Mo-Barakat/Master-Thesis/Figures/Mechanical Assembly/body_printing.jpg

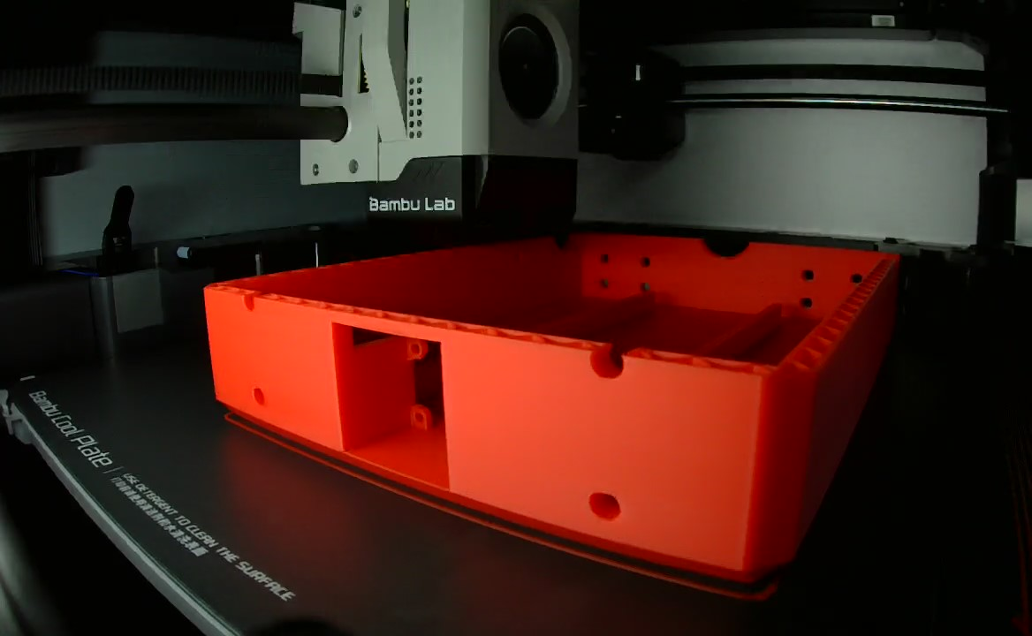
Figures/Mechanical Assembly/body_printing.jpg
