Mo-Barakat/Master-Thesis/Figures/Mechanical Assembly/chassis_assembled.jpg

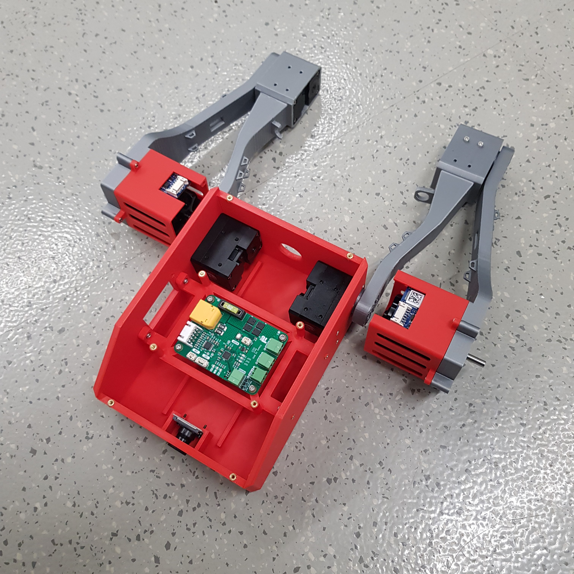
Figures/Mechanical Assembly/chassis_assembled.jpg
