Mo-Barakat/Master-Thesis/Content/Design.tex

\chapter{Random(Erase)}

\graphicspath{{./Figures/Design}}

\begin{itemize}
	\item hardware.
	\begin{itemize}
		\item motors
			\begin{itemize}
				\item Hip motor is enclosed in the body.
				\item the knee motors are enclosed in cover.
				\item the wheels motors have a
			\end{itemize}
		\item wiring
		\begin{itemize}
			\item where the wires are neatly fastened in a predetermined route so that it wouldn't be caught in the robot movement which would cause damage to the robot and also to protect them from damage.
			\item the correct type were used to avoid overheating upon the draw of current from the divers.
			\item Rs-485 connection between motors where used to avoid additional cables.
		\end{itemize}

		\item proximity sensor
		\begin{itemize}
			\item  placed in the front and back side of the robot would help to detect crashing in trivial positions such as running into a wall and that could be easily prevented by proximity sensor monitoring the distance between the robot the and the obsticals in it direction.
		\end{itemize}

		\item body safety additional parts in case of impact to protect the internal components.
	\end{itemize}
	\item software.

\end{itemize}

Questions to answer in each section

\begin{enumerate}
	\item what is going to be in here?
	\item how long or how elaborate?
	\item what is the purpose (the take home message)?
\end{enumerate}

Table of content Draft
\begin{enumerate}
	\item Introduction
	\begin{enumerate}
		\item Background and Motivation
		\begin{enumerate}
			\item Discuss the evolution and significance of robotics in various industries.
			\item Emphasize the need for advancements in robotic stability and mobility.
		\end{enumerate}

		\item Problem Statement
		\begin{enumerate}
			\item Define the specific challenges in designing a legged self-balancing robot.
		\end{enumerate}
		\item Objectives(Outline the primary goals of the thesis)
	\end{enumerate}
	\item Literature Review
	\begin{enumerate}
		\item Overview of Robotics
		\item Previous Work in Self-Balancing Robots
		\item Control Strategies
		\begin{enumerate}
			\item what is going to be in here? a comparison of the control strategies used.
			\item how long or how elaborate? not too detailed but with more explanation of the control theory used in the project
			\item what is the purpose (the take home message)? pros and cons of the different and why would we prefer one of them over the other depending on the applications
		\end{enumerate}
	\end{enumerate}
	\item Design and Development of the Robot
	\begin{enumerate}
		\item Mechanical Design
		\begin{enumerate}
			\item Initial calculations
			\begin{enumerate}
				\item what is going to be in here? -> torque initial calculations
				\item how long or how elaborate? -> two or three scenarios
				\item what is the purpose (the take home message)? for choosing the correct motors
			\end{enumerate}
			\item design
			\begin{enumerate}
				\item what is going to be in here?-> CAD design and the explanations of the challenges
				\item how long or how elaborate? detailed explanations of the reason behind the design decision
				\item what is the purpose (the take home message)? assembling the robot with fitting parts to match the new model requirements
			\end{enumerate}
			\item Modeling
			\begin{enumerate}
				\item what is going to be in here?-> the figures for the new model and the new COG and MOI calculations and the equations of motion.
				\item how long or how elaborate? 4 to 5 pages explaining the equations in details
				\item what is the purpose (the take home message)? showing the calculations for the new model and it would influence the equations of motion.
			\end{enumerate}
		\end{enumerate}
		\item Electrical Design
		\begin{enumerate}
			\item what is going to be in here? Component diagram showing the choice of all the components and there intended use and why we chose each of these components
			\item how long or how elaborate? detailed explanation of the  requirement boards for operating the robot, the choice of components based calculations for the motors.
			\item what is the purpose (the take home message)? show how the Electrical design is configured in the optimal way to operate the robot
		\end{enumerate}
		\item Software and Control
		\begin{enumerate}
			\item Control Algorithm
			\begin{enumerate}
				\item what is going to be in here?->flowchart of the Control Algorithm
				\item how long or how elaborate?-> detailed explanation of the used control theory
				\item what is the purpose (the take home message)? -> how the control is implemented
			\end{enumerate}
			\item Firmware
		\end{enumerate}
		\item Safety
		\begin{enumerate}
			\item what is going to be in here? different design changes for safety measures(motors covers, wire routing, body bumper, distance sensor , algorithm safety, electrical safety )
			\item how long or how elaborate? 1 or two pages max that include the
			\item what is the purpose (the take home message)? the safety measures taken to minimize crashes, failure
		\end{enumerate}
	\end{enumerate}
	\item Experimental Setup and Methodology
	\begin{enumerate}
		\item Simulation Environment
		\item Physical Prototype Testing
		\item Data Collection and Analysis
	\end{enumerate}
	\item Results and Discussion
	\begin{enumerate}
		\item Simulation Results
		\item Real-world Performance
		\item Comparison and Analysis
	\end{enumerate}
	\item Conclusion and Future Work
	\begin{enumerate}
		\item Summary of Findings
		\item Contributions
		\item Recommendations for Future Research
	\end{enumerate}
\end{enumerate}

\begin{todobox}
	content..
\end{todobox}
\begin{itemize}
	\item The Robot new design.
	\item The added degrees of freedom.
	\item Different motions that can be performed.
	\item Discussing each component of the robot and things taken into account while designing it.
	\begin{itemize}
		\item Body
		\begin{itemize}
		\item overall design inspiration
		\item For the body: the consideration for including all the necessary components in a compact form is to optimize the use of space and at the same time distribute the weight equally.
		\item The body includes the hip motors, the battery, camera, sensor, a rack that includes the motors drivers board, the micro-controller board attached to the Raspberry Pi.
		\item fastening features that were specifically designed in order to easily mount the battery, organize the cable between the boards and the rest of the robot parts.
		\item Features for modular design and easy printing.
		\end{itemize}
			\item Thigh
		\begin{itemize}
			\item curvature of that joint to give room for the motors 
			\item cable management 
			\item motor cover to insure its fixation. 
		\end{itemize}
			\item Calf
		\begin{itemize}
			\item curvature of that joint and the thigh joint combined make enough room for the wheel motor so the it have clearance from the body. 
			\item cable management 
			\item motor mount and additional frame.
		\end{itemize}
	\end{itemize}
\end{itemize}

\begin{itemize}
	\item electronic components 
	\begin{itemize}
		\item Motors taking into count the needed torque and speed
		\item comparison between the BLDC and Geared Robotic 
		\item RS-485 communications protocol compared to others 
		\begin{itemize}
			\item for the knee and hip motors high torque and low speed is needed.(calculations the show the weights and the needed torques)
			\item for the wheel motors high speed and low torque is needed. 
		\end{itemize}
		\item Boards 
		\begin{itemize}
			\item STM high performance h7 constum board connected with rasberrypi 
			\item driver board that provide the power for 6 motors. 
		\end{itemize}
		\item modules 
		\begin{itemize}
			\item camera module.
			\item distance sensor.
		\end{itemize}
	\end{itemize}
\end{itemize}

\begin{itemize}
	\item hardware.
	\begin{itemize}
		\item motors
			\begin{itemize}
				\item Hip motor is enclosed in the body.
				\item the knee motors are enclosed in cover.
				\item the wheels motors have a
			\end{itemize}
		\item wiring
		\begin{itemize}
			\item where the wires are neatly fastened in a predetermined route so that it wouldn't be caught in the robot movement which would cause damage to the robot and also to protect them from damage.
			\item the correct type were used to avoid overheating upon the draw of current from the divers.
			\item Rs-485 connection between motors where used to avoid additional cables.
		\end{itemize}

		\item proximity sensor
		\begin{itemize}
			\item  placed in the front and back side of the robot would help to detect crashing in trivial positions such as running into a wall and that could be easily prevented by proximity sensor monitoring the distance between the robot the and the obsticals in it direction.
		\end{itemize}

		\item body safety additional parts in case of impact to protect the internal components.
	\end{itemize}
	\item software.

\end{itemize}

Questions to answer in each section

\begin{enumerate}
	\item what is going to be in here?
	\item how long or how elaborate?
	\item what is the purpose (the take home message)?
\end{enumerate}

Table of content Draft
\begin{enumerate}
	\item Introduction
	\begin{enumerate}
		\item Background and Motivation
		\begin{enumerate}
			\item Discuss the evolution and significance of robotics in various industries.
			\item Emphasize the need for advancements in robotic stability and mobility.
		\end{enumerate}

		\item Problem Statement
		\begin{enumerate}
			\item Define the specific challenges in designing a legged self-balancing robot.
		\end{enumerate}
		\item Objectives(Outline the primary goals of the thesis)
	\end{enumerate}
	\item Literature Review
	\begin{enumerate}
		\item Overview of Robotics
		\item Previous Work in Self-Balancing Robots
		\item Control Strategies
		\begin{enumerate}
			\item what is going to be in here? a comparison of the control strategies used.
			\item how long or how elaborate? not too detailed but with more explanation of the control theory used in the project
			\item what is the purpose (the take home message)? pros and cons of the different and why would we prefer one of them over the other depending on the applications
		\end{enumerate}
	\end{enumerate}
	\item Design and Development of the Robot
	\begin{enumerate}
		\item Mechanical Design
		\begin{enumerate}
			\item Initial calculations
			\begin{enumerate}
				\item what is going to be in here? -> torque initial calculations
				\item how long or how elaborate? -> two or three scenarios
				\item what is the purpose (the take home message)? for choosing the correct motors
			\end{enumerate}
			\item design
			\begin{enumerate}
				\item what is going to be in here?-> CAD design and the explanations of the challenges
				\item how long or how elaborate? detailed explanations of the reason behind the design decision
				\item what is the purpose (the take home message)? assembling the robot with fitting parts to match the new model requirements
			\end{enumerate}
			\item Modeling
			\begin{enumerate}
				\item what is going to be in here?-> the figures for the new model and the new COG and MOI calculations and the equations of motion.
				\item how long or how elaborate? 4 to 5 pages explaining the equations in details
				\item what is the purpose (the take home message)? showing the calculations for the new model and it would influence the equations of motion.
			\end{enumerate}
		\end{enumerate}
		\item Electrical Design
		\begin{enumerate}
			\item what is going to be in here? Component diagram showing the choice of all the components and there intended use and why we chose each of these components
			\item how long or how elaborate? detailed explanation of the  requirement boards for operating the robot, the choice of components based calculations for the motors.
			\item what is the purpose (the take home message)? show how the Electrical design is configured in the optimal way to operate the robot
		\end{enumerate}
		\item Software and Control
		\begin{enumerate}
			\item Control Algorithm
			\begin{enumerate}
				\item what is going to be in here?->flowchart of the Control Algorithm
				\item how long or how elaborate?-> detailed explanation of the used control theory
				\item what is the purpose (the take home message)? -> how the control is implemented
			\end{enumerate}
			\item Firmware
		\end{enumerate}
		\item Safety
		\begin{enumerate}
			\item what is going to be in here? different design changes for safety measures(motors covers, wire routing, body bumper, distance sensor , algorithm safety, electrical safety )
			\item how long or how elaborate? 1 or two pages max that include the
			\item what is the purpose (the take home message)? the safety measures taken to minimize crashes, failure
		\end{enumerate}
	\end{enumerate}
	\item Experimental Setup and Methodology
	\begin{enumerate}
		\item Simulation Environment
		\item Physical Prototype Testing
		\item Data Collection and Analysis
	\end{enumerate}
	\item Results and Discussion
	\begin{enumerate}
		\item Simulation Results
		\item Real-world Performance
		\item Comparison and Analysis
	\end{enumerate}
	\item Conclusion and Future Work
	\begin{enumerate}
		\item Summary of Findings
		\item Contributions
		\item Recommendations for Future Research
	\end{enumerate}
\end{enumerate}

\begin{todobox}
	content..
\end{todobox}
