Mo-Barakat/Master-Thesis/Settings/Projekteinstellungen.tex

% Front matter
\newcommand*{\Titel}{Design and Control of a Multi-Joint Two-Wheeled Inverted Pendulum Robot for Agile Motion Learning}
\newcommand*{\Untertitel}{Exploiting Similarity for Data-Driven Input Trajectory Transfer}
% Header title
\newcommand*{\HeaderTitel}{Design and Control of a Multi-Joint Two-Wheeled Inverted Pendulum Robot}

% Main author
%\newcommand*{\Autor}{Philipp Drebinger}
\newcommand*{\AutorMatrikelNr}{10044038}

\newcommand{\Autor}%                % Author's name
{Mohamed Barakat}
\newcommand{\Matrikelnummer}%       % Matriculation number
{10044038}
\newcommand{\Datum}%                % Submission date
{15. January 2024}

\newcommand{\TitelDerArbeit}%       % Title of the work
{Design and Control of a Multi-Joint Two-Wheeled Inverted Pendulum Robot for Agile Motion Learning}

\newcommand{\Kennnummer}%           % Here enter the identifier number of the work. You will receive this shortly before submission from your supervisor
%{M-MM/JJJJ-XXXXX}
{M-01/2024-1234}
%{M-Month/Year-Number}

\newcommand{\ArtDerArbeit}%         % Type of work. Please enter whether Master's thesis, Bachelor's thesis, or study thesis
{Master's thesis} 
%{Bachelor's thesis}
%{Study thesis}

\newcommand{\Erstpruefer}%          % Enter the name of the first examiner here
{Prof. Dr.-Ing. Thomas Seel}
\newcommand{\Zweitpruefer}%         % Enter the name of the second examiner here
{Prof. Dr.-Ing. J\"org Wallaschek}
\newcommand{\Betreuer}%             % Enter the name of the research assistant supervisor here
{Dustin Lehmann}

% Manually set date with location
%\newcommand*{\Datum}{Berlin, the 16th of March 2023}

% University, faculty, institute, and department
\newcommand*{\Uni}{Technische Universit\"at Berlin}
\newcommand*{\Fakultaet}{Fakult\"at IV}
\newcommand*{\Institut}{Institut f\"ur Energie- und  Automatisierungstechnik}
\newcommand*{\Fachgebiet}{Control Systems Group}

% Professor and supervisor
\newcommand*{\Professor}{Prof. Dr.-Ing. J\"org Raisch}
\newcommand*{\ProfessorII}{Prof. Dr.-Ing. Clemens G\"uhmann}
\newcommand*{\BetreuerA}{M.Sc. Dustin Marlon Lehmann}
\newcommand*{\BetreuerB}{}

% Additional authors
\newcommand*{\AutorB}{}
\newcommand*{\AutorBMatrikelNr}{}
\newcommand*{\AutorC}{}
\newcommand*{\AutorCMatrikelNr}{}
\newcommand*{\AutorD}{}
\newcommand*{\AutorDMatrikelNr}{}
\newcommand*{\AutorE}{}
\newcommand*{\AutorEMatrikelNr}{}

% Group indication or just "submitted by:"
\newcommand*{\Gruppe}{by}

% Setting the print version: print or PDF view only
\def\typeDrucken{1}  % For printing (do not change)
\def\typePDFonly{2}  % For PDF-only use (do not change)
% Set the appropriate switch here! =\typeDrucken or =\typePDFonly
\let\pdftype=\typeDrucken

% Definition of whether to set single or double-sided
\def\typeOnepage{1}  % For single-sided setting
\def\typeTwopage{2}  % For double-sided setting
% Set the appropriate switch here! =\typeOnepage or =\typeTwopage
\let\pagetype=\typeOnepage

% Binding correction at the inner margin
\newlength{\bindCorrection}                % Declaration, do not change
\setlength{\bindCorrection}{0cm}           % Assignment, can be changed

% PDF output version via Minor number => 1.x
\pdfminorversion=5

% CUSTOM
% Colorful: 1, Plain: 2
\def\colorfulLayout{1}
