Mo-Barakat/Master-Thesis/Content/BodyMatter.tex

% Page numbers of the content in Arabic numerals
\pagenumbering{arabic}

% Content

% Inserting the files, e.g.:
%\include{Content/Introduction}
%\include{Content/Chapter1}
%\include{Content/Conclusion}

% Then insert chapters in the files.
% % % % % % % % % % % % % % % % % % % % % % % % % % % % % % % % % % % % % % % % % % % % % % %
\input{Content/Introduction}
\input{Content/Literature Review}
\input{Content/Mechanical Design}
\input{Content/Electronic Design}
\input{Content/Modelling and Simulation}
\input{Content/Mechanical Assembly}
\input{Content/Firmware and Testing}
\input{Content/Conclusion and Future work}
%\input{Content/Safety}
%\input{Content/Design}
% % % % % % % % % % % % % % % % % % % % % % % % % % % % % % % % % % % % % % % % % % % % % % %

% Conclude Body Matter
\clearpage
