Mo-Barakat/Master-Thesis/FrontBackMatter/BackMatter.tex

% Roman numerals for Back Matter - continue page numbering from Front Matter
\pagenumbering{Roman}
\addtocounter{RomanNumbers}{1}
\setcounter{page}{\value{RomanNumbers}}

% If desired, uncomment the index
\printindex

% If desired, uncomment the bibliography
\bibliography{Bibliographie/Bibliographie}

% Conclude Back Matter
\clearpage
