Mo-Barakat/Master-Thesis/FrontBackMatter/Erklaerung.tex

\chapter*{Eigenst\"andigkeitserkl\"arung}
\label{cha:Ehrenwort}
\thispagestyle{empty}
Hiermit erkl\"are ich, dass ich die vorliegende Arbeit selbstst\"andig und eigenh\"andig sowie ohne
unerlaubte fremde Hilfe und ausschlie\ss lich unter Verwendung der aufgef\"uhrten Quellen und
Hilfsmittel angefertigt habe.

\vspace{3cm}

\begin{tabular}{lp{4em}l}
 \hspace{4cm}   && \hspace{4cm} \\ \cline{1-1} \cline{3-3} \rule{0pt}{3.5ex} 
 Ort, Datum     && \Autor
\end{tabular}
