Mo-Barakat/Master-Thesis/Glossary/Abkuerzungen.tex

% Beispiel für eine Abkürzung: 
% \newacronym{led}{LED}{light-emitting diode}

\newacronym[longplural={lower-triangular Toeplitz matrices}]{lttm}{LTTM}{lower-triangular Toeplitz matrix}

\newacronym{lti}{LTI}{linear time-invariant}

\newacronym{lqr}{LQR}{linear-quadratic regulator}

\newacronym{siso}{SISO}{single-input single-output}

\newacronym{ipc}{IPC}{inverted pendulum on a cart}

\newacronym{twipr}{TWIPR}{two-wheeled inverted pendulum robot}

\newacronym{ilc}{ILC}{iterative learning control}

\newacronym{pca}{PCA}{principle component analysis}

\newacronym{svd}{SVD}{singular value decomposition}

\newacronym{nrmse}{NRMSE}{normalized root-mean-square error}

\newacronym{nrms}{NRMS}{normalized root-mean-square}

\newacronym{rmse}{RMSE}{root-mean-square error}

\newacronym{rms}{RMS}{root-mean-square}

\newacronym{mas}{MAS}{multi-agent system}

\newacronym{prbs}{PRBS}{pseudorandom binary sequence}

\newacronym{bibo}{BIBO}{bounded-input bounded-output}

\newacronym{gp}{GP}{Gaussian Process}

\newacronym{rc}{RC}{remote control}

%\newacronym{todo}{\textbf{ToDo \hfill}}{To-Do List}%just to keep track of todo boxes
