Mo-Barakat/Master-Thesis/out/Master_Thesis.pdf

# Institut für Mechatronische Systeme

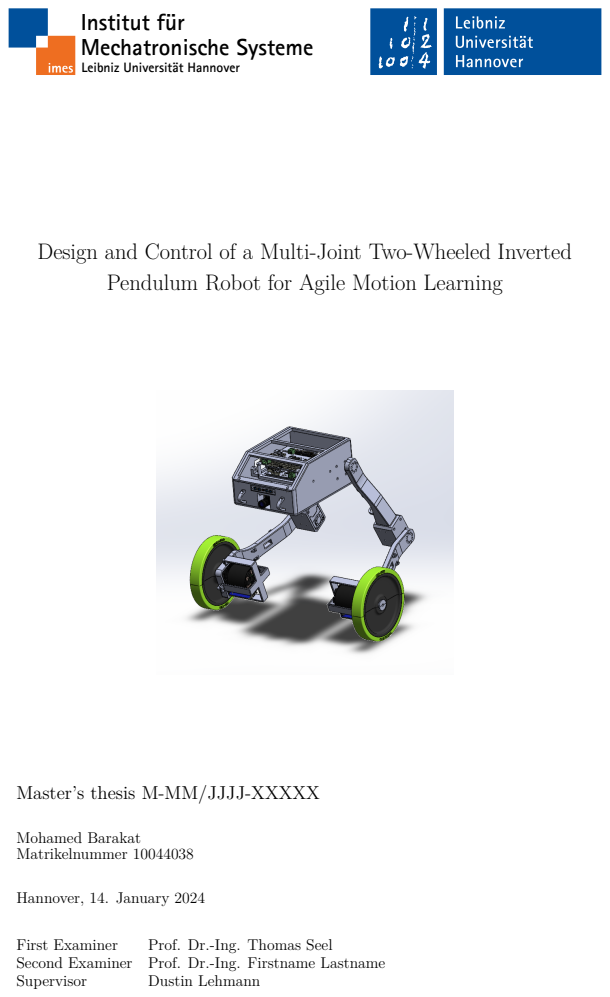
[picture p3: page 1]
Mohamed Barakat Matrikelnummer 10044038; Hannover, 14. January 2024; First Examiner; Prof. Dr.-Ing. Thomas Seel; Supervisor; Dustin Lehmann

Leibniz Universität Hannover

Design and Control of a Multi-Joint Two-Wheeled Inverted

Pendulum Robot for Agile Motion Learning

Master’s thesis M-MM/JJJJ-XXXXX

Second Examiner Prof. Dr.-Ing. Firstname Lastname

# Institut für Mechatronische Systeme

## Leibniz Universität Hannover

# Declaration of Authorship

## M-MM/JJJJ-XXXXX

Name: | Mohamed Barakat
Registration no.: | 10044038
Thesis title: | Design and Control of a Multi-Joint Two-Wheeled Inverted Pendulum
| Robot for Agile Motion Learning
Type of thesis: | Master’s thesis
Study program: | Mechanical Engineering
Submission date: | 14. January 2024
First examiner : | Prof. Dr.-Ing. Thomas Seel
Second examiner: | Prof. Dr.-Ing. Firstname Lastname
Supervisor: | Dustin Lehmann

I, Mohamed Barakat, hereby affirm that the Master’s thesis entitled Design and Control of a Multi-Joint Two-Wheeled Inverted Pendulum Robot for Agile Motion Learning was written independently, that no references and aids other than those indicated were used, that all passages of the thesis which were taken over literally or analogously from other sources are marked as such and that the thesis has not yet been presented to any examination board in the same or similar form.

I hereby agree to the transmission of my work also to external services for plagiarism checking by plagiarism software.

Hannover, 14. January 2024

(Mohamed Barakat)

# Eigenständigkeitserklärung

Hiermit erkläre ich, dass ich die vorliegende Arbeit selbstständig und eigenhändig sowie ohne unerlaubte fremde Hilfe und ausschließlich unter Verwendung der aufgeführten Quellen und Hilfsmittel angefertigt habe.

Ort, Datum | Mohamed Barakat

Abstract

This thesis addresses the challenge of input trajectory transfer in heterogeneous multi-agent systems, where each agent has distinct system dynamics.
The concept of transfer learning has been applied to MAS to accelerate the learning process of a target agent by leveraging previously learned trajectories from a different source agent. However, directly transferring input trajectories between agents with dissimilar dynamics can lead to unwanted behaviour. This can be overcome by applying a mapping that transforms the input trajectory of the source system into an appropriate input trajectory for a target system so that their outputs match. Obtaining such an input transfer map from simple experiments is difficult, so previous research often focuses on output transfer, adaptive control or strong similarity assumptions. Those approaches either require extensive model knowledge or have limited usability.

This thesis provides a comprehensive understanding of trajectory transfer, distinguishing the input and output transfer cases and highlighting their similarities. Those insights are then used to propose a simple, data-driven method to estimate a dynamic input transfer map for SISO systems that addresses the aforementioned problem. Structural similarity in the systems is leveraged to simplify the estimation process further. The transfer map is estimated as a lifted system matrix and a transfer function. The performance of the estimated dynamic input transfer map is compared to a static map using a simple gain and to the direct transfer of the input trajectories.

It is shown that input and output transfer are equivalent under certain conditions. An input transfer map based on this assumption was able to significantly reduce the differences between a source and a target system in three simulated scenarios. This even includes scenarios where the systems have nonlinear, non-minimum phase dynamics.
Compared to a static map, the performance of a dynamic input transfer is superior, especially in cases where the estimated transfer map is applied to input trajectories which are not part of the training data. Furthermore, the dynamic input transfer map can have a model order lower than the theoretically expected order of the transfer system, given that the source and target systems are related. Therefore, the expected order only provides an upper limit for the order of an estimated transfer map, and not a recommended choice.
Nonetheless, this thesis alone does not fully explore the potential and limitations of the proposed method. Future research is necessary to address these topics further.

Keywords— input transfer, trajectory transfer, transfer learning, multi-agent systems

Design and Control of a Multi-Joint Two-Wheeled Inverted Pendulum Robot | VI

# Contents

List of Figures | VIII
List of Tables | IX
1 Introduction | 1
2 Literature Review | 3
3 Mechanical Design | 4
4 Electronic Design | 6
5 Modelling and Simulation | 7
6 Mechanical Assembly | 13

Contents

Design and Control of a Multi-Joint Two-Wheeled Inverted Pendulum Robot | VII
7 Firmware and Testing | 14
8 Safety | 16
9 Random(Erase) | 19
Bibliography | X

Contents

Design and Control of a Multi-Joint Two-Wheeled Inverted Pendulum Robot | VIII

# List of Figures

5.1 Mechanical model with the local coordinate system | | 9
5.2 Moment of inertia Schematic representation | | 10
9.1 Moment of inertia Schematic representation | | 19
9.2 Moment of inertia Schematic representation | | 21

List of Figures

Design and Control of a Multi-Joint Two-Wheeled Inverted Pendulum Robot | IX

# List of Tables

5.1 Parameters of the mechanical system | 12

List of Tables

Design and Control of a Multi-Joint Two-Wheeled Inverted Pendulum Robot | 1

# 1 Introduction

## 1.1 Motivation

This section should explore the underlying reasons for undertaking the research. It might include the importance of the topic, the gap in current knowledge, and the potential applications of the research findings.

Robotics has always been a cutting-edge field that combines sophisticated engineering, artificial intelligence, and a comprehension of human-environment interactions. This study is motivated by multiple important elements, all of which highlight the importance and relevance of the research.

Advancements in Robotic Technologies: Robotics has grown at an exponential rate over the past few decades, resulting in improved capabilities and more applications. Previously limited to industrial settings, robots are now being deployed in increasingly dynamic and unpredictable circumstances. The development of robotic systems that are more flexible, nimble, and intelligent is required due to this evolution. Our research is to create a sophisticated multi-legged robotic system that can perform intricate movements and interact with its surroundings.

Filling Knowledge Gaps: Even with significant advancements, there are still many unanswered questions about robotic control and locomotion, particularly in systems that replicate biological structures and processes. Complex dynamic tasks that living beings handle with ease are sometimes difficult for traditional robotic systems to accomplish. This research aims to close these gaps by concentrating on a multi-legged robot that finds inspiration in the natural environment. This will provide insights into more realistic and effective movement tactics.

Potential for Broad Impact: The applications of such advanced robotic systems are vast and varied, ranging from search and rescue operations in hazardous environments to assistive technology in healthcare. By pushing the boundaries of what is currently possible in robotic design and control, this research has the potential to make significant contributions to fields where human intervention is limited, dangerous, or impractical.

Interdisciplinary Collaboration and Innovation: This project is inherently interdisciplinary, integrating concepts from mechanical engineering, computer science, control theory, and even biology. Such cross-disciplinary collaboration is crucial for driving innovation, as it allows for the exchange of ideas and methods from diverse fields. This approach is expected to yield novel solutions and advancements that could extend well beyond the scope of this project.

In summary, the motivation for this project lies in its potential to advance the field of robotics, fill existing knowledge gaps, have a broad societal impact, and foster interdisciplinary collaboration. By developing a multi-legged robotic system with enhanced movement capabilities and control strategies, this research endeavors to set new standards in robotic design and functionality.

Chapter 1. Introduction

Design and Control of a Multi-Joint Two-Wheeled Inverted Pendulum Robot | 2

## 1.2 Explanation of the Goals and Requirements

Here, you should clearly outline the objectives and aims of the research. This might include specific technical goals, hypotheses to be tested, or particular research questions to be addressed. Also, detail any specific requirements necessary for the research, such as technological needs, data requirements, or theoretical frameworks.

Chapter 1. Introduction – Explanation of the Goals and Requirements

Design and Control of a Multi-Joint Two-Wheeled Inverted Pendulum Robot | 3

# 2 Literature Review

## 2.1 Overview of Two-Wheeled Inverted Pendulum Robots

## 2.2 Prior Works and Advances in Multi-Legged Robotic Systems

This section should provide a comprehensive review of existing literature relevant to your research topic. It should cover key theories, models, experiments, and findings in the field, particularly focusing on works that directly relate to your research question or hypothesis. This review not only shows your understanding of the field but also how your work fits into and contributes to the existing body of knowledge.

## 2.3 State-of-the-Art in Robotic Control Systems

Chapter 2. Literature Review

Design and Control of a Multi-Joint Two-Wheeled Inverted Pendulum Robot | 4

# 3 Mechanical Design

Modeling In this chapter, the details of the mechanical design is presented. where it goes from the initial conceptual design to the final design showing in the process the design decision-making for each critical point.This chapter emphasis the detailed description of the precise placement and alignment of different components such as the motors, wheels, battery, boards, and others to maintain the seamless integration of all the components into the robot body.
The mechanical design serves as an important pillar to define the new physical form, size, and shape of the TWIPR. Depending on how these criteria are defined, the robot would interact with the environment. taking into account that the design directly influences the center of gravity which is crucial to consider in our robot due to the inverted pendulum nature to be able to balance and maintain the upright position. In addition to the impact that the design has on the maneuverability of the robot and how it would respond to the control signals to be able to execute a task.

Chapter 3. Mechanical Design

Design and Control of a Multi-Joint Two-Wheeled Inverted Pendulum Robot | 5

## 3.1 Design Objectives and Requirements

The main objective is to come up with a new design for a multiple joints Robot to perform complex dynamic movements. this robot would be based on the Two wheeled inverted pendulum robot. The new design would add more degrees of freedom to enable the more complex movements.This enhances the robot capabilities where it can execute more diverse scenarios. Initially the main requirement was to add more two degrees of freedom where originally it used to have one degree of freedom in the wheels.The new design has three degrees of freedom one in the wheels, one as a knee joint and one as a hip joint. The current design has two identical legs.

## 3.2 Conceptual Design

As for the initial design concepts the body was that main point of focus as shown in the figure.Three initial designs where considered mainly for the body. Symmetrical horizontal body, leaning forwardsbody, and symetrical vertical body. For the three designs two independant legs where considered. two designs where considered for the legs the normal joint leg and the complient leg

## 3.3 Detailed Design Development

- Elaborate on the development of the detailed mechanical design.
- Discuss material selection and the rationale behind these choices.
- Include detailed CAD drawings and design schematics.

## 3.4 Design for Manufacturability and Assembly

- Discuss how the design facilitates manufacturing and assembly..
- Explain any design choices made to simplify these processes of manufacturing and assembly.

## 3.5 Prototyping and Iterative Design

- Discuss the process of prototyping.
- Explain how feedback from prototyping phases was incorporated into design revisions.

Chapter 3. Mechanical Design – Design Objectives and Requirements

Design and Control of a Multi-Joint Two-Wheeled Inverted Pendulum Robot | 6

# 4 Electronic Design

- Overview of the chapter’s focus.
- Emphasize the importance of electronic design in the context of the overall project.

## 4.1 Design Objectives and Constraints

- Clearly define the objectives and goals for the electronic design
- Discuss any constraints such as power requirements, size limitations.

## 4.2 Component Selection

- Detail the selection process for key electronic components like microcontrollers, sensors, actuators, power supplies, etc.
- Rationale behind the choice of each component, focusing on specifications and performance requirements.

## 4.3 Circuit Design

- Provide comprehensive information about the circuit design, including schematic diagrams.
- Explain the functionality and interaction of different circuit components.
- Discuss the design considerations for signal integrity, power distribution, and noise reduction.

## 4.4 PCB (Printed Circuit Board) Design

- Describe the layout and design of any custom PCBs used in the project.
- Include information about PCB fabrication and assembly processes.

## 4.5 Power Management

- Discuss how power is managed and distributed within the system.
- Include details on battery management, voltage regulation, and power efficiency considerations.

Chapter 4. Electronic Design

Design and Control of a Multi-Joint Two-Wheeled Inverted Pendulum Robot | 7

# 5 Modelling and Simulation

In this pivotal chapter, we meticulously derive the center of gravity and the moment of inertia for the two-wheeled self-balancing robot. These parameters are the linchpins of our dynamic analysis, serving as the critical variables within the equations of motion that govern the robot’s behavior. By calculating these values with precision, we can substitute them into our dynamic equations, thereby tailoring the model to reflect the true dynamics of the robot. This process not only enhances the accuracy of our simulations but also ensures that the control strategies developed are based on a robust and representative model of the robot’s physical capabilities. The careful derivation of these parameters is a testament to the thoroughness of our approach, ensuring that the resulting model is both reliable and predictive of the robot’s real-world performance.

Chapter 5. Modelling and Simulation

Design and Control of a Multi-Joint Two-Wheeled Inverted Pendulum Robot | 8

## 5.1 Mathematical Modelling

- TWIPR Model: Explanation of the Two-Wheeled Inverted Pendulum Robot (TWIPR) model.

The two wheeled Inverted Pendulum robot model is as shown in the figure where it consist of two legs that include a hip and knee joints as well as wheels at the end of each leg. the robot needs to constantly adjust it posture to be able to maintain the balance, just like how the humanbeing balance when standing on the feet.

- Focus on 2D Dynamics: Discussion on the scope limited to 2D dynamics and plans for future expansion to 3D dynamics and controller synthesis.
- Assumptions and Parameters: Detailing assumptions such as considering motor angles as parameters.
- Model Derivation for l_cg and I_y: Derivation of the models for center of gravity length (l_cg) and inertia around the y-axis (I_y).
- Integration into TWIPR Model: Integration of derived models into a new TWIPR framework.
- Linear Model Derivation: Derivation of the linear model from the integrated TWIPR model.
- Modeling allows for predictive analysis and understanding of the robot’s behavior.

In order to predict the behavior of the robot under different settings, the modeling procedure entails constructing mathematical representations of the robot’s dynamics and control systems.

Center of Gravity calculations

### 5.1.1 Center of Gravity

- in that section the calculations of the overall center of gravity
- Significance in Dynamics:The stability of an object is directly impacted by the COG position, which also affects how it reacts to forces and moments from the outside world.
- maintain equilibrium,
- accurately determining the COG is crucial for predicting and controlling dynamic behavior

in the above figure in order to simplify the deriviation of the center of

xCG =

mL1 · 0 + mK · 0 + mL2 · LC2 · sin(φ2) + mB · (L2 · sin(φ2) + LC3 · sin(φ2 + φ3)) mL1 + mL2 + mK + mB

(5.1)

yCG =

mL1 · LC1 + mK · L1 + mL2 · (L1 + LC2 · cos(φ2)) + mB · (L1 + L2 · cos(φ2) + LC3 · cos(φ2 + φ3)) mL1 + mL2 + mK + mB
(5.2)

LG =

√︁
x

2
CG + y

2
CG | (5.3)

θ = arctan (︂
xCG

yCG )︂
(5.4)

Chapter 5. Modelling and Simulation – Mathematical Modelling

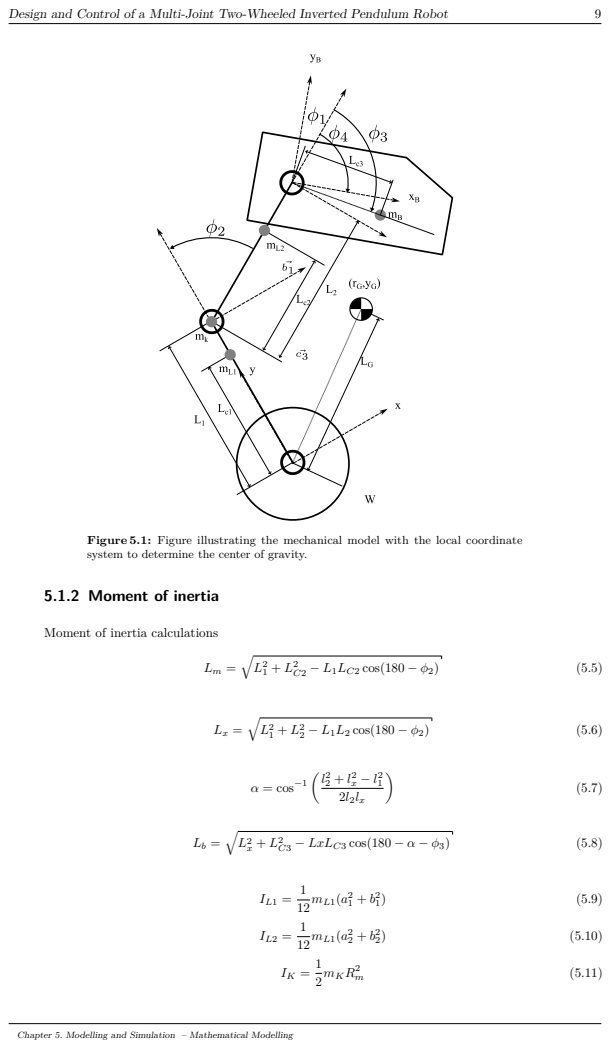
[picture p4: page 18]
Design and Control of a Multi-Joint Two-Wheeled Inverted Pendulum Robot; C2 − L1LC2 cos(180 − φ2); 2 − L1L2 cos(180 − φ2); α = cos⁻¹; C3 − LxLC3 cos(180 − α − φ3); mKR

Figure 5.1: Figure illustrating the mechanical model with the local coordinate
system to determine the center of gravity.

5.1.2 Moment of inertia

Moment of inertia calculations

Chapter 5. Modelling and Simulation – Mathematical Modelling

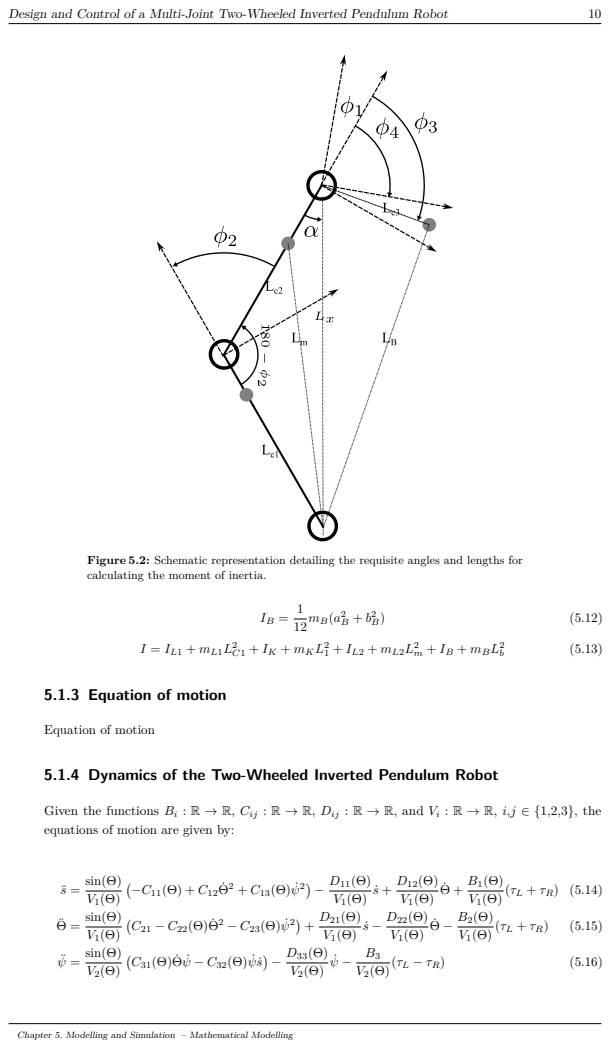
[picture p5: page 19]
Design and Control of a Multi-Joint Two-Wheeled Inverted Pendulum Robot; 2 C1 + IK + mKL; 2 m + IB + mBL; : R → R, i,j ∈ {1,2,3}, the; sin(Θ)

Figure 5.2: Schematic representation detailing the requisite angles and lengths for
calculating the moment of inertia.

5.1.3 Equation of motion

Equation of motion

5.1.4 Dynamics of the Two-Wheeled Inverted Pendulum Robot

Given the functions Bi
equations of motion are given by:

: R → R, Cij : R → R, Dij : R → R, and Vi

Chapter 5. Modelling and Simulation – Mathematical Modelling

Design and Control of a Multi-Joint Two-Wheeled Inverted Pendulum Robot | 11

The equations of motion are derived in [44]. The functions Bi

: R → R, Cij : R → R, Dij : R → R, and Vi

: R → R, i,j ∈ {1,2,3}, are given by:

C11(Θ) = m²
Bl

2
cos(Θ), | (5.17)

C12 = (I2 + mBl

2
)mBl, | (5.18)

C13(Θ) = (I2 + mBl

2
)mBl + mBl(I3 − I1 − mBl

2

) cos²
(Θ), | (5.19)

C21 = (mB + 2mW +

2J
r

2

)mBl, | (5.20)

C22(Θ) = m²
Bl

2
cos(Θ), | (5.21)

C23(Θ) = m²
Bl

2 + (mB + 2mW +

2J
r

2

)(I3 − I1 − mBl

2
) cos(Θ). | (5.22)

C31(Θ) = 2(I3 − I1 − m²
B) cos(Θ), | (5.23)
C31 = mBl, | (5.24)

D11(Θ) = (I2 + m²
B)2cα
r

2

−

mB cos(Θ)2cα
r
, | (5.25)

D12(Θ) = (I2 + m²
B)2cα
r
− 2mB cos(Θ)cα, | (5.26)

D21(Θ) = (mB + 2mW +

2J
r

2 )2cα
r

+

mB cos(Θ)2cα
r

2

, | (5.27)

D22(Θ) = (mB + 2mW +

2J
r

)2cα + mB cos(Θ)2cα
r
, | (5.28)
D33(Θ) = | d

2
2r

2cα

, | (5.29)

B1 =

(I2 + m²
B)

1
r + mB cos(Θ)
r
, | (5.30)

B2 =

mBl
r

− cos(Θ) + mB + 2mW +

2J
r

2

, | (5.31)

B3 =

d
2r
, | (5.32)

V1 = (mB + 2mW +

2J
r

2

)(I2 + m²

B) − m²

B cos²
(Θ), | (5.33)

V2 = I3 + 2K + (mW +

J
r

2

)

d

2
2

− (I3 − I1 − m²

B) sin²
(Θ). | (5.34)

## 5.2 Numerical Simulation

- Discrete Numerical Simulation: Elaboration on the process of discrete numerical simulation, including the discrete double integration method to arrive at the state vector.

## 5.3 Simulation Environment

- Overview of the Simulation Environment: A brief overview of the simulation environment, referencing David’s Bachelor Thesis for details.

Chapter 5. Modelling and Simulation – Numerical Simulation

Design and Control of a Multi-Joint Two-Wheeled Inverted Pendulum Robot | 12

Table 5.1: Parameters of the mechanical system

Parameter | Value | Description
mB | 2.5 kg | mass of the pendulum body
mW | 0.636 kg | mass of a wheel
l | 0.026 m | distance between the wheel axis and the pendulum’s center of gravity
d | - | distance between the two wheels
J | 5.175e
| −4 kgm² | moment of inertia of a wheel w.r.t. reference frame {C} in direction of c2
K | - | moment of inertia of a wheel w.r.t. reference frame {C} in direction of c3
I1 | - | moment of inertia of pendulum’s body w.r.t. reference frame {B} in direction of b1
I2 | 0.0165 kgm² | moment of inertia of pendulum’s body w.r.t. reference frame {B} in direction of b2
I3 | - | moment of inertia of pendulum’s body w.r.t. reference frame {B} in direction of b3
cα | 4.630e
| −4 Nms | viscous friction coefficient
- Integration of the Model: Description of integrating the new TWIPR model into the simulation environment and a summary of the individual components of the model.

## 5.4 Controller Synthesis

- State-Space Controllers: Introduction to two state-space controllers: Linear Quadratic Regulator (LQR) and Pole-Placement.
- Configuration Specificity: Explanation of how these controllers are specific to one configuration (knee angle and hip angle) of the robot.
- Controller Retuning Algorithm: Presentation of an algorithm for retuning the controllers as the configuration changes.

## 5.5 Simulation Analysis

- Controller Responses: Analysis of step response and responses to other inputs using one of the controllers in different configurations.
- Impact of Non-Retuning: Discussion on the effects of not retuning the controllers.
- Influence of Leg Configuration: Analysis of how leg configuration influences the robot’s behavior.
- Controller Setting Comparisons: Comparative study of different controller settings and a comparison between LQR and Pole-Placement controllers.
- Optimal Controller Configuration: Conclusion on which controller configuration might be best suited for such a robot.

Chapter 5. Modelling and Simulation – Controller Synthesis

Design and Control of a Multi-Joint Two-Wheeled Inverted Pendulum Robot | 13

# 6 Mechanical Assembly

- Intro Overview of the chapter.
- Importance of mechanical assembly in the overall project.

## 6.1 Components Overview

- Detailed description of all mechanical components used in the robot.
- Source or method of fabrication for each component (e.g., machined parts, 3D printed elements).

## 6.2 Assembly Process

- Step-by-step explanation of the assembly process.
- Tools and techniques used in the assembly.
- Assembly sequence and rationale behind it.

## 6.3 Integration of Mechanical and Electronic Systems

- Discussion on how mechanical components interface with electronic systems.
- Challenges faced in integration and strategies employed to overcome them.

## 6.4 Troubleshooting and Problem Solving

- Discussion of any unexpected challenges or issues faced during assembly.
- How these issues were diagnosed and resolved.

## 6.5 Safety Considerations

- Safety measures taken during the assembly process.
- Design considerations for ensuring the operational safety of the robot.
- Discrete Numerical Simulation: Elaboration on the process of discrete numerical simulation, including the discrete double integration method to arrive at the state vector.

Note 6.1
the bolts used the problem to shorten them so that it wouldn’t touch the motor

Chapter 6. Mechanical Assembly

Design and Control of a Multi-Joint Two-Wheeled Inverted Pendulum Robot | 14

# 7 Firmware and Testing

- Overview of the chapter’s content and its significance in the context of the overall project.
- Briefly state the objectives of firmware development and testing procedures.

## 7.1 Firmware Development

- Discuss the development environment and tools used for firmware programming.
- Detail the architecture and design of the firmware, including flowcharts or state diagrams if applicable.
- Explain the implementation of key functionalities such as control algorithms, sensor integration, and actuator management.

## 7.2 Programming Languages and Tools

- List and describe the programming languages used for firmware development.
- Mention any specific software tools, libraries, or frameworks employed.

## 7.3 Integration with Hardware

- Discuss how the firmware interacts with and controls the hardware components.
- Explain any challenges encountered in integration and how they were resolved.

## 7.4 Testing Framework and Methodology

- Outline the testing framework used to validate the firmware.
- Describe the methodology for functional testing, including unit tests, integration tests, and system-level tests.

## 7.5 Test Cases and Scenarios

- Present the results of the testing procedures.
- Analyze these results, highlighting successful areas and identifying any issues or bugs discovered.

Chapter 7. Firmware and Testing

Design and Control of a Multi-Joint Two-Wheeled Inverted Pendulum Robot | 15

## 7.6 Debugging and Troubleshooting

- Discuss the process of debugging and troubleshooting encountered problems.
- Explain how issues were diagnosed and resolved.

Note 7.1
the bolts used the problem to shorten them so that it wouldn’t touch the motor

Chapter 7. Firmware and Testing – Debugging and Troubleshooting

Design and Control of a Multi-Joint Two-Wheeled Inverted Pendulum Robot | 16

# 8 Safety

- hardware.

– motors

∗ Hip motor is enclosed in the body.

∗ the knee motors are enclosed in cover.

∗ the wheels motors have a

– wiring

∗ where the wires are neatly fastened in a predetermined route so that it wouldn’t be caught in the robot movement which would cause damage to the robot and also to protect them from damage.

∗ the correct type were used to avoid overheating upon the draw of current from the divers.

∗ Rs-485 connection between motors where used to avoid additional cables.

– proximity sensor

∗ placed in the front and back side of the robot would help to detect crashing in trivial positions such as running into a wall and that could be easily prevented by proximity sensor monitoring the distance between the robot the and the obsticals in it direction.

– body safety additional parts in case of impact to protect the internal components.

- software.

Questions to answer in each section

1. what is going to be in here?
2. how long or how elaborate?
3. what is the purpose (the take home message)?

Table of content Draft

1. Introduction
a) Background and Motivation
i. Discuss the evolution and significance of robotics in various industries.

ii. Emphasize the need for advancements in robotic stability and mobility.

b) Problem Statement
i. Define the specific challenges in designing a legged self-balancing robot.
c) Objectives(Outline the primary goals of the thesis)

Chapter 8. Safety

Design and Control of a Multi-Joint Two-Wheeled Inverted Pendulum Robot | 17
2. Literature Review
a) Overview of Robotics
b) Previous Work in Self-Balancing Robots
c) Control Strategies
i. what is going to be in here? a comparison of the control strategies used.

ii. how long or how elaborate? not too detailed but with more explanation of the control theory used in the project

iii. what is the purpose (the take home message)? pros and cons of the different and why would we prefer one of them over the other depending on the applications

3. Design and Development of the Robot
a) Mechanical Design
i. Initial calculations
A. what is going to be in here? -> torque initial calculations
B. how long or how elaborate? -> two or three scenarios
C. what is the purpose (the take home message)? for choosing the correct motors

ii. design

A. what is going to be in here?-> CAD design and the explanations of the challenges
B. how long or how elaborate? detailed explanations of the reason behind the design decision
C. what is the purpose (the take home message)? assembling the robot with fitting parts to match the new model requirements

iii. Modeling

A. what is going to be in here?-> the figures for the new model and the new COG and MOI calculations and the equations of motion.
B. how long or how elaborate? 4 to 5 pages explaining the equations in details
C. what is the purpose (the take home message)? showing the calculations for the new model and it would influence the equations of motion.
b) Electrical Design
i. what is going to be in here? Component diagram showing the choice of all the components and there intended use and why we chose each of these components

ii. how long or how elaborate? detailed explanation of the requirement boards for operating the robot, the choice of components based calculations for the motors.

iii. what is the purpose (the take home message)? show how the Electrical design is configured in the optimal way to operate the robot

c) Software and Control
i. Control Algorithm

Chapter 8. Safety –

Design and Control of a Multi-Joint Two-Wheeled Inverted Pendulum Robot | 18
A. what is going to be in here?->flowchart of the Control Algorithm
B. how long or how elaborate?-> detailed explanation of the used control theory
C. what is the purpose (the take home message)? -> how the control is implemented

ii. Firmware

d) Safety
i. what is going to be in here? different design changes for safety measures(motors covers, wire routing, body bumper, distance sensor , algorithm safety, electrical safety )

ii. how long or how elaborate? 1 or two pages max that include the

iii. what is the purpose (the take home message)? the safety measures taken to minimize crashes, failure

4. Experimental Setup and Methodology
a) Simulation Environment
b) Physical Prototype Testing
c) Data Collection and Analysis
5. Results and Discussion
a) Simulation Results
b) Real-world Performance
c) Comparison and Analysis
6. Conclusion and Future Work
a) Summary of Findings
b) Contributions
c) Recommendations for Future Research

content..

Chapter 8. Safety –

Design and Control of a Multi-Joint Two-Wheeled Inverted Pendulum Robot | 19

# 9 Random(Erase)

This comprehensive chapter unfolds the intricate details of the new design of our two-wheeled self-balancing robot, an advanced piece of engineering that incorporates additional degrees of freedom to enhance its movement capabilities. Through an exploration of the various motions the robot can perform, we delve into the intricate design considerations of each component, ensuring that they align with the overall functional and aesthetic vision.

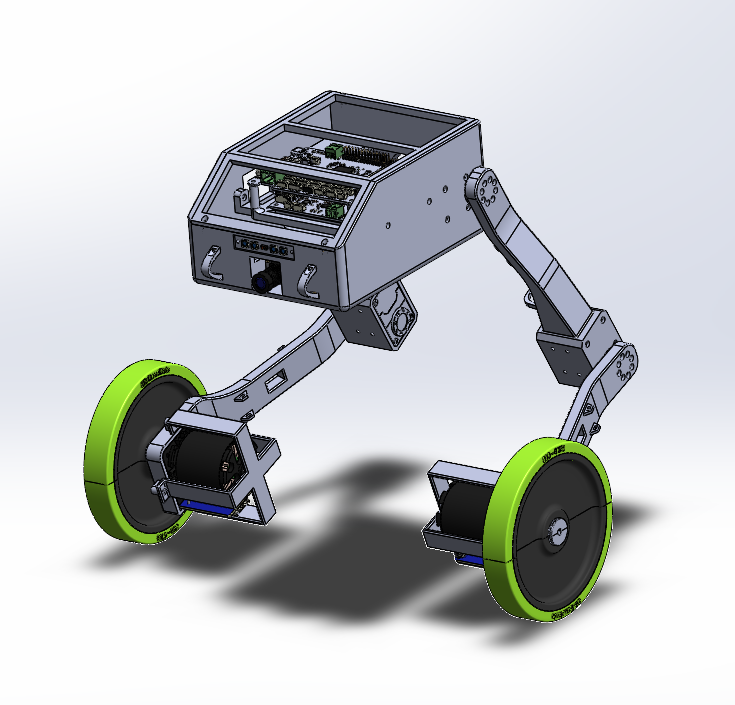
[picture p6: figure]

Figure 9.1: Schematic representation detailing the requisite angles and lengths for calculating the moment of inertia.

Chapter 9. Random(Erase)

Design and Control of a Multi-Joint Two-Wheeled Inverted Pendulum Robot | 20
- The Robot new design.
- The added degrees of freedom.
- Different motions that can be performed.
- Discussing each component of the robot and things taken into account while designing it.

– Body

∗ overall design inspiration

∗ For the body: the consideration for including all the necessary components in a compact form is to optimize the use of space and at the same time distribute the weight equally.

∗ The body includes the hip motors, the battery, camera, sensor, a rack that includes the motors drivers board, the micro-controller board attached to the Raspberry Pi.

∗ fastening features that were specifically designed in order to easily mount the battery, organize the cable between the boards and the rest of the robot parts.

∗ Features for modular design and easy printing.

– Thigh

∗ curvature of that joint to give room for the motors

∗ cable management

∗ motor cover to insure its fixation.

– Calf

∗ curvature of that joint and the thigh joint combined make enough room for the wheel motor so the it have clearance from the body.

∗ cable management

∗ motor mount and additional frame.

Chapter 9. Random(Erase) –

Design and Control of a Multi-Joint Two-Wheeled Inverted Pendulum Robot | 21

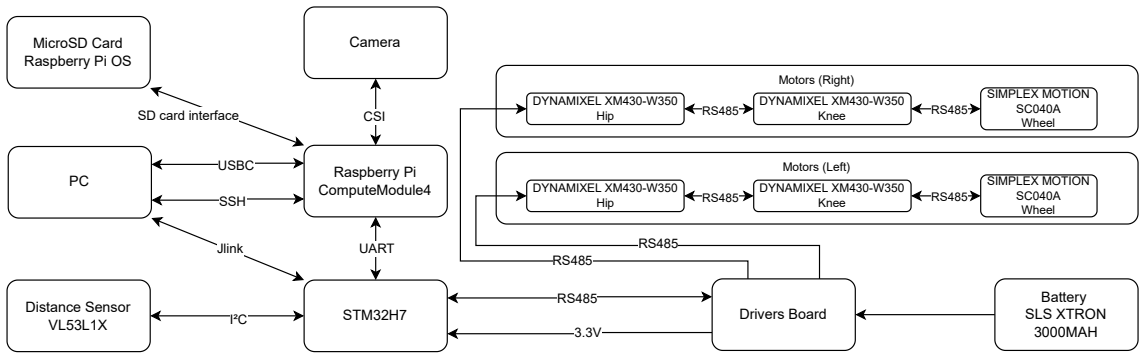
[picture p7: figure]
I²C; STM32H7; SSH; SD card interface; UART; Raspberry Pi ComputeModule4; CSI; Camera; Drivers Board; Battery SLS XTRON 3000MAH; USBC; Jlink; Distance Sensor VL53L1X; MicroSD Card Raspberry Pi OS; Motors (Right); DYNAMIXEL XM430-W350; Knee; SIMPLEX MOTION SC040A Wheel; Hip; Motors (Left)

Figure 9.2: Schematic representation detailing the requisite angles and lengths for calculating the moment of inertia.

- electronic components

– Motors taking into count the needed torque and speed

– comparison between the BLDC and Geared Robotic

– RS-485 communications protocol compared to others

∗ for the knee and hip motors high torque and low speed is needed.(calculations the show the weights and the needed torques)

∗ for the wheel motors high speed and low torque is needed.

– Boards

∗ STM high performance h7 constum board connected with rasberrypi

∗ driver board that provide the power for 6 motors.

– modules

∗ camera module.

∗ distance sensor.

Chapter 9. Random(Erase) –

Design and Control of a Multi-Joint Two-Wheeled Inverted Pendulum Robot | X

# Bibliography

Bibliography
