Mo-Barakat/Master-Thesis/Settings/Bibliographie.tex

%% Wissenschaftliches Zitieren
%\usepackage{natbib}
%
%% Anpassen des Zitierstils
%\bibpunct{[}{]}{;}{a}{}{,~}
%% Eckige Klammern verwenden, mehrere Quellenangbaben durch Simikolon trennen, Autor-Jahr-Zitierweise verwenden (a), Zwischen Autor und Jahr kein Zeichen einfügen sowie bei Unterdrückung der mitarbeitenden Autoren ein Komma verwenden
%
%% Naturwissenschftlicher der DIN angelehnter Zitierstil
%\bibliographystyle{natdin}	

% For egnlish citations with numbers
\usepackage[numbers, square, sort, compress]{natbib}
\bibliographystyle{unsrtnat}
%\usepackage{bibgerm}
%\usepackage{cite} % for multiple references in one bracket
