Mo-Barakat/Master-Thesis/Figures/Mechanical Design/Leg Design.pdf

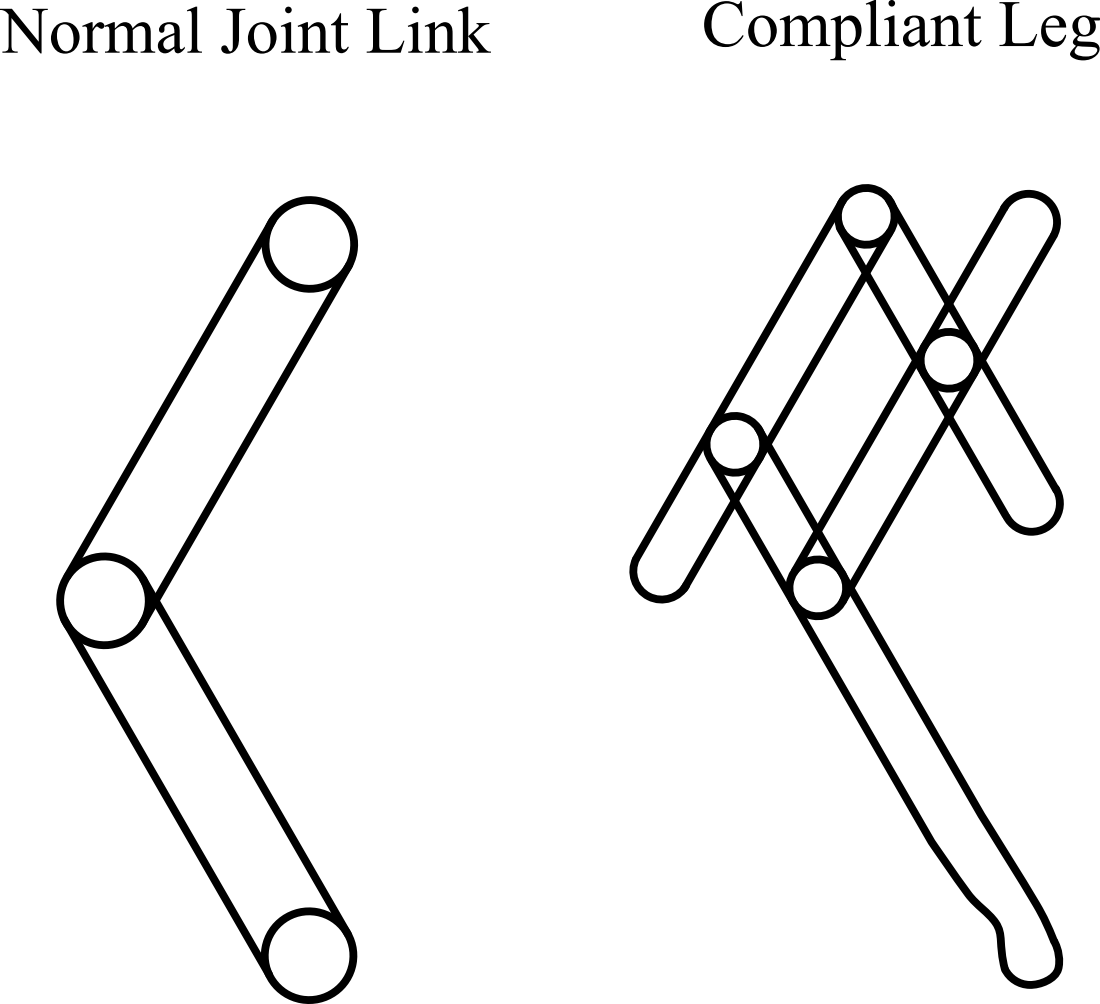
[picture p8: page 1]
