Mo-Barakat/Master-Thesis/Figures/Modelling and Simulation/S.pdf

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

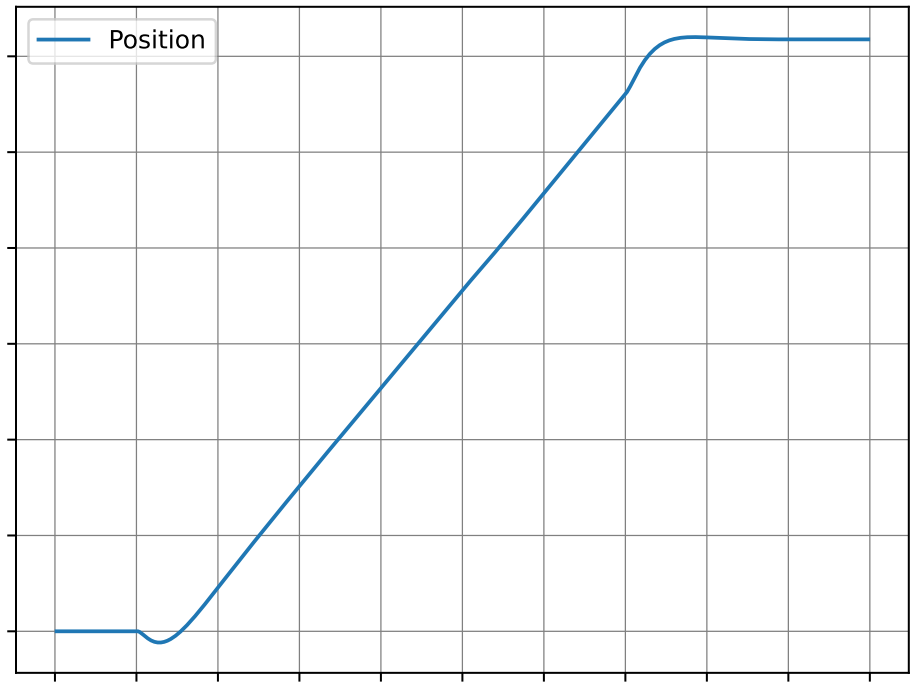
[picture p9: figure]
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
