Mo-Barakat/Master-Thesis/Figures/Modelling and Simulation/Psi.pdf

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

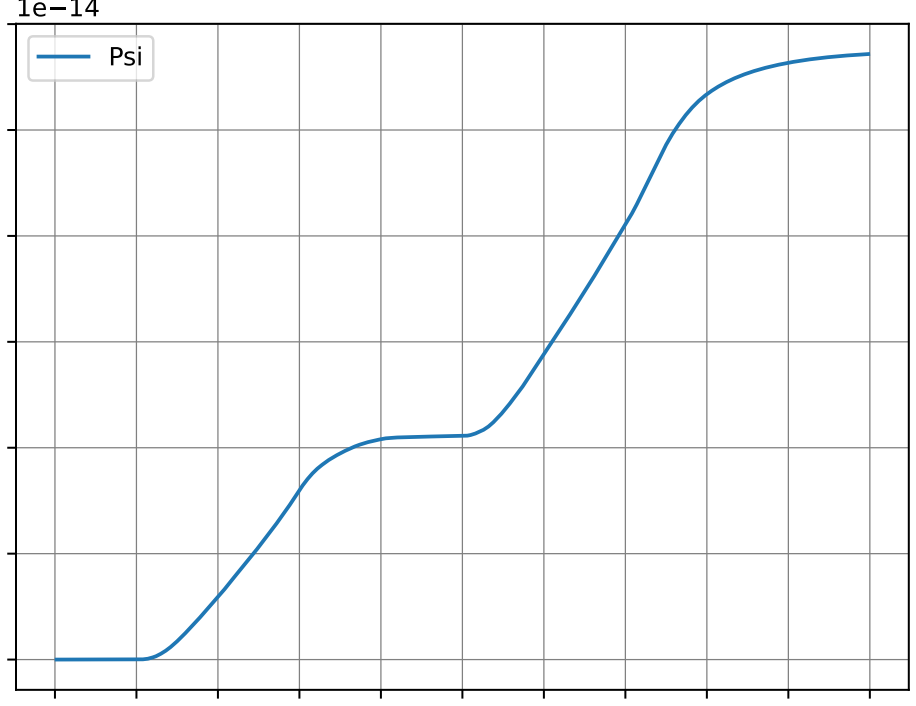
[picture p11: figure]
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
