Mo-Barakat/Master-Thesis/Figures/Modelling and Simulation/Retuned VS not retuned angels effect.pdf

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

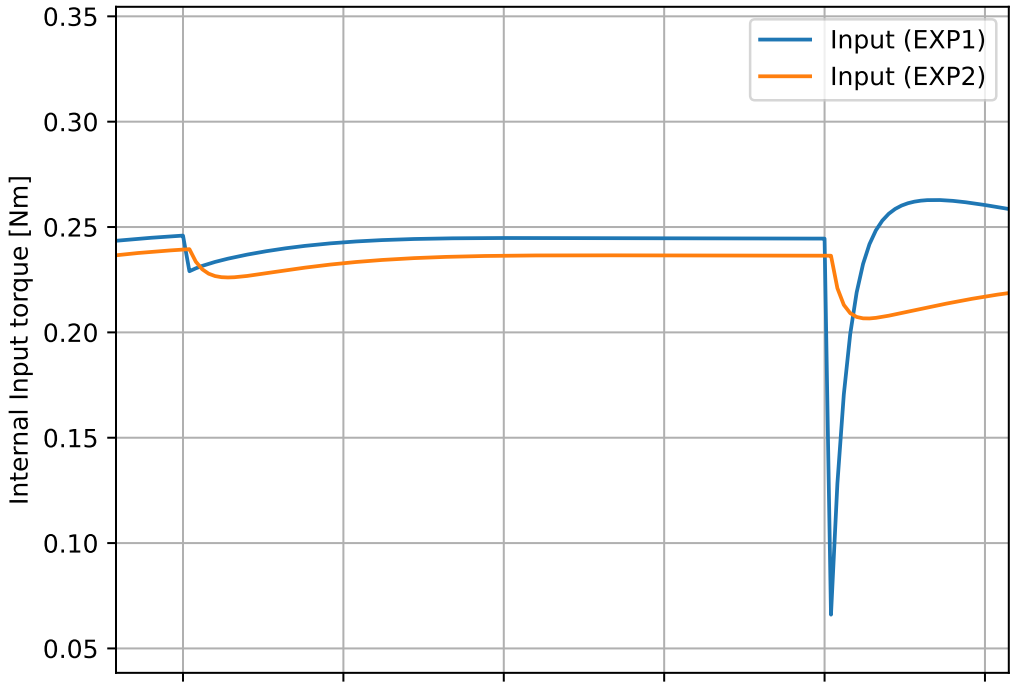
[picture p12: figure]
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
