Mo-Barakat/Master-Thesis/Figures/Modelling and Simulation/Theta_dot.pdf

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

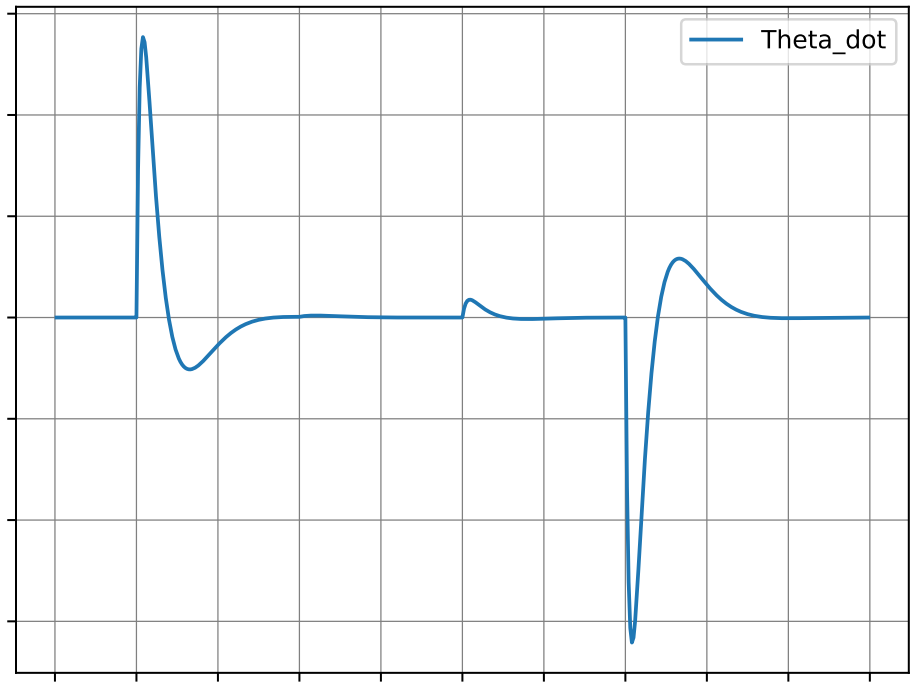
[picture p14: figure]
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
