Mo-Barakat/Master-Thesis/Figures/Modelling and Simulation/New model.pdf

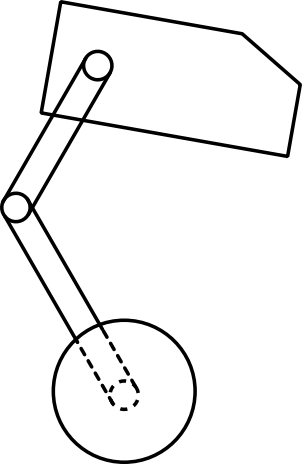
[picture p16: figure]
