Mo-Barakat/Master-Thesis/Figures/Modelling and Simulation/Old model.pdf

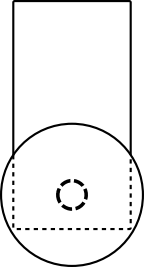
[picture p17: figure]
