Mo-Barakat/Master-Thesis/Figures/Electronic Design/Power_Management_Board.jpg

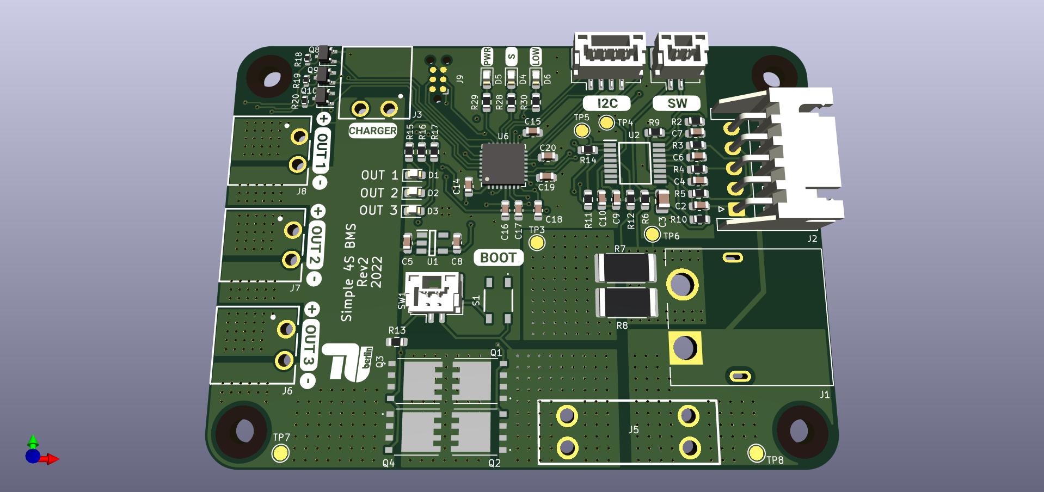
Figures/Electronic Design/Power_Management_Board.jpg
