Mo-Barakat/Master-Thesis/Figures/Electronic Design/Raspberry_Pi_4_compute_module.jpg

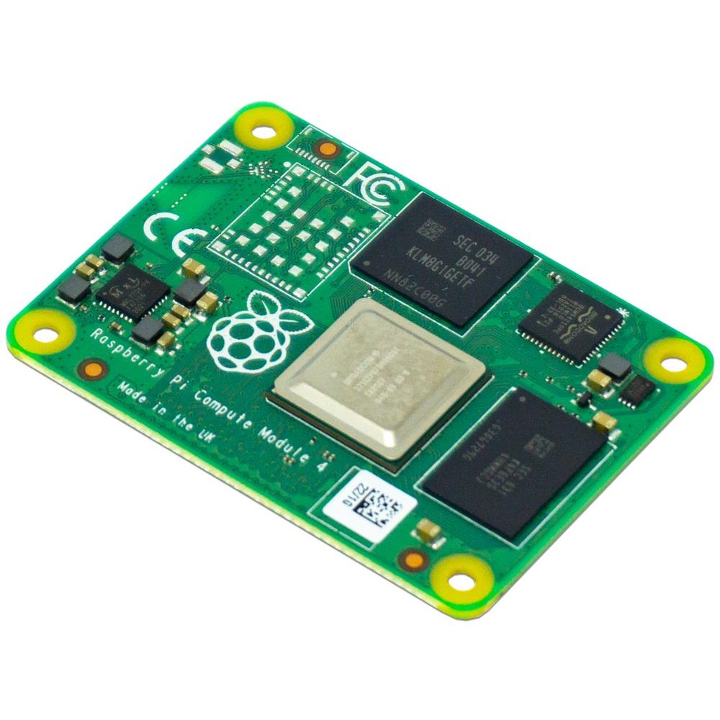
Figures/Electronic Design/Raspberry_Pi_4_compute_module.jpg
