Mo-Barakat/Master-Thesis/Figures/Electronic Design/Raspberry_Pi_Camera_Module_V2.jpg

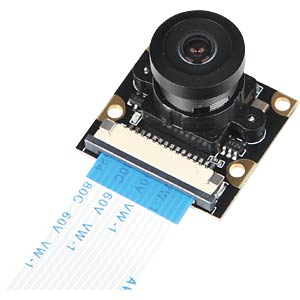
Figures/Electronic Design/Raspberry_Pi_Camera_Module_V2.jpg
