Mo-Barakat/Master-Thesis/Figures/Electronic Design/Robot_Hub_Board.jpg

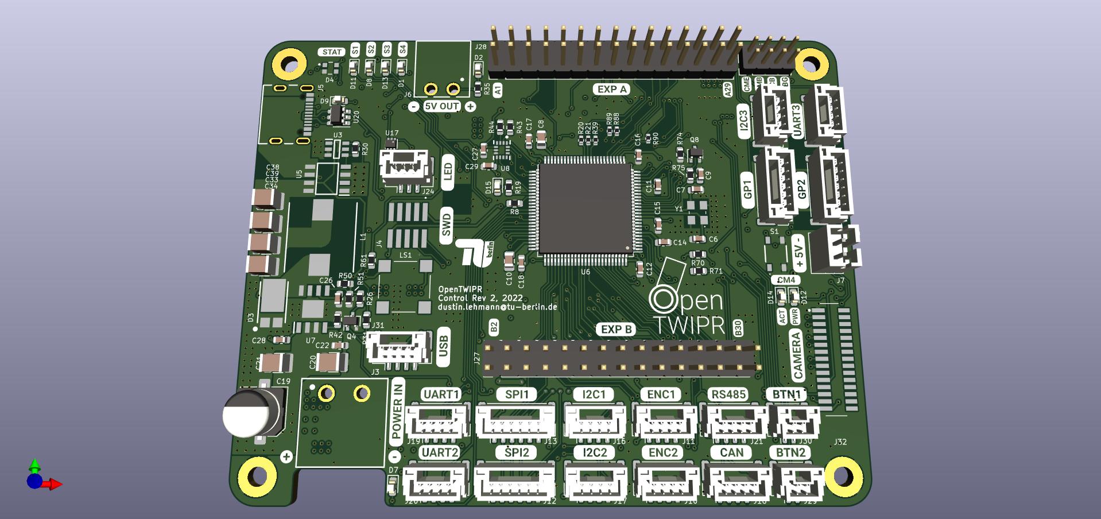
Figures/Electronic Design/Robot_Hub_Board.jpg
