Mo-Barakat/Master-Thesis/Figures/Electronic Design/SIMPLEX_MOTION_SC040A.png

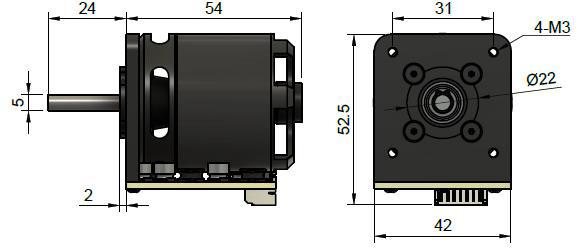
Figures/Electronic Design/SIMPLEX_MOTION_SC040A.png
