Mo-Barakat/Master-Thesis/Figures/Electronic Design/SLS_XTRON_3000MAH_4S1P.jpg

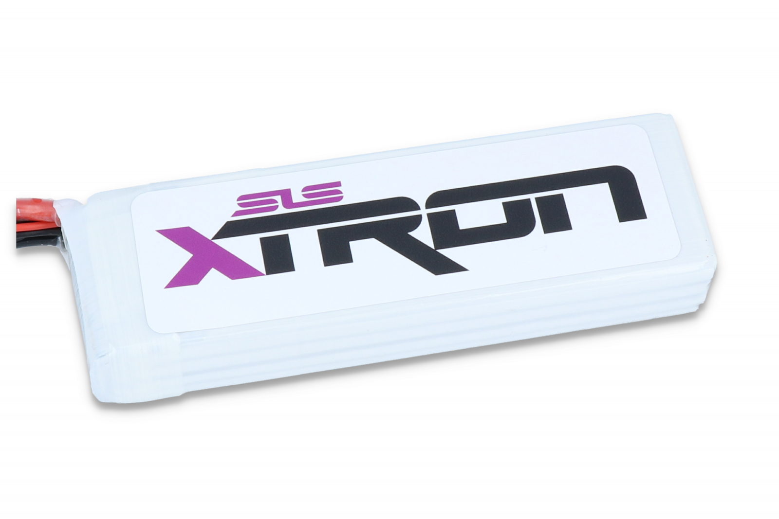
Figures/Electronic Design/SLS_XTRON_3000MAH_4S1P.jpg
