Mo-Barakat/Master-Thesis/Figures/Electronic Design/VL53L1X.PNG

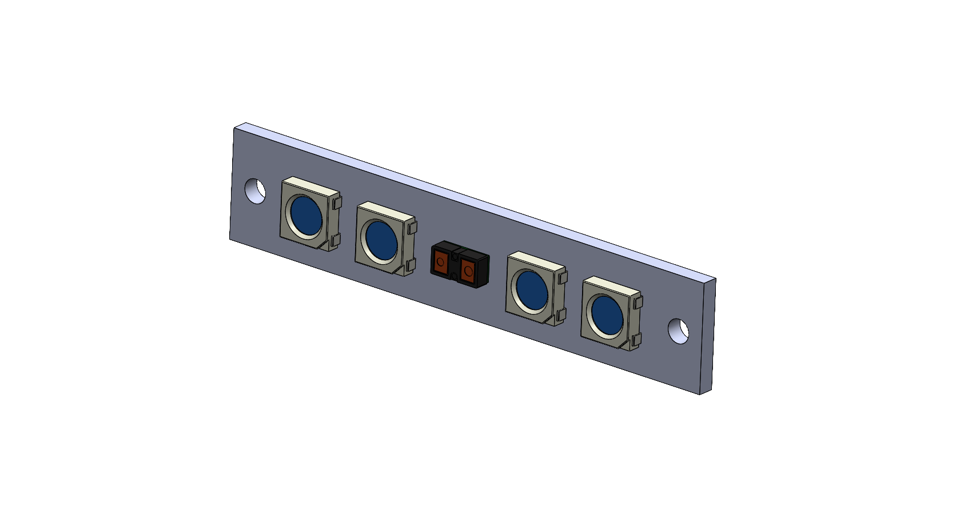
Figures/Electronic Design/VL53L1X.PNG
