Mo-Barakat/Master-Thesis/Figures/Firmware and Testing/Pinout & Configuration.PNG

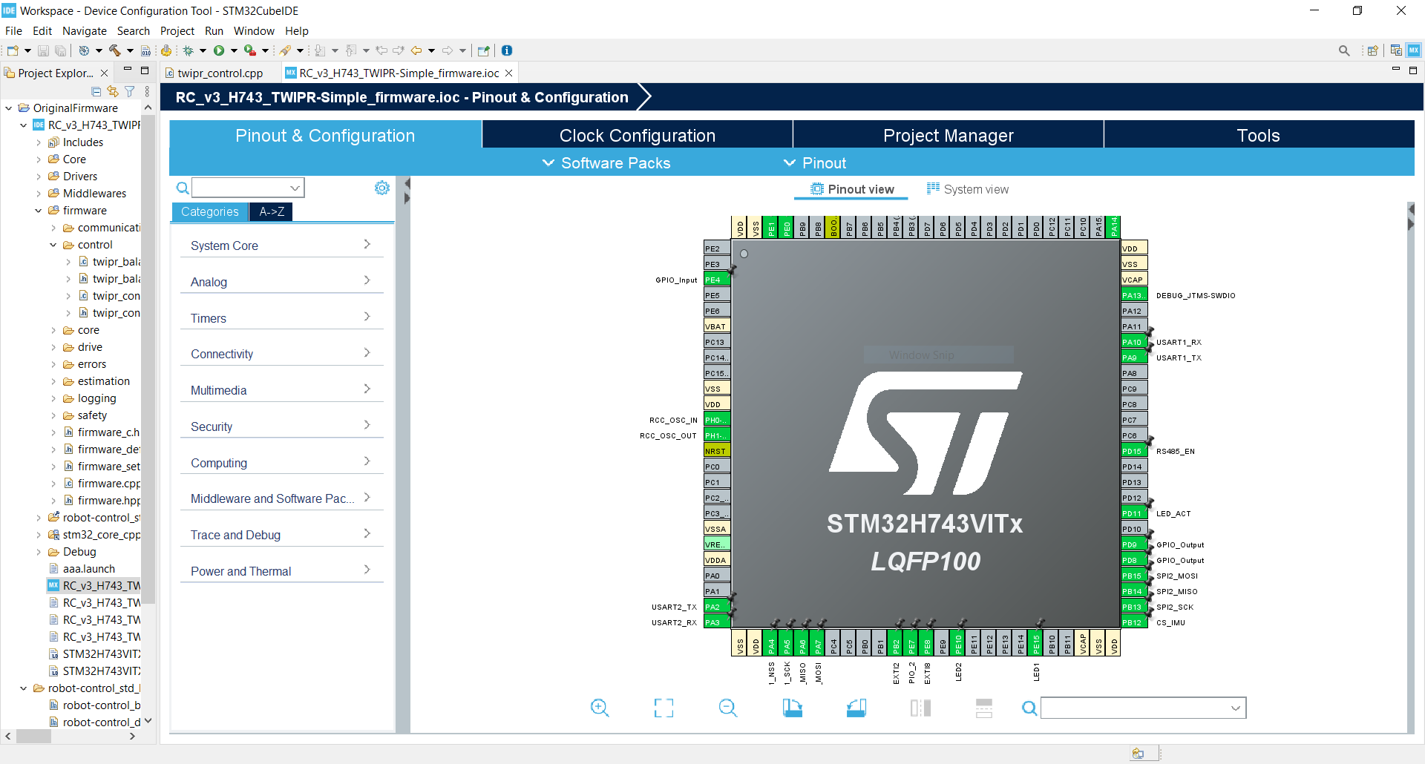
Figures/Firmware and Testing/Pinout & Configuration.PNG
