Mo-Barakat/Master-Thesis/Figures/Introduction/handle-3-1.jpg

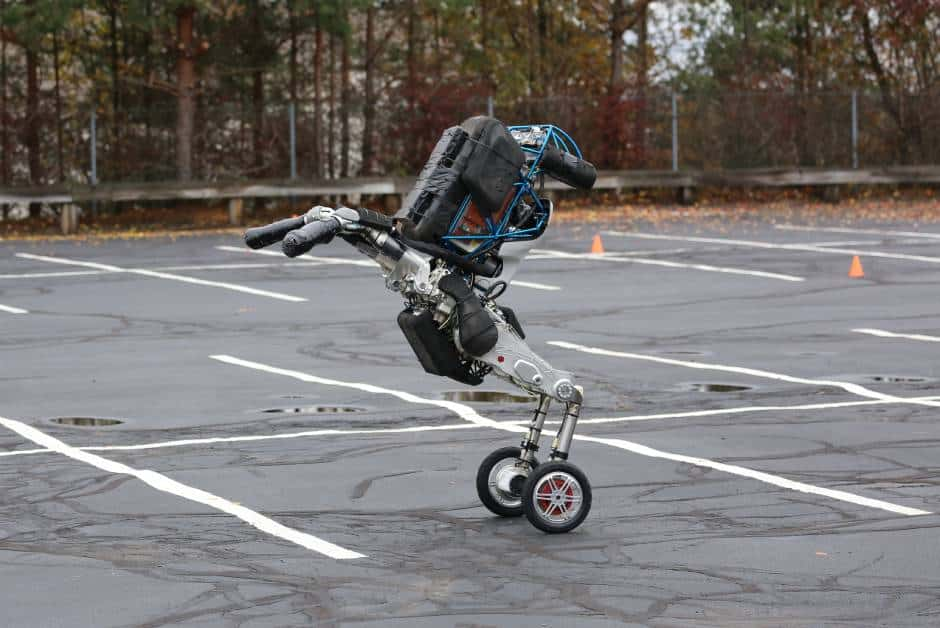
Figures/Introduction/handle-3-1.jpg
