Mo-Barakat/Master-Thesis/Figures/Literature Review/Ascento robot.jpg

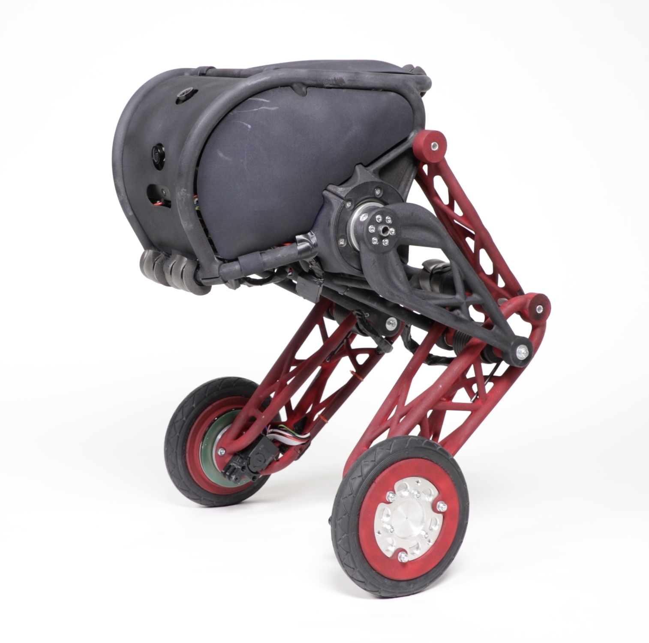
Figures/Literature Review/Ascento robot.jpg
