Mo-Barakat/Master-Thesis/Figures/Literature Review/Boston Dynamics' Atlas.jpg

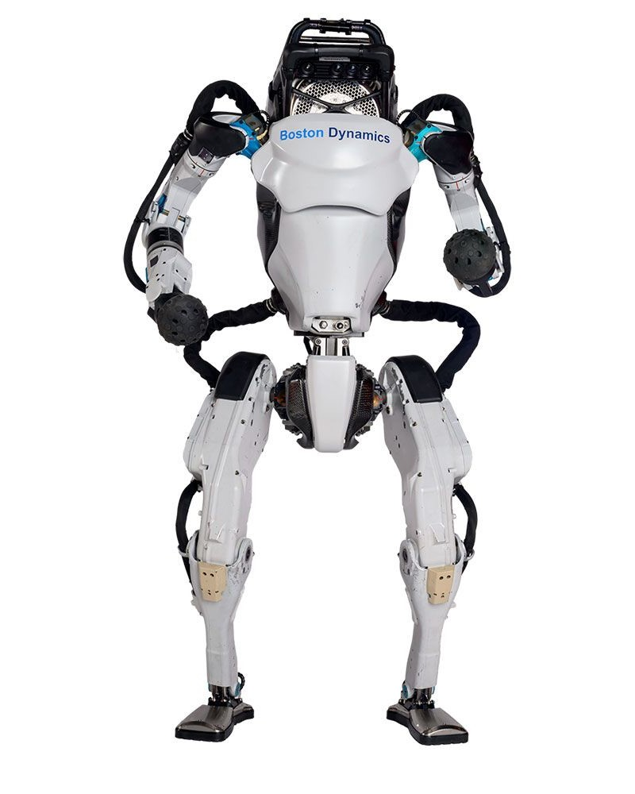
Figures/Literature Review/Boston Dynamics' Atlas.jpg
