Mo-Barakat/Master-Thesis/Figures/Literature Review/Honda's Asimo.jpg

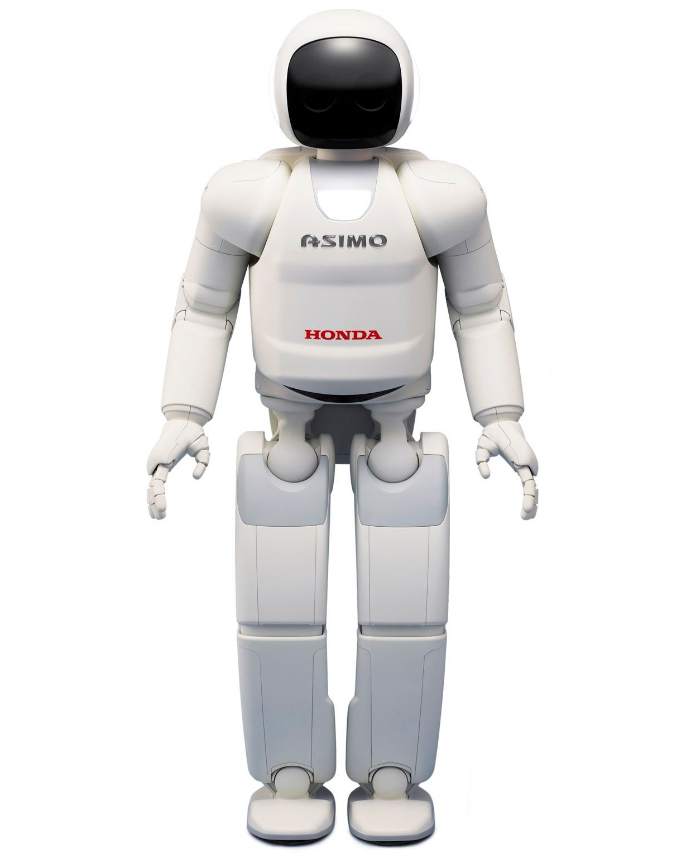
Figures/Literature Review/Honda's Asimo.jpg
