Mo-Barakat/Master-Thesis/Figures/Literature Review/sony QRIO.jpg

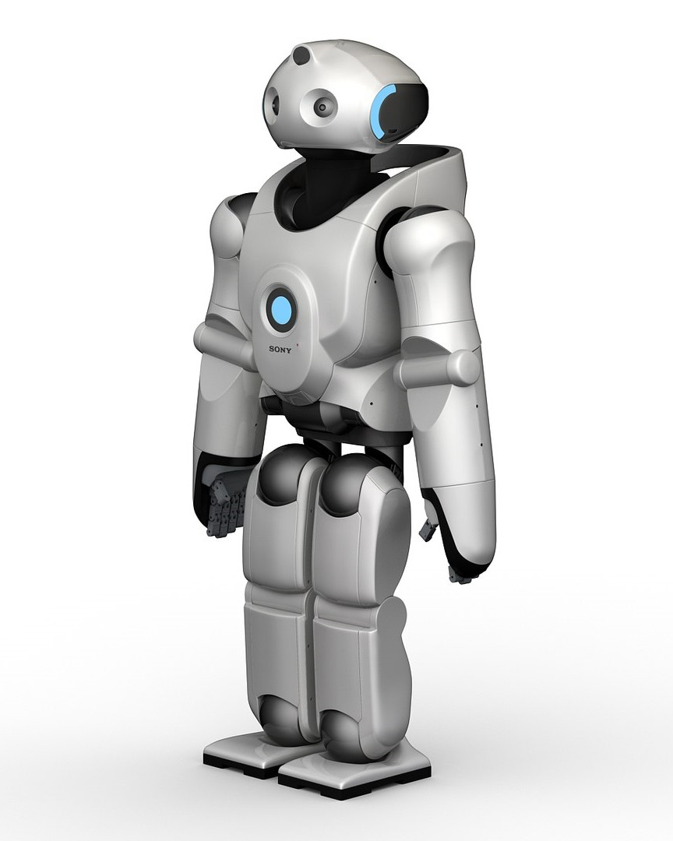
Figures/Literature Review/sony QRIO.jpg
