Mo-Barakat/Master-Thesis/Figures/Mechanical Assembly/electronics_mounted_on_board_mounting_rack.jpg

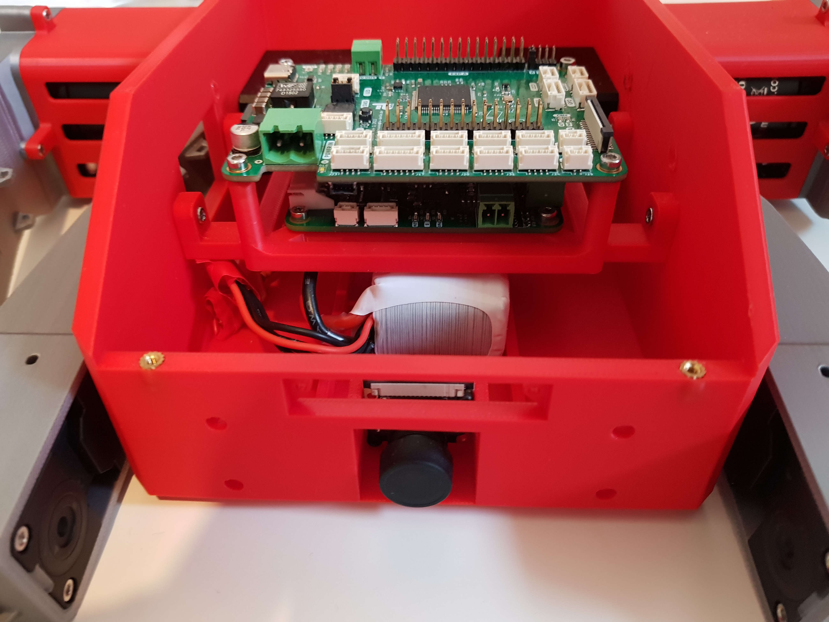
Figures/Mechanical Assembly/electronics_mounted_on_board_mounting_rack.jpg
