Mo-Barakat/Master-Thesis/Figures/Mechanical Design/Body_Design_1.PNG

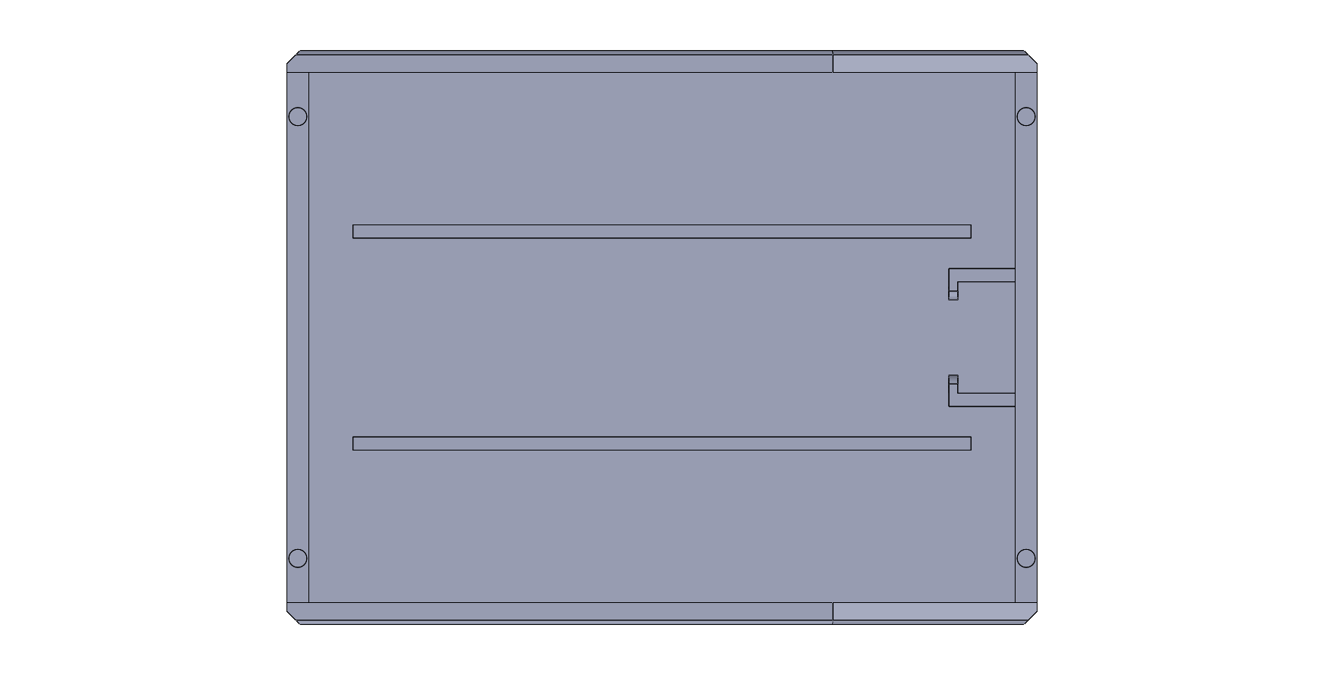
Figures/Mechanical Design/Body_Design_1.PNG
