Mo-Barakat/Master-Thesis/Figures/Mechanical Design/Body_Design_2.PNG

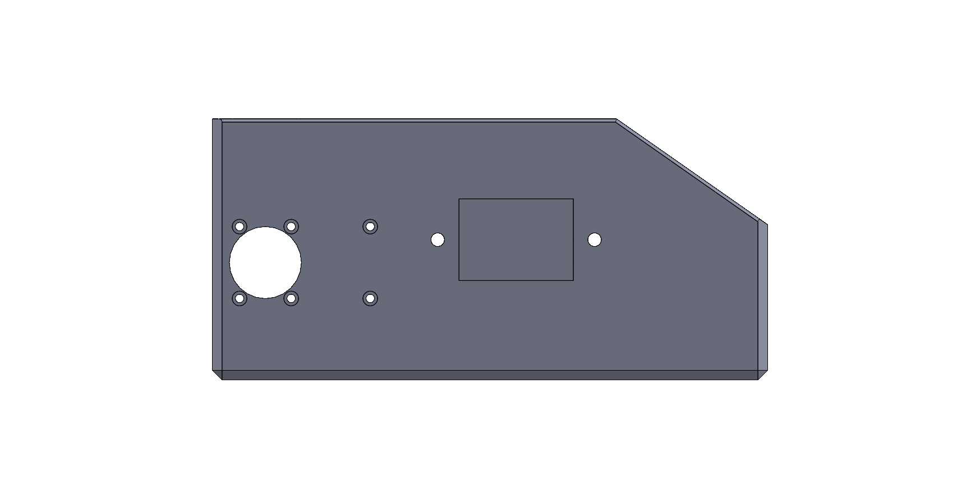
Figures/Mechanical Design/Body_Design_2.PNG
