Mo-Barakat/Master-Thesis/Figures/Mechanical Design/Body_Design_3.PNG

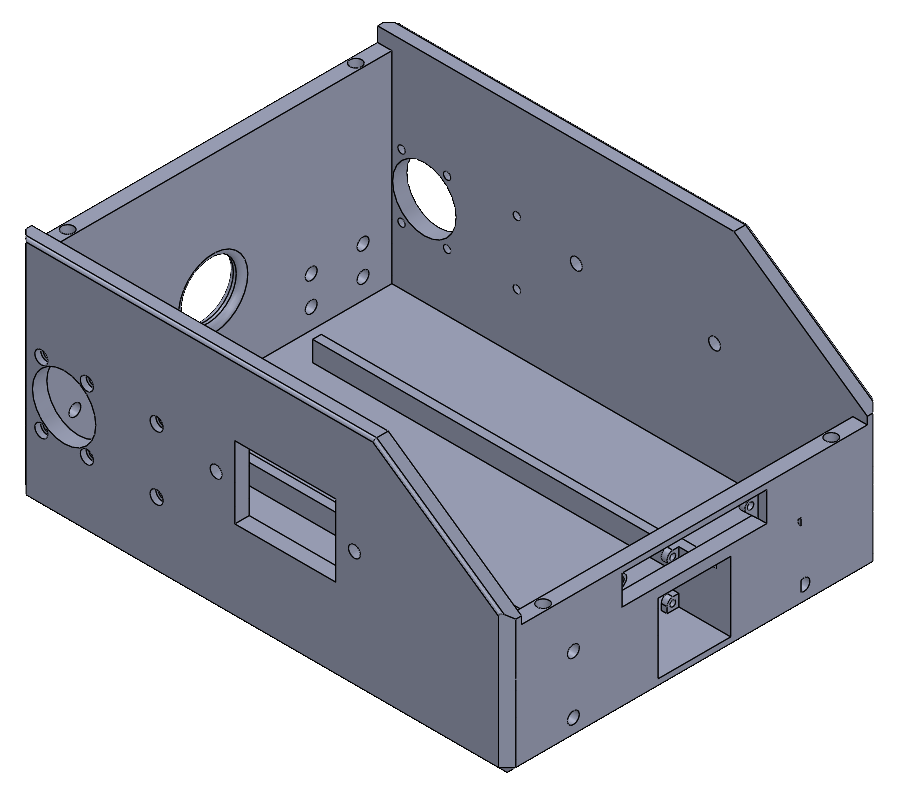
Figures/Mechanical Design/Body_Design_3.PNG
