Mo-Barakat/Master-Thesis/Figures/Mechanical Design/Body_Knee_Link_2.PNG

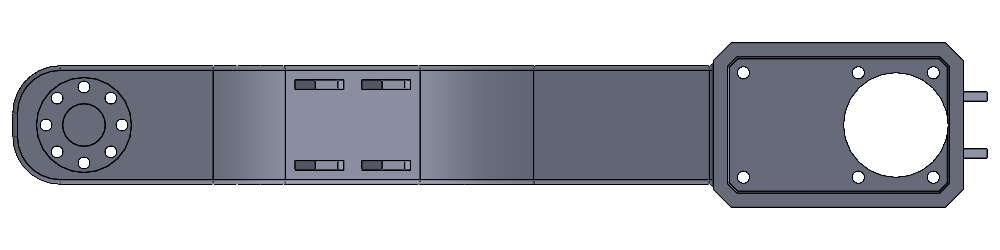
Figures/Mechanical Design/Body_Knee_Link_2.PNG
