Mo-Barakat/Master-Thesis/Figures/Mechanical Design/Body_Knee_Link_3.PNG

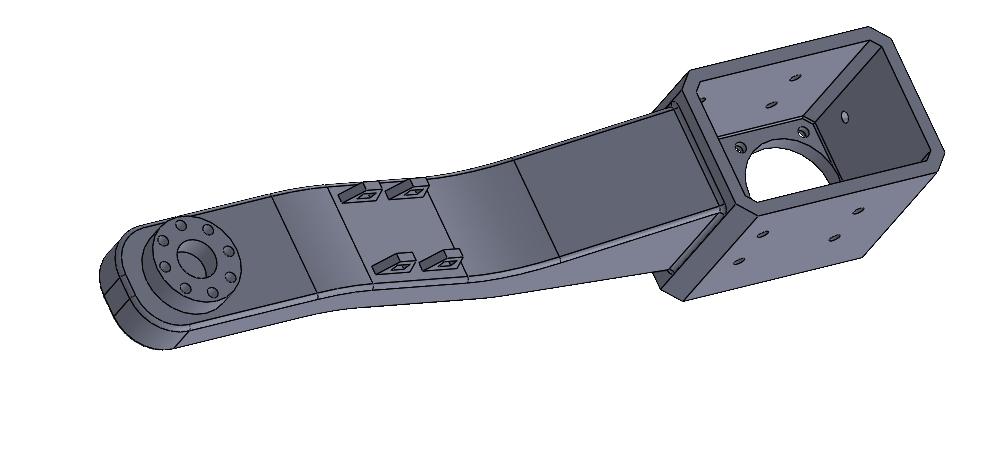
Figures/Mechanical Design/Body_Knee_Link_3.PNG
