Mo-Barakat/Master-Thesis/Figures/Mechanical Design/motor_cover_1.PNG

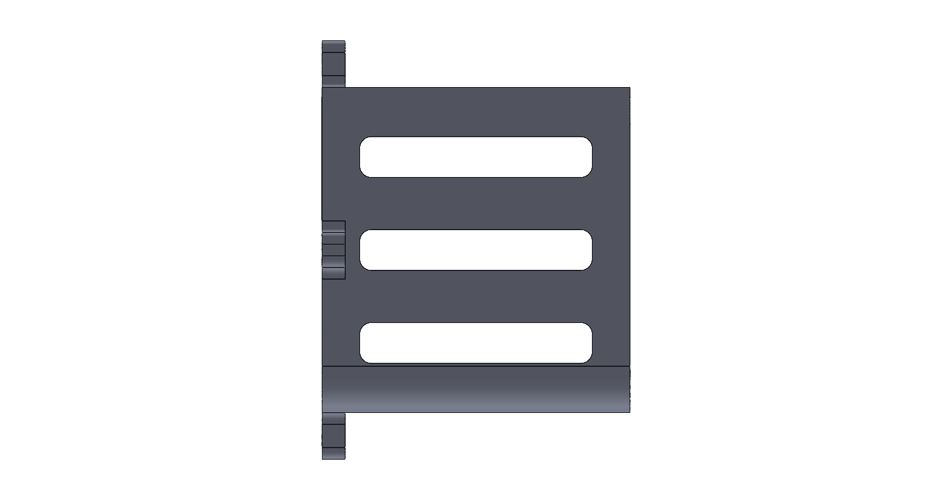
Figures/Mechanical Design/motor_cover_1.PNG
