Mo-Barakat/Master-Thesis/Figures/Mechanical Design/motor_cover_2.PNG

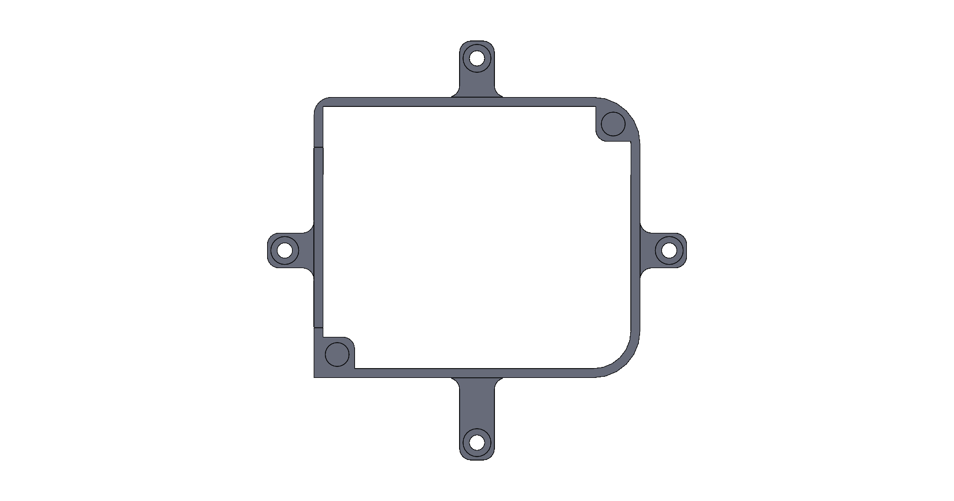
Figures/Mechanical Design/motor_cover_2.PNG
