Mo-Barakat/Master-Thesis/Figures/Mechanical Design/motor_cover_3.PNG

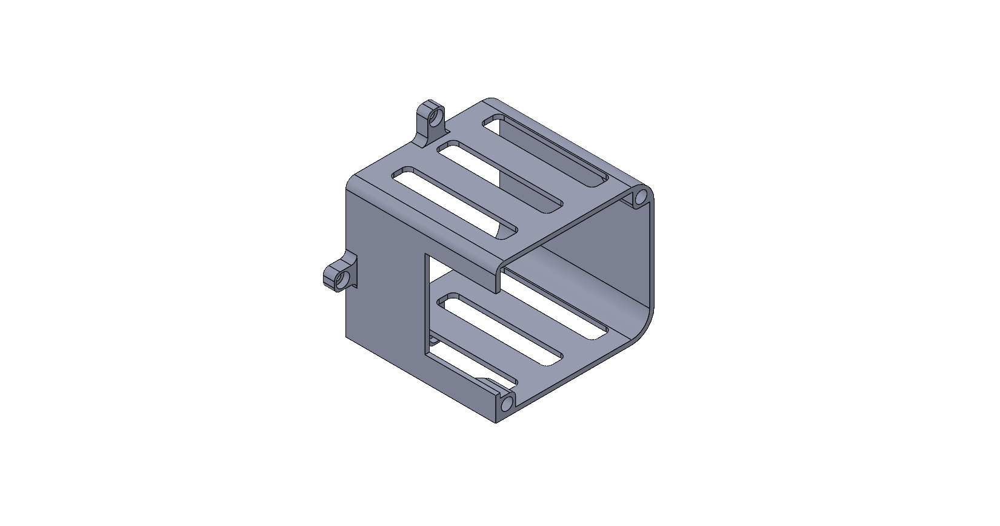
Figures/Mechanical Design/motor_cover_3.PNG
