Mo-Barakat/Master-Thesis/Figures/Mechanical Design/PCB_Rack_1.PNG

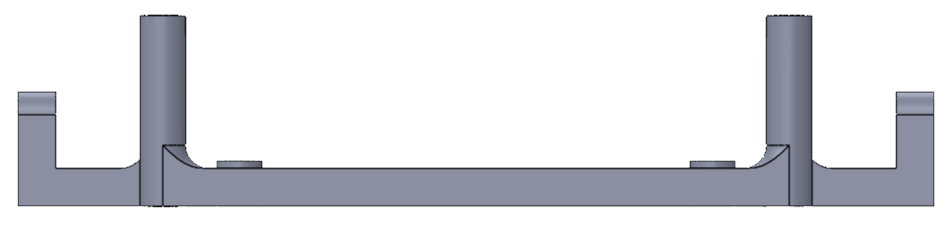
Figures/Mechanical Design/PCB_Rack_1.PNG
