Mo-Barakat/Master-Thesis/Figures/Mechanical Design/PCB_Rack_2.PNG

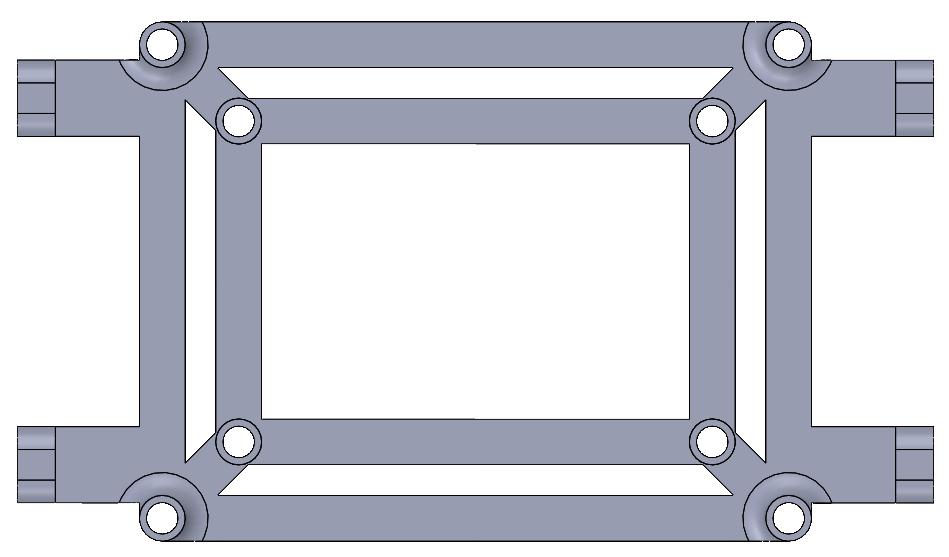
Figures/Mechanical Design/PCB_Rack_2.PNG
