Mo-Barakat/Master-Thesis/Figures/Mechanical Design/PCB_Rack_3.PNG

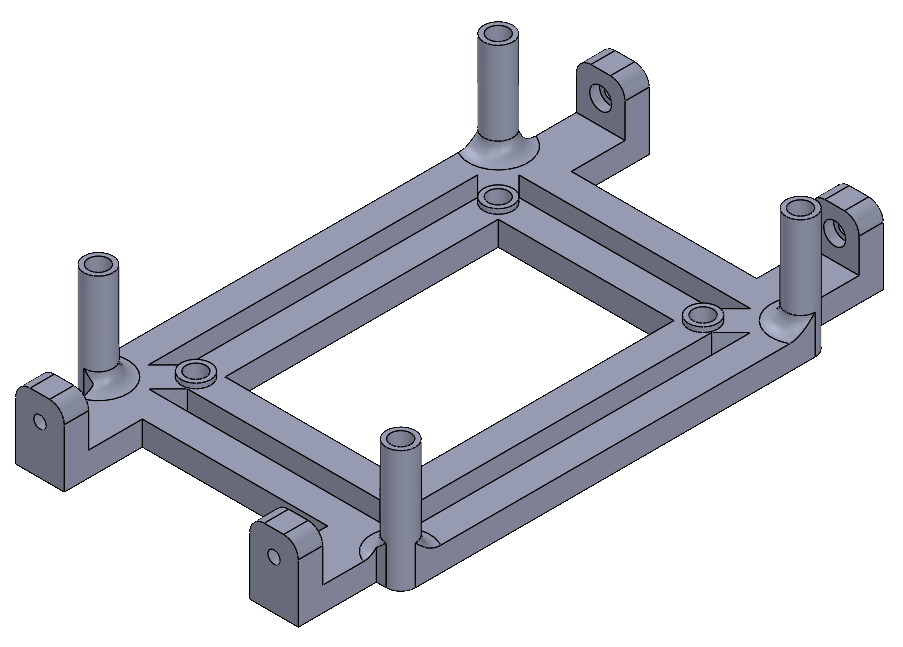
Figures/Mechanical Design/PCB_Rack_3.PNG
