Mo-Barakat/Master-Thesis/Figures/Mechanical Design/Support_flexible_1.PNG

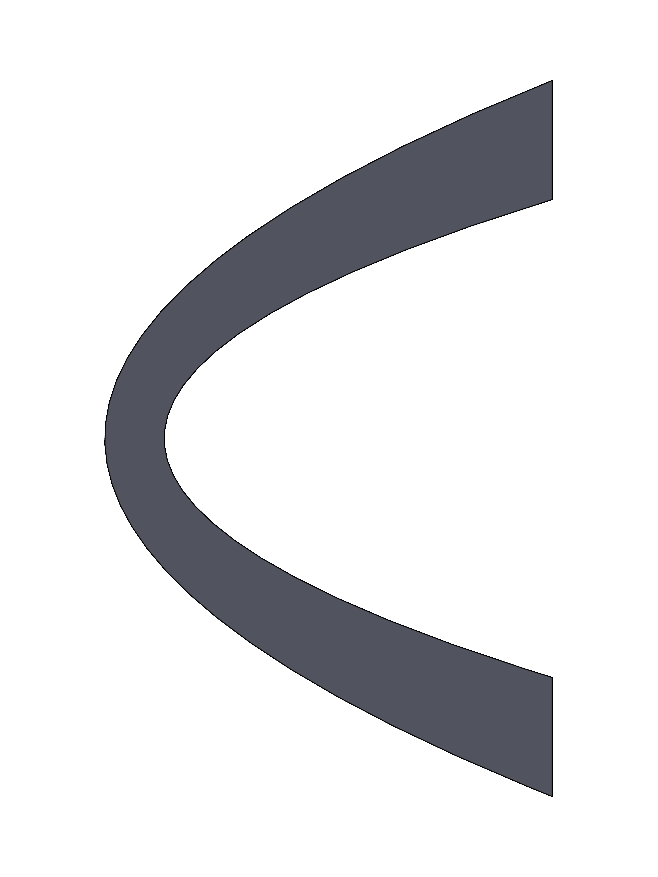
Figures/Mechanical Design/Support_flexible_1.PNG
