Mo-Barakat/Master-Thesis/Figures/Mechanical Design/Support_flexible_2.PNG

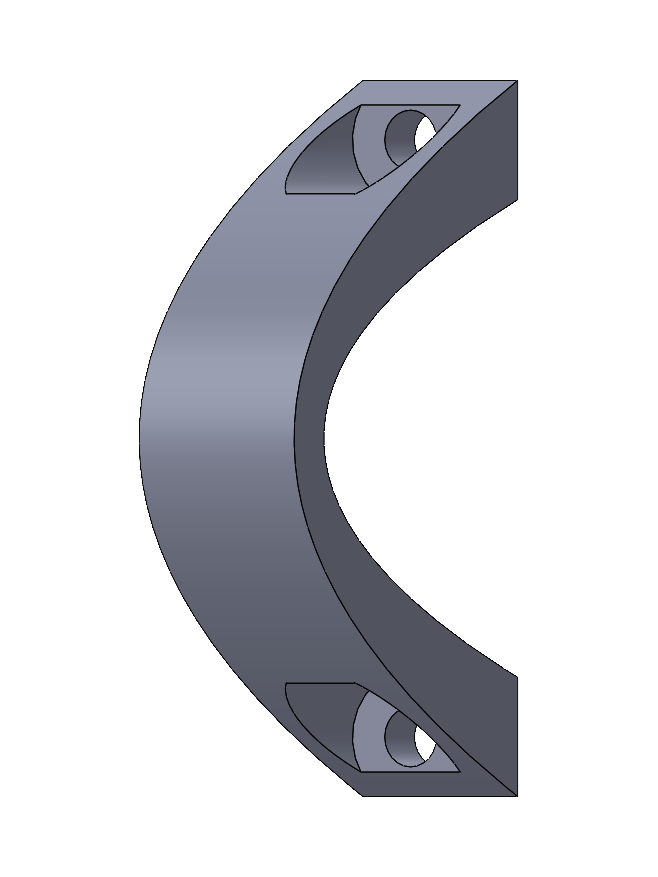
Figures/Mechanical Design/Support_flexible_2.PNG
