Mo-Barakat/Master-Thesis/Figures/Mechanical Design/Wheel_Knee_Link_1.PNG

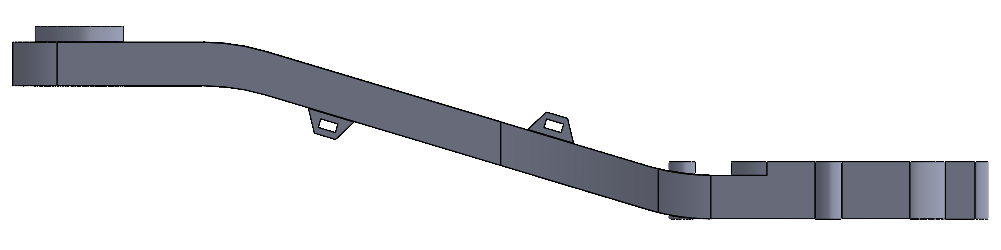
Figures/Mechanical Design/Wheel_Knee_Link_1.PNG
