Mo-Barakat/Master-Thesis/Figures/Mechanical Design/Wheel_Knee_Link_2.PNG

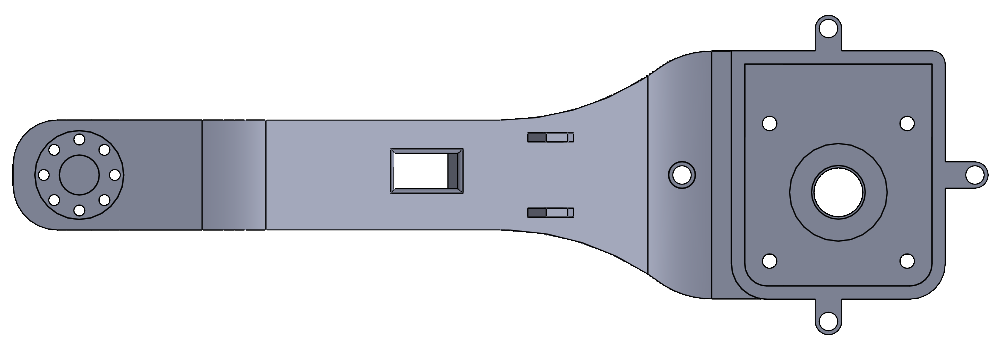
Figures/Mechanical Design/Wheel_Knee_Link_2.PNG
