Mo-Barakat/Master-Thesis/Figures/Mechanical Design/Wheel_Knee_Link_3.PNG

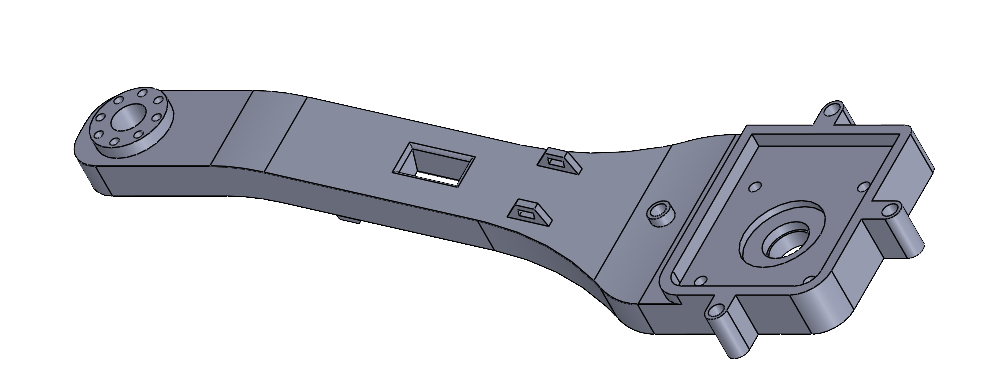
Figures/Mechanical Design/Wheel_Knee_Link_3.PNG
