Mo-Barakat/Master-Thesis/Figures/Modelling and Simulation/Block Diagram of Simulation Environment.PNG

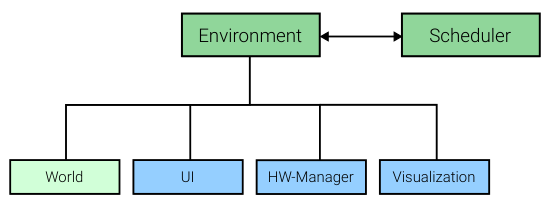
Figures/Modelling and Simulation/Block Diagram of Simulation Environment.PNG
