Mo-Barakat/Master-Thesis/Figures/Modelling and Simulation/Simulation Environment.PNG

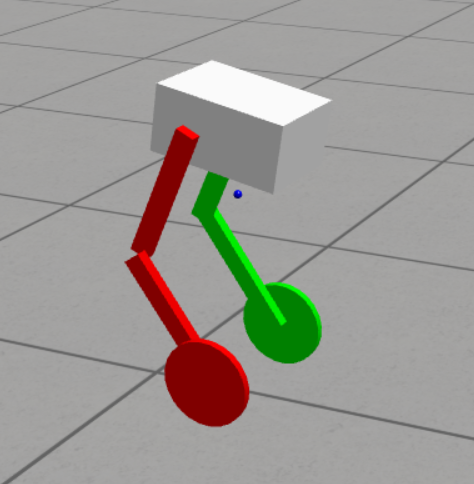
Figures/Modelling and Simulation/Simulation Environment.PNG
