Mo-Barakat/Master-Thesis/Figures/Modelling and Simulation/Simulation Environment_1.PNG

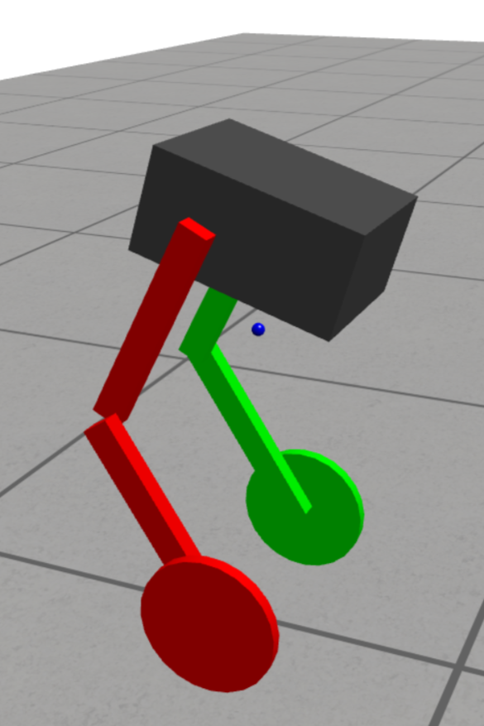
Figures/Modelling and Simulation/Simulation Environment_1.PNG
