Mo-Barakat/Master-Thesis/Figures/Modelling and Simulation/Simulation Environment_2.PNG

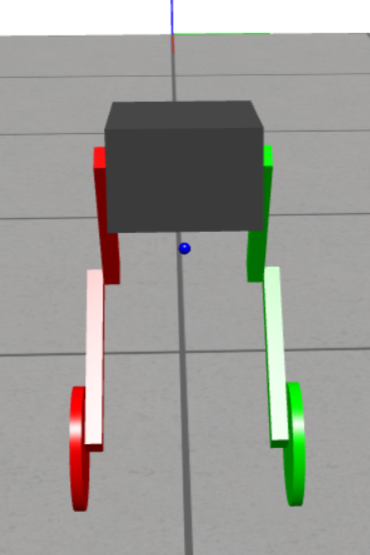
Figures/Modelling and Simulation/Simulation Environment_2.PNG
