Mo-Barakat/Master-Thesis/Figures/Modelling and Simulation/Simulation Environment_3.PNG

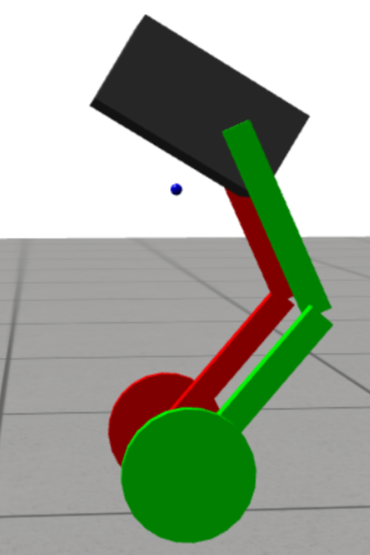
Figures/Modelling and Simulation/Simulation Environment_3.PNG
