Mo-Barakat/Master-Thesis/Figures/Mechanical Design/Body_Design_1.SLDPRT

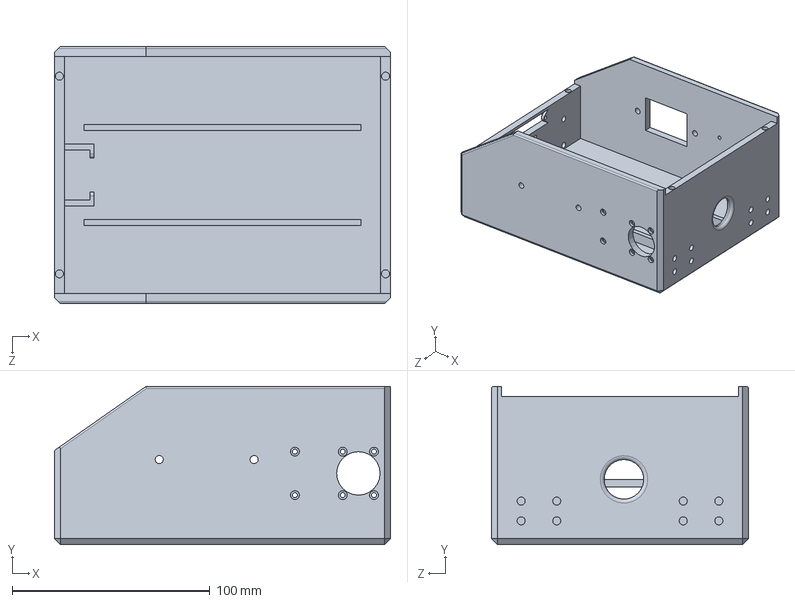
[picture p54: CAD file, 2023-12-16, last stored version]
Figures/Mechanical Design/Body_Design_1.SLDPRT
170.0 x 80.0 x 130.0 mm
