Mo-Barakat/Master-Thesis/Figures/Modelling and Simulation/Step Response of the Internal Input hip angle.pdf

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

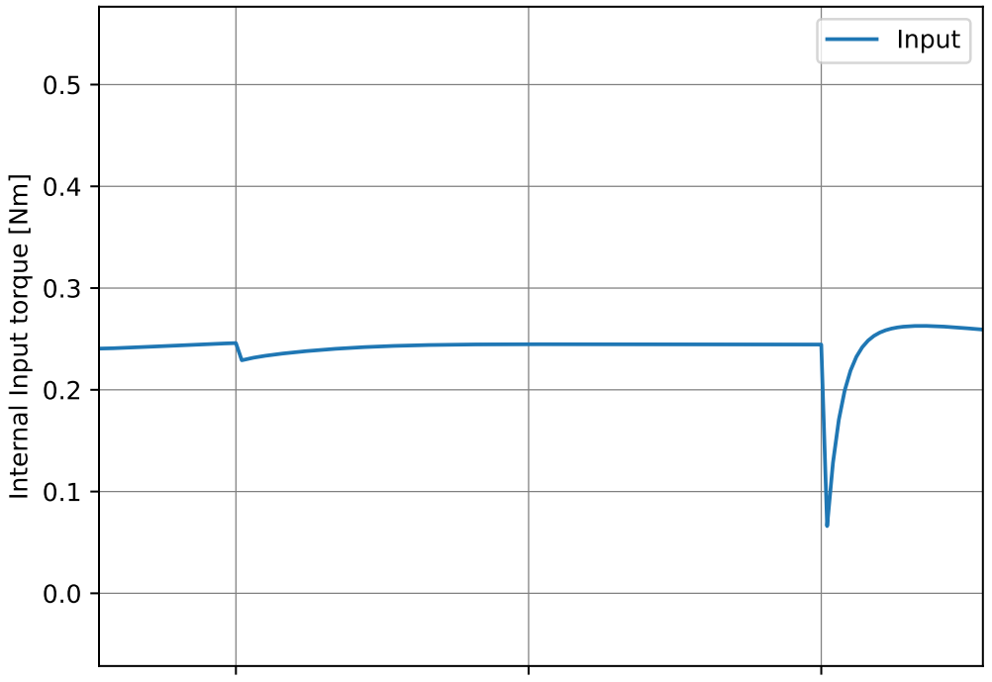
[picture p55: figure]
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
