Mo-Barakat/Master-Thesis/Figures/Modelling and Simulation/Step Response of the Internal Input.pdf

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

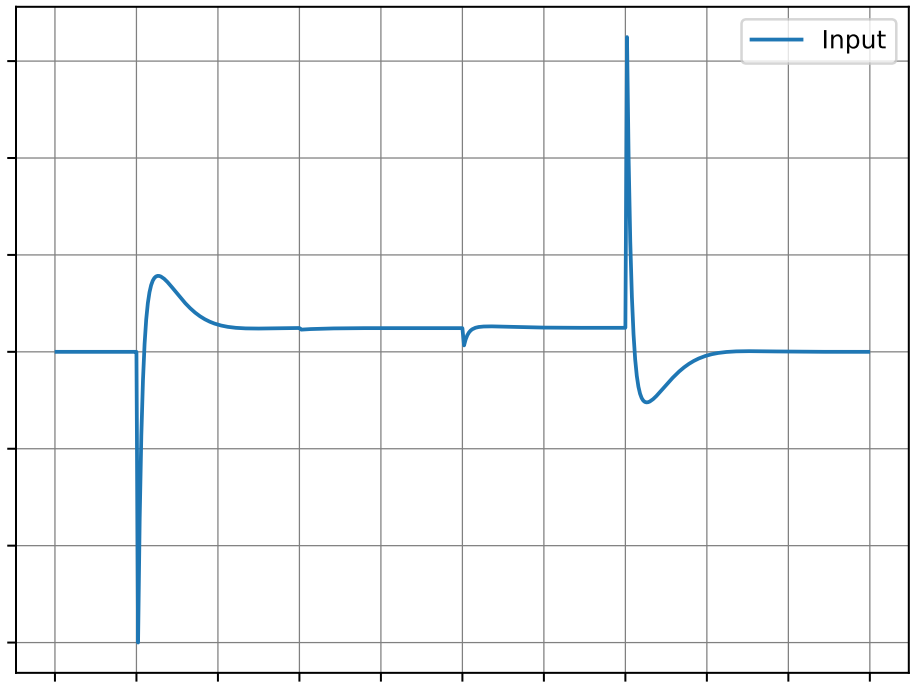
[picture p56: figure]
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
