Mo-Barakat/Master-Thesis/Figures/Mechanical Assembly/20231226_111330.jpg

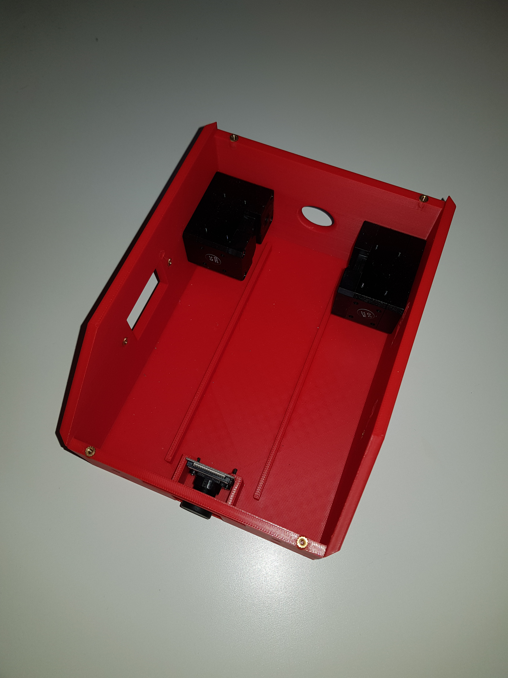
Figures/Mechanical Assembly/20231226_111330.jpg
