Mo-Barakat/Master-Thesis/Figures/Mechanical Assembly/20231226_111558.jpg

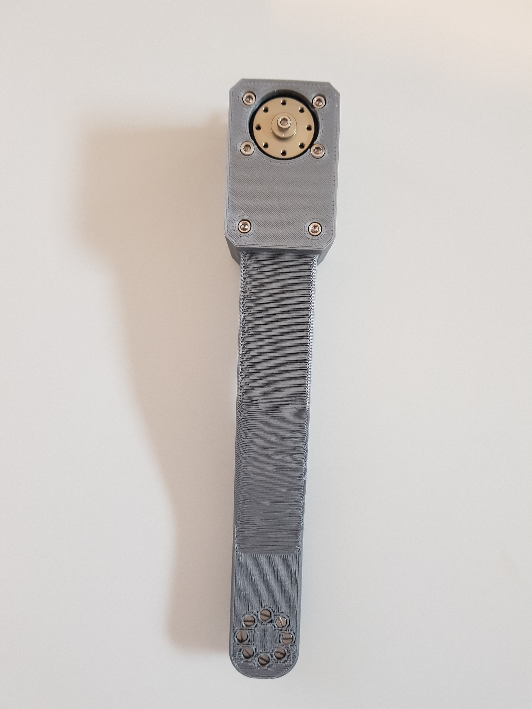
Figures/Mechanical Assembly/20231226_111558.jpg
