Mo-Barakat/Master-Thesis/Figures/Mechanical Assembly/20231226_111929.jpg

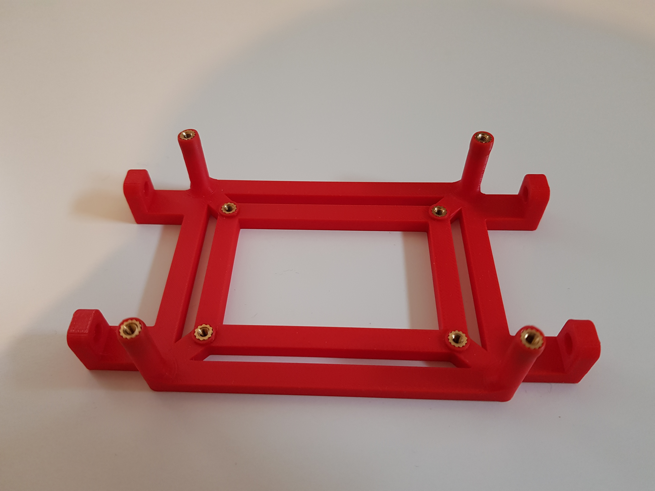
Figures/Mechanical Assembly/20231226_111929.jpg
