Mo-Barakat/Master-Thesis/Figures/Mechanical Assembly/20231226_112115.jpg

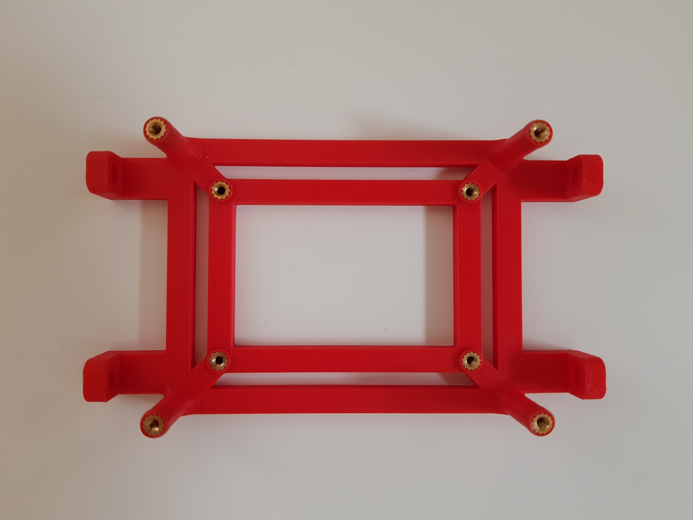
Figures/Mechanical Assembly/20231226_112115.jpg
