Mo-Barakat/Master-Thesis/Figures/Mechanical Assembly/20231226_112407.jpg

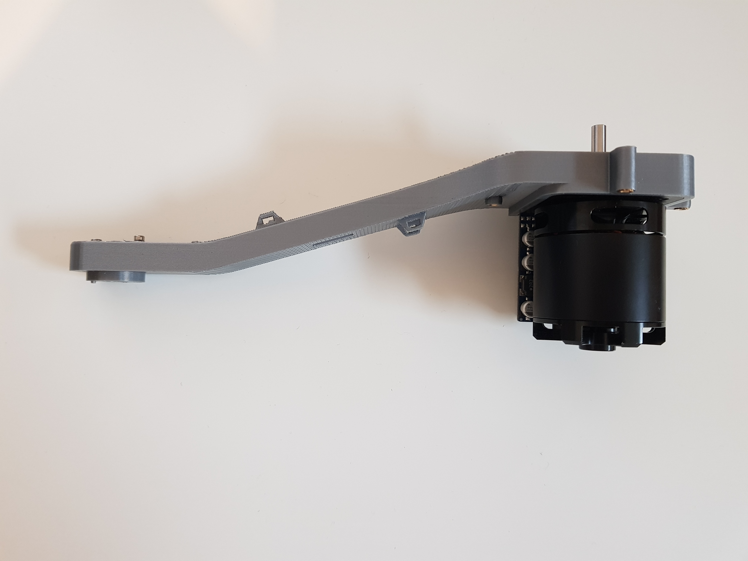
Figures/Mechanical Assembly/20231226_112407.jpg
