Mo-Barakat/Master-Thesis/Figures/Mechanical Assembly/20231226_112947.jpg

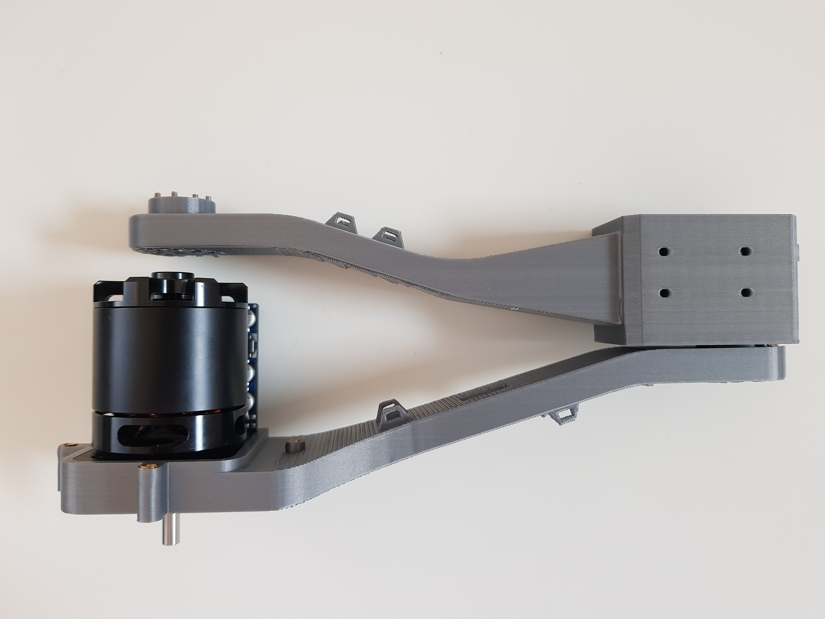
Figures/Mechanical Assembly/20231226_112947.jpg
