Mo-Barakat/Master-Thesis/Figures/Mechanical Assembly/20231226_112959.jpg

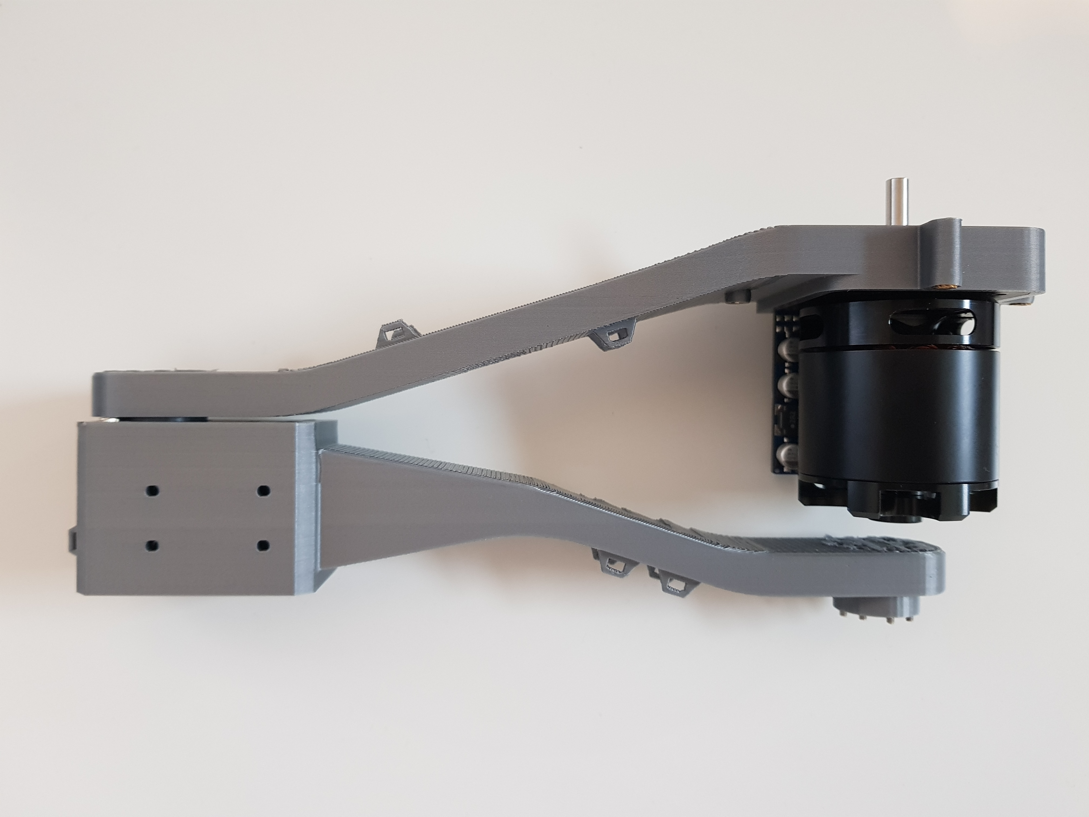
Figures/Mechanical Assembly/20231226_112959.jpg
