Mo-Barakat/Master-Thesis/Figures/Mechanical Assembly/20231226_115543.jpg

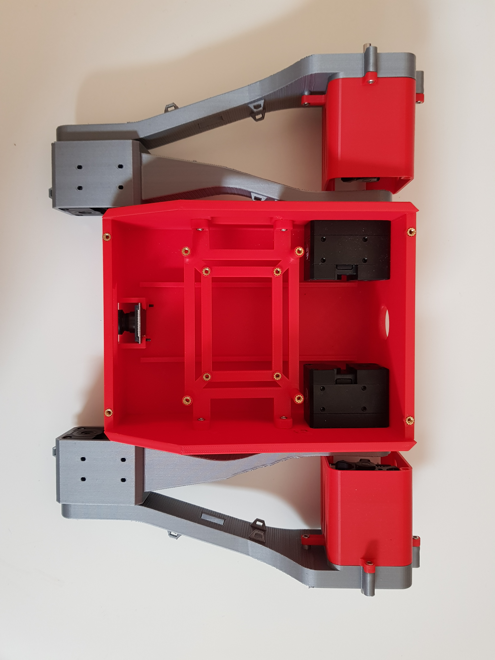
Figures/Mechanical Assembly/20231226_115543.jpg
