Mo-Barakat/Master-Thesis/Figures/Mechanical Assembly/20231226_115600.jpg

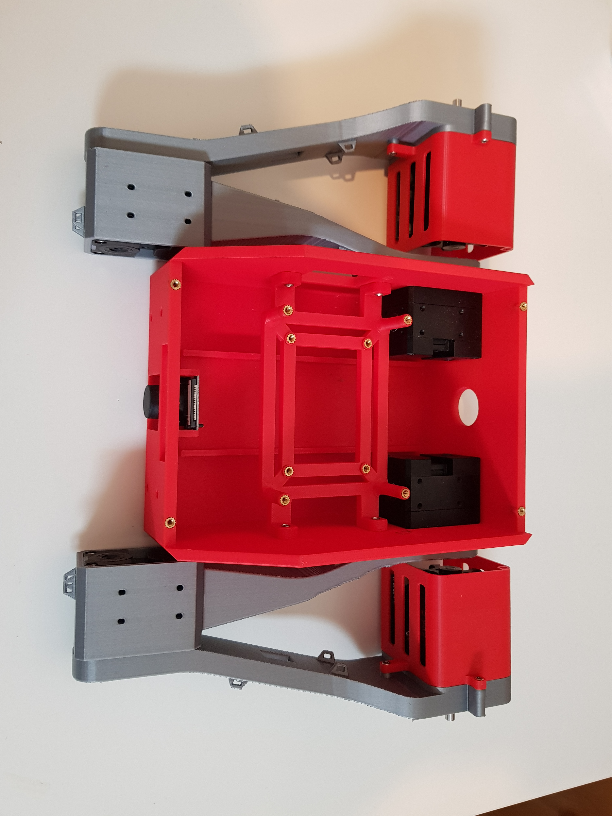
Figures/Mechanical Assembly/20231226_115600.jpg
