Mo-Barakat/Master-Thesis/Figures/Mechanical Assembly/20231226_120723.jpg

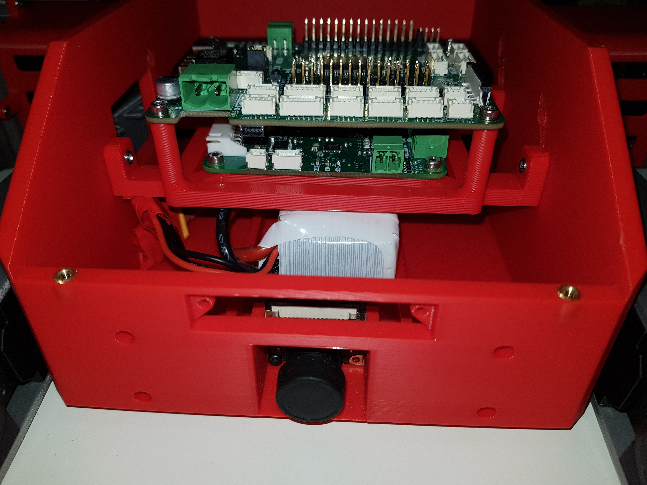
Figures/Mechanical Assembly/20231226_120723.jpg
