Mo-Barakat/Master-Thesis/Figures/Mechanical Assembly/20231226_120747.jpg

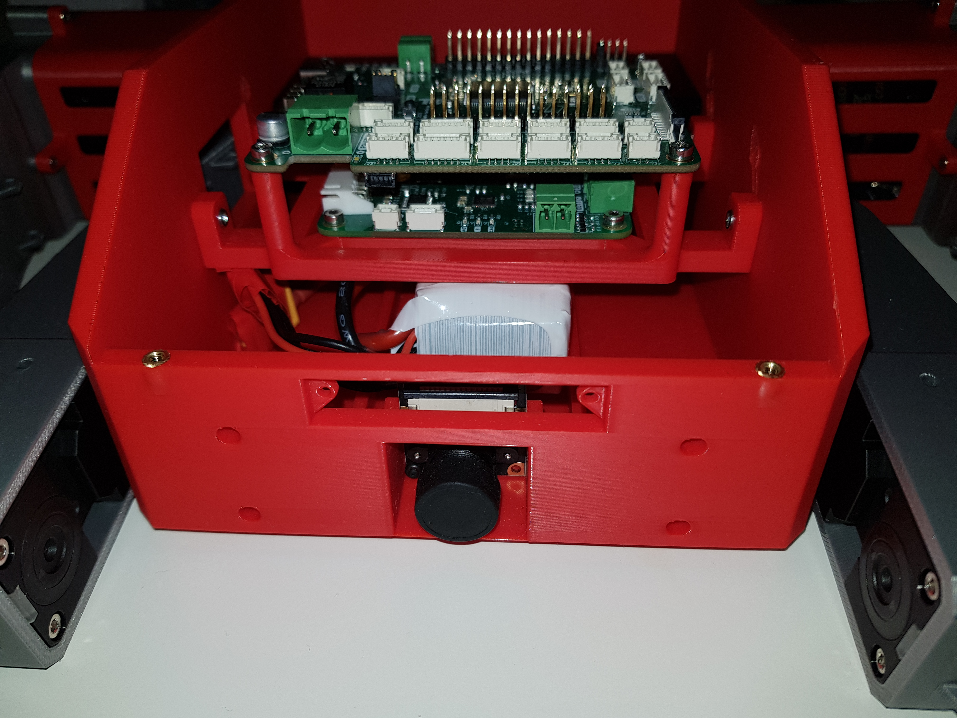
Figures/Mechanical Assembly/20231226_120747.jpg
