Mo-Barakat/Master-Thesis/Figures/Mechanical Assembly/20231226_120835.jpg

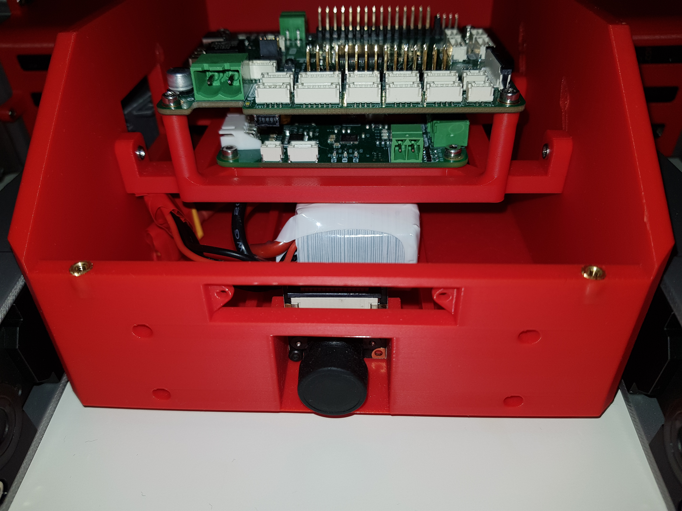
Figures/Mechanical Assembly/20231226_120835.jpg
