Mo-Barakat/Master-Thesis/Figures/Mechanical Assembly/20231226_121318.jpg

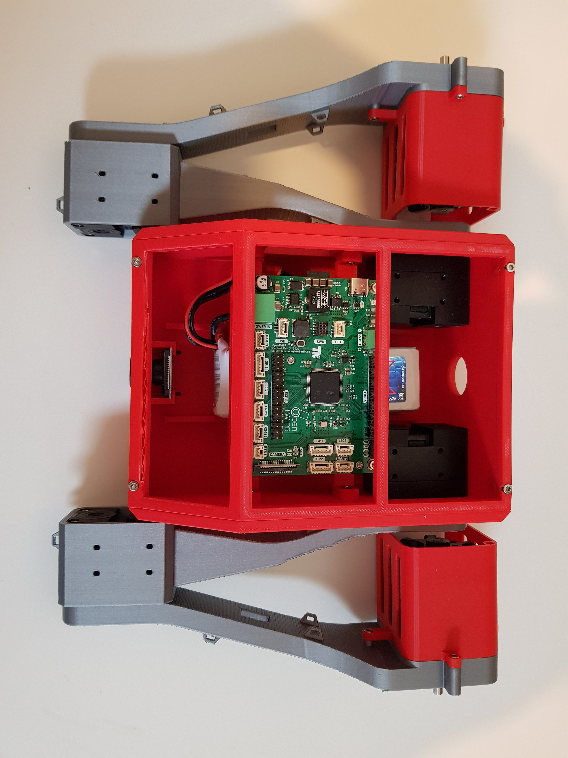
Figures/Mechanical Assembly/20231226_121318.jpg
