Mo-Barakat/Master-Thesis/Figures/Mechanical Assembly/assembling_body_hip_knee_links.jpg

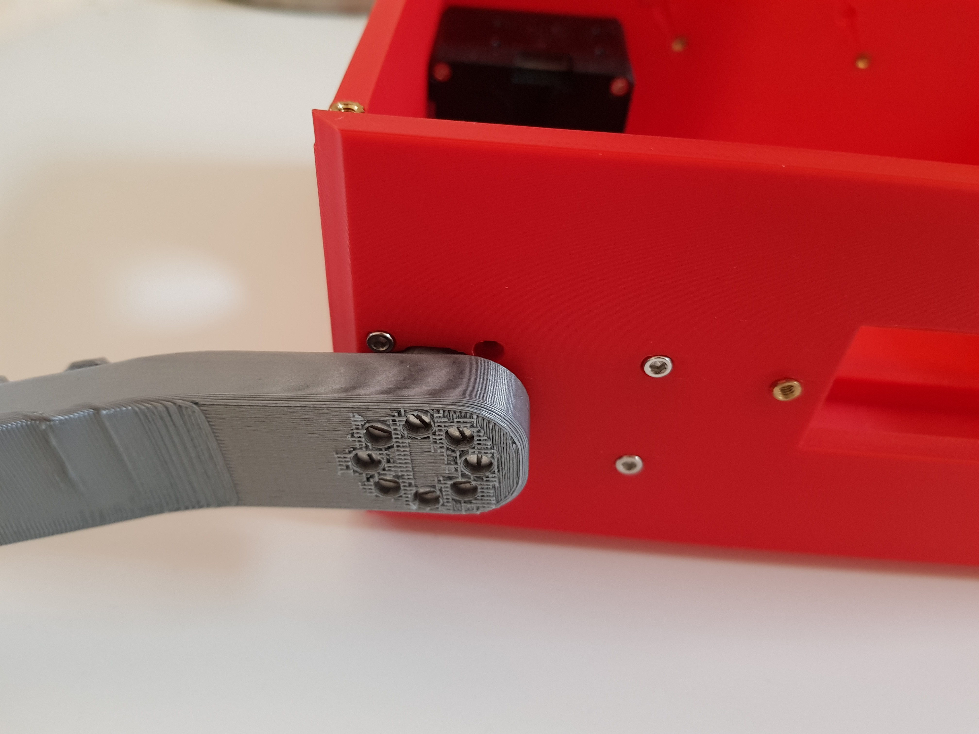
Figures/Mechanical Assembly/assembling_body_hip_knee_links.jpg
