Mo-Barakat/Master-Thesis/Figures/Mechanical Assembly/assembling_knee_wheel_links_and_hip_knee_links_1.jpg

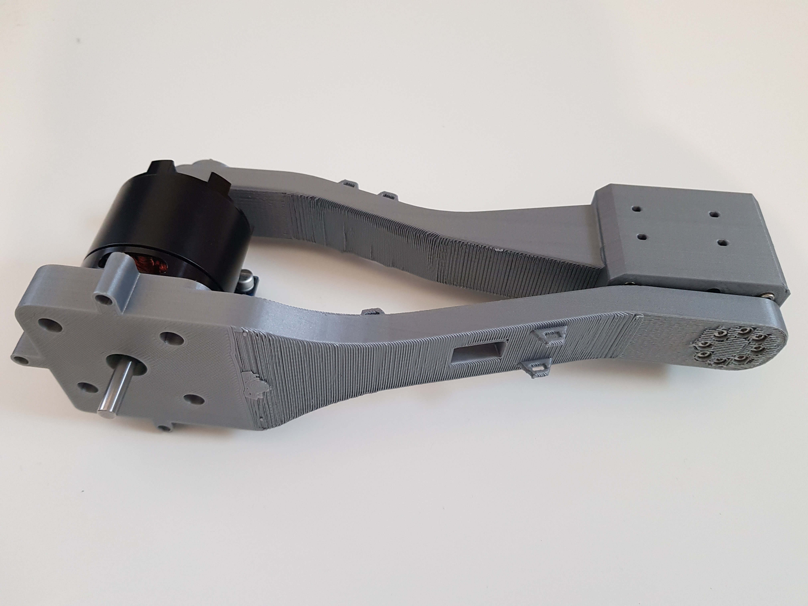
Figures/Mechanical Assembly/assembling_knee_wheel_links_and_hip_knee_links_1.jpg
