Mo-Barakat/Master-Thesis/Figures/Mechanical Assembly/board_mounting_rack_thread_inserts.jpg

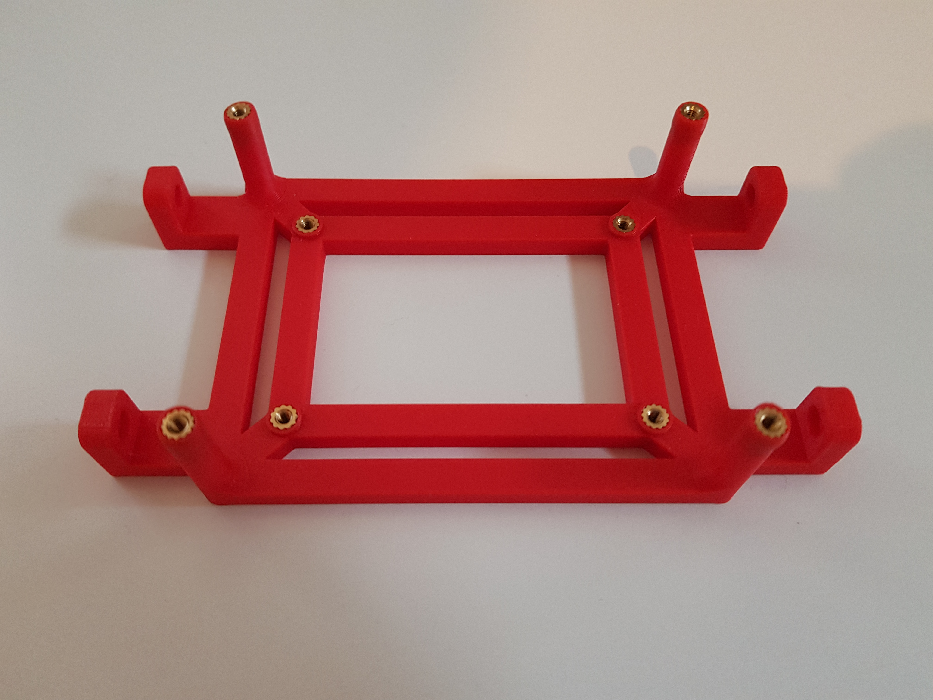
Figures/Mechanical Assembly/board_mounting_rack_thread_inserts.jpg
