Mo-Barakat/Master-Thesis/Figures/Mechanical Assembly/body_thread_inserts.jpg

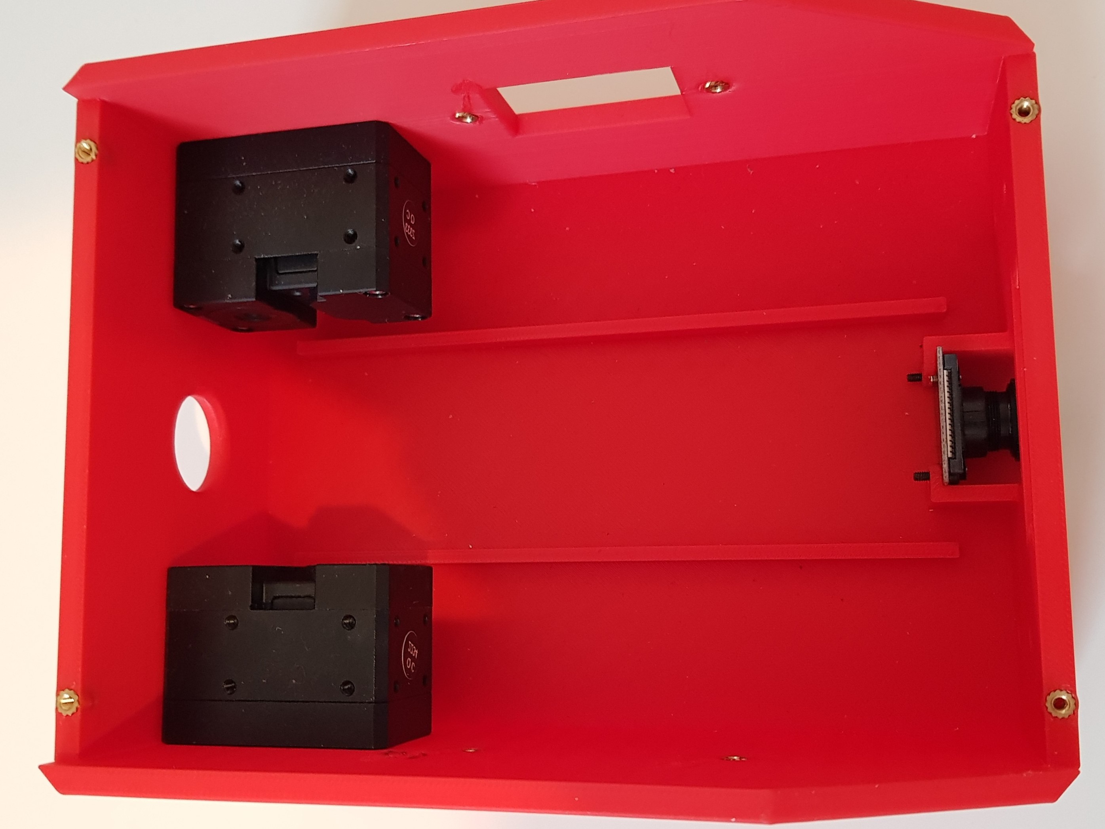
Figures/Mechanical Assembly/body_thread_inserts.jpg
