Mo-Barakat/Master-Thesis/Figures/Mechanical Assembly/fully_assembled_chassis.jpg

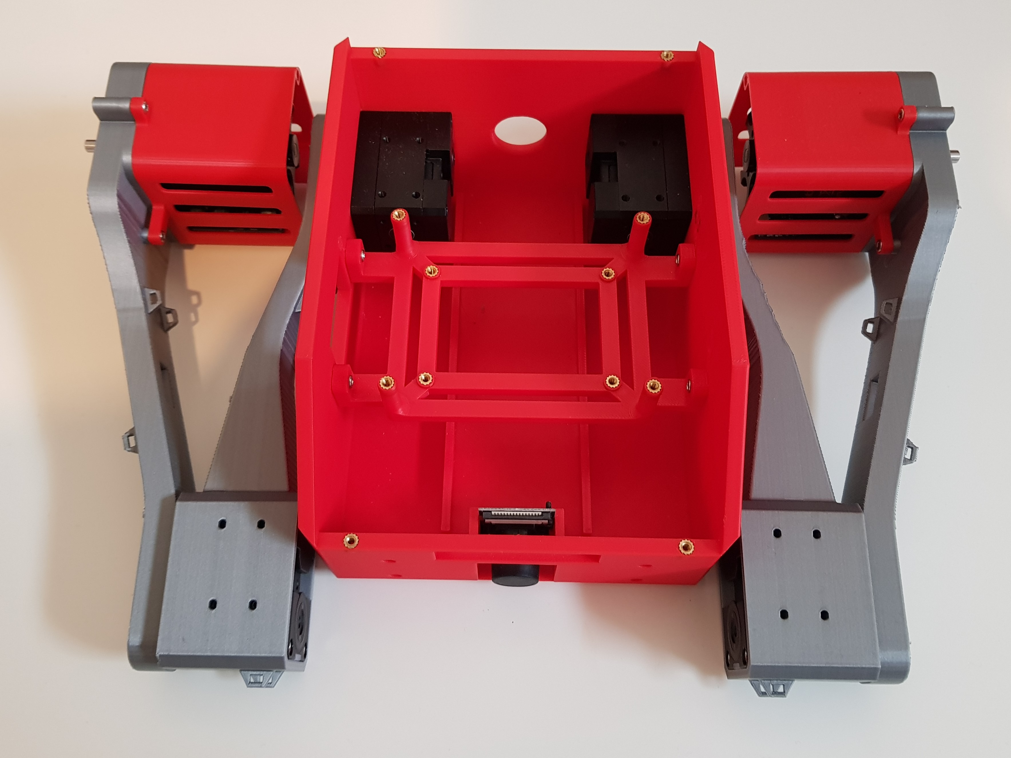
Figures/Mechanical Assembly/fully_assembled_chassis.jpg
