Mo-Barakat/Master-Thesis/Figures/Mechanical Assembly/knee_wheel_link_thread_inserts.jpg

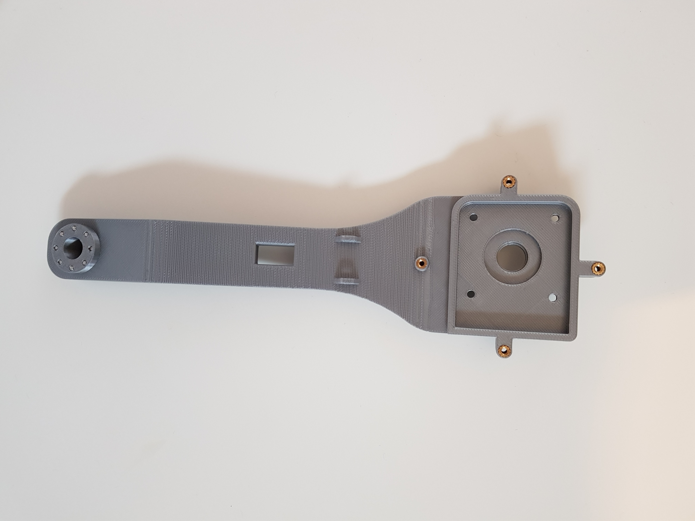
Figures/Mechanical Assembly/knee_wheel_link_thread_inserts.jpg
