Mo-Barakat/Master-Thesis/Figures/Mechanical Assembly/mounting_motors_on_hip_knee_links_2.jpg

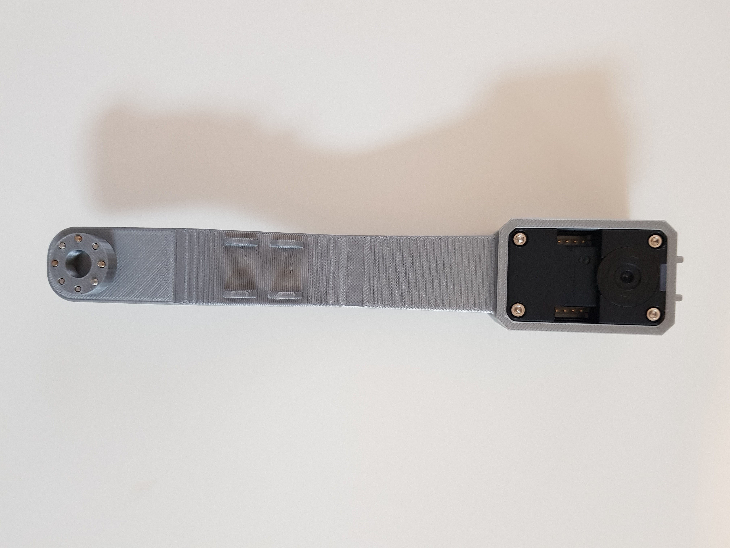
Figures/Mechanical Assembly/mounting_motors_on_hip_knee_links_2.jpg
