Mo-Barakat/Master-Thesis/Figures/Mechanical Assembly/mounting_motors_on_knee_wheel_links_1.jpg

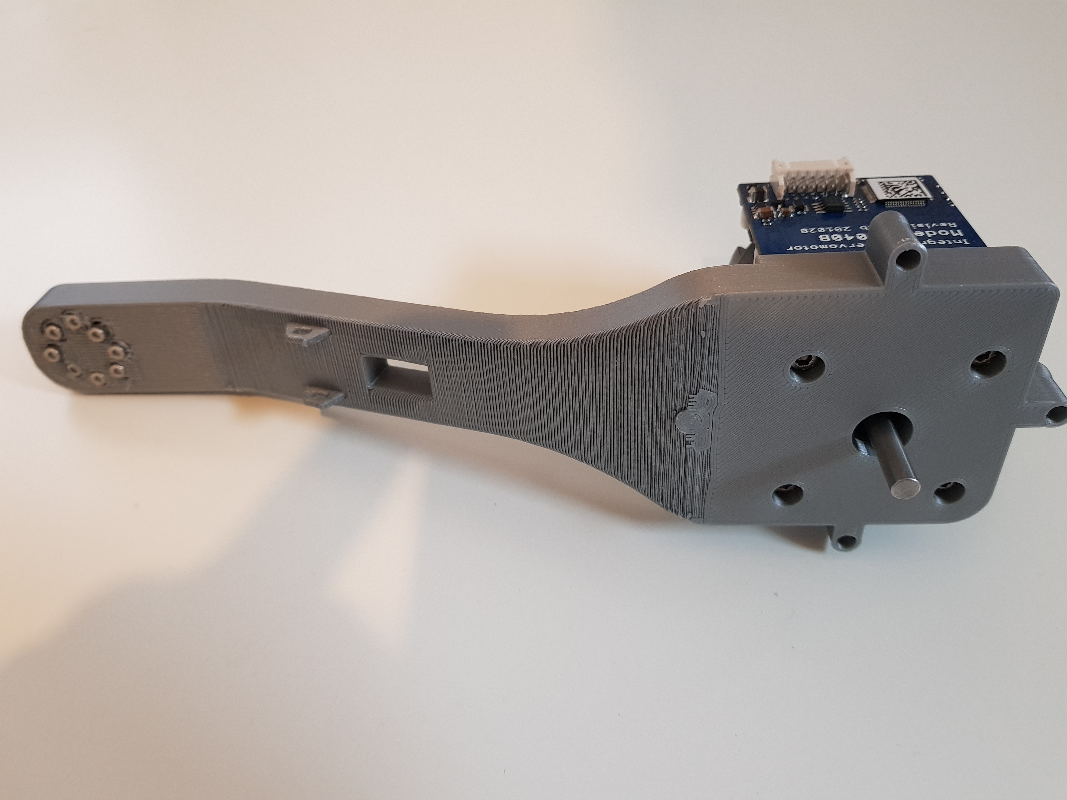
Figures/Mechanical Assembly/mounting_motors_on_knee_wheel_links_1.jpg
