Mo-Barakat/Master-Thesis/Figures/Mechanical Assembly/screw_head_fitting.PNG

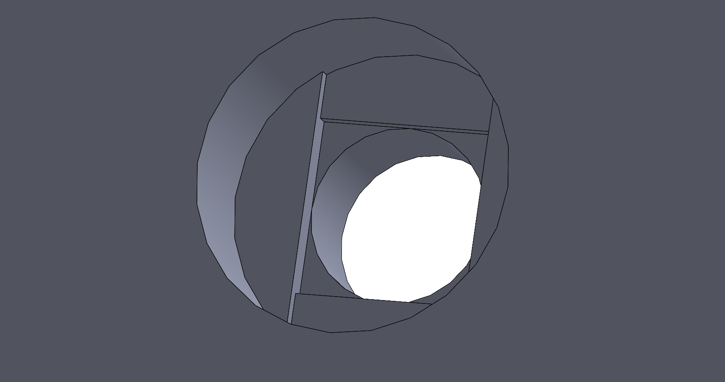
Figures/Mechanical Assembly/screw_head_fitting.PNG
