Mo-Barakat/Master-Thesis/Figures/Mechanical Design/Robot_Assembly_1.PNG

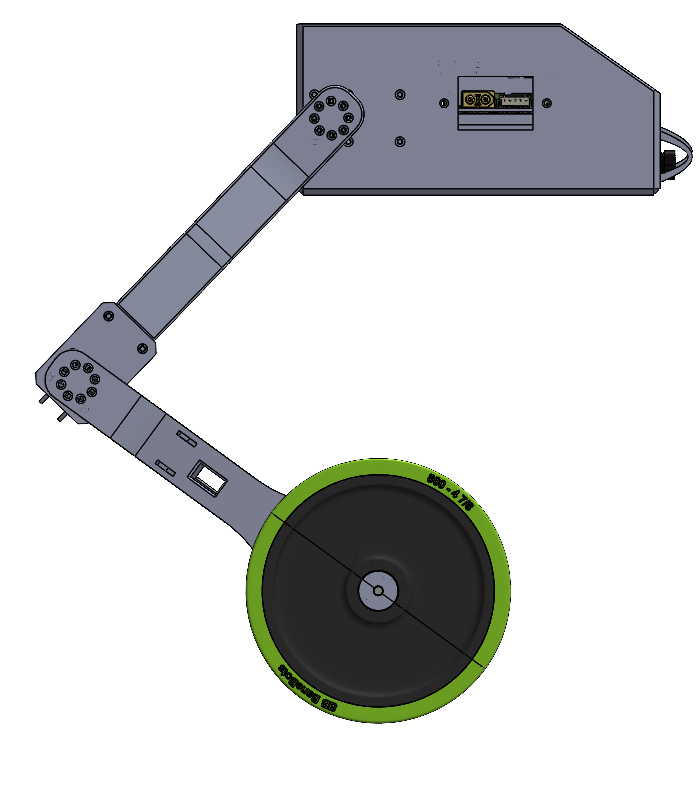
Figures/Mechanical Design/Robot_Assembly_1.PNG
