Mo-Barakat/Master-Thesis/Figures/Mechanical Design/Robot_Assembly_2.PNG

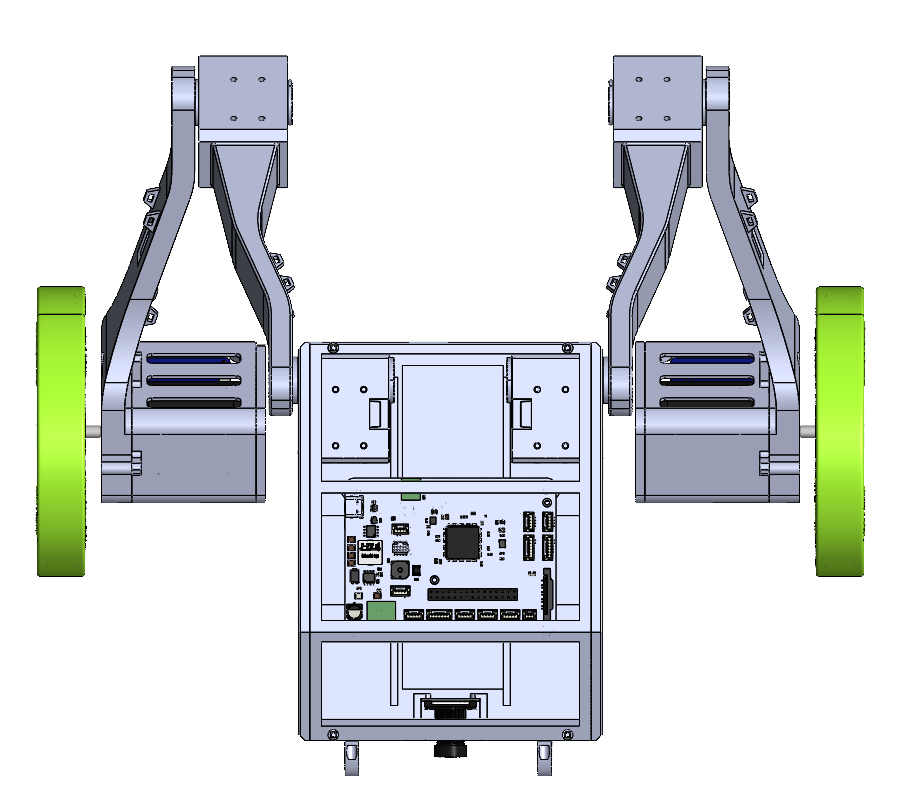
Figures/Mechanical Design/Robot_Assembly_2.PNG
