Mo-Barakat/Master-Thesis/Figures/title/Robot_Assembly_3.PNG

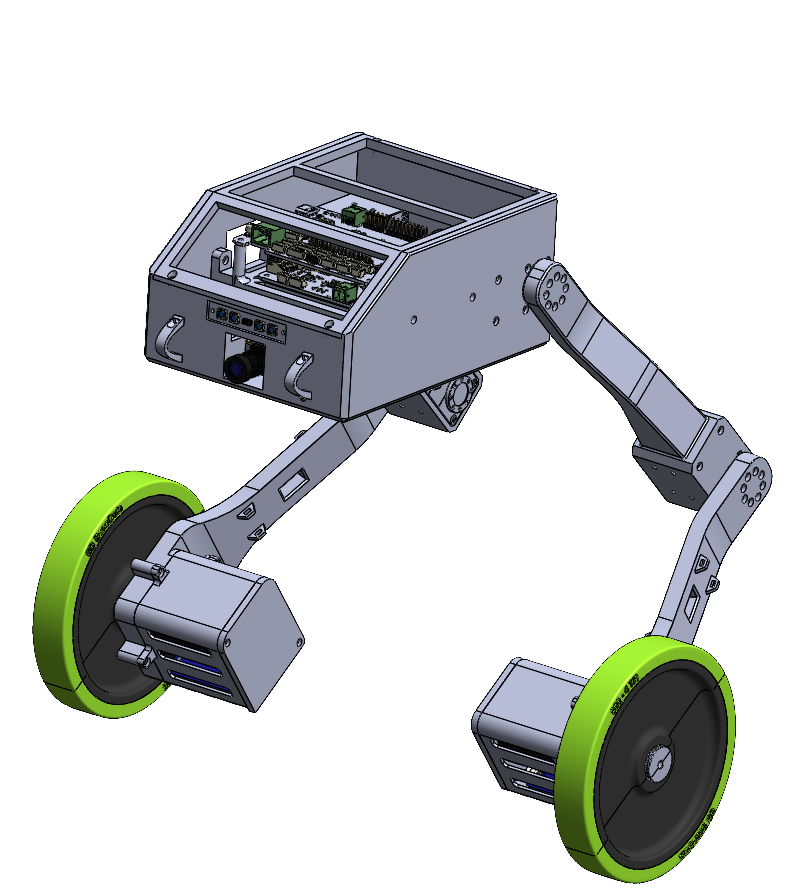
Figures/title/Robot_Assembly_3.PNG
