Mo-Barakat/Master-Thesis/Figures/Firmware and Testing/Clock Configuration.PNG

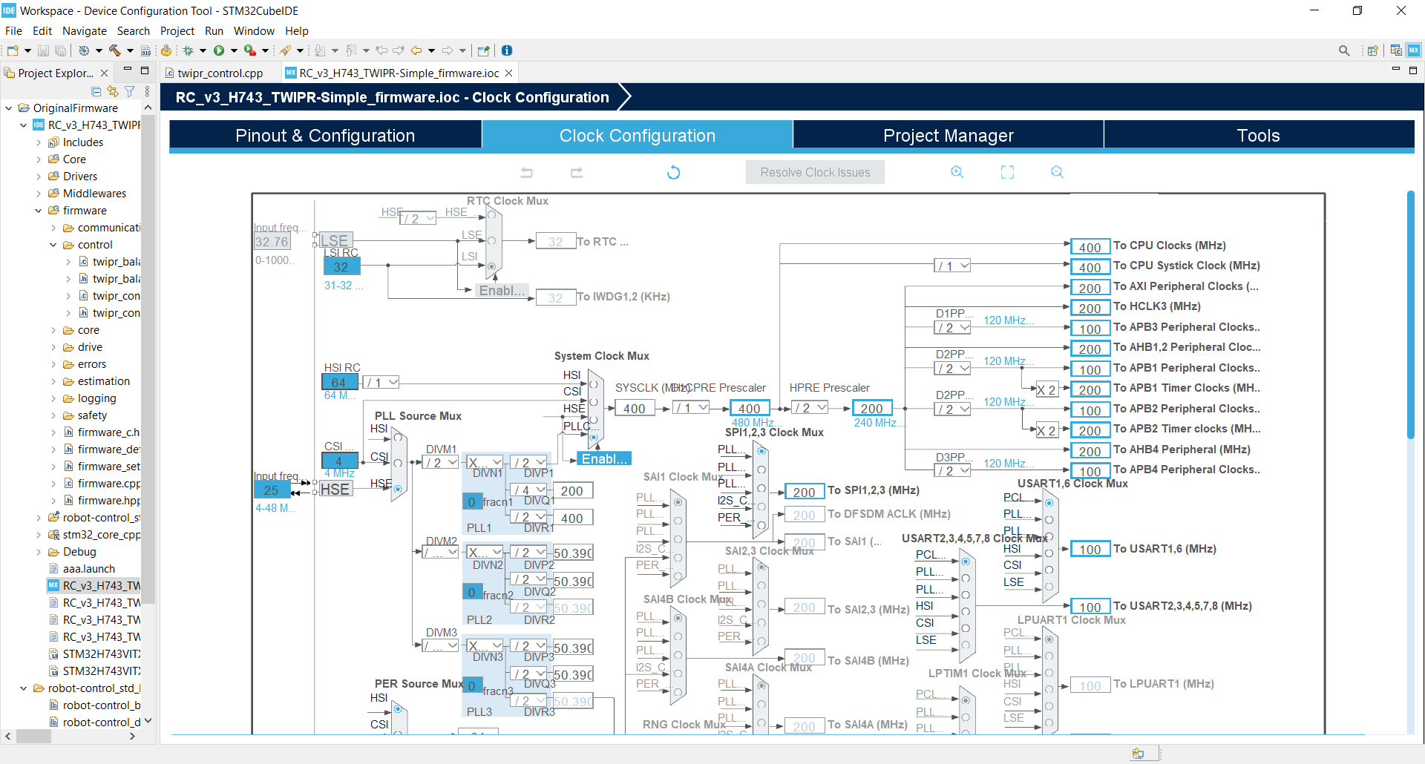
Figures/Firmware and Testing/Clock Configuration.PNG
