Mo-Barakat/Master-Thesis/Figures/Firmware and Testing/jlink.png

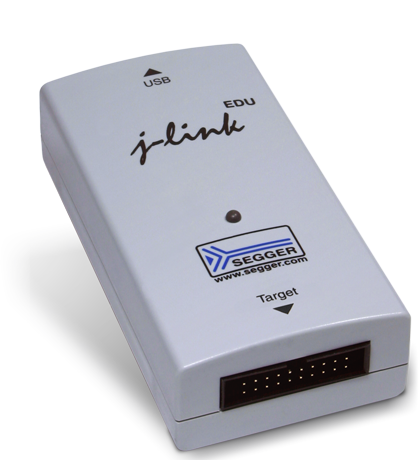
Figures/Firmware and Testing/jlink.png
