Mo-Barakat/Master-Thesis/Figures/Modelling and Simulation/Block Diagram of State Feedback Controller.pdf

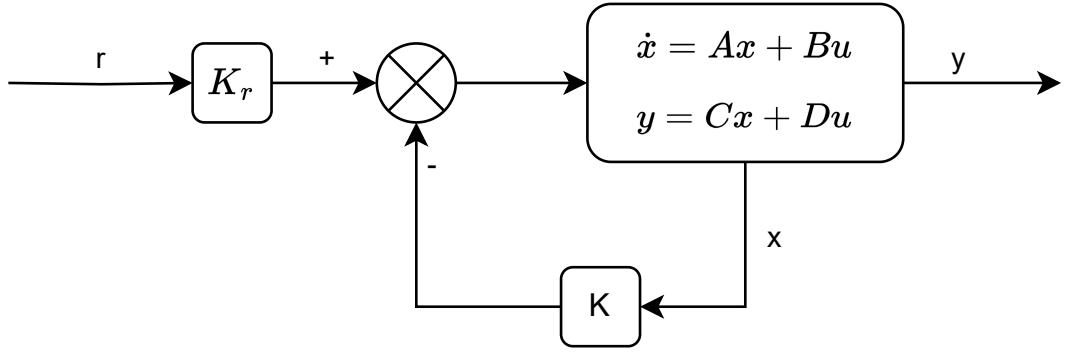
[picture p117: page 1]
