Mo-Barakat/Master-Thesis/Figures/Modelling and Simulation/Angles.pdf

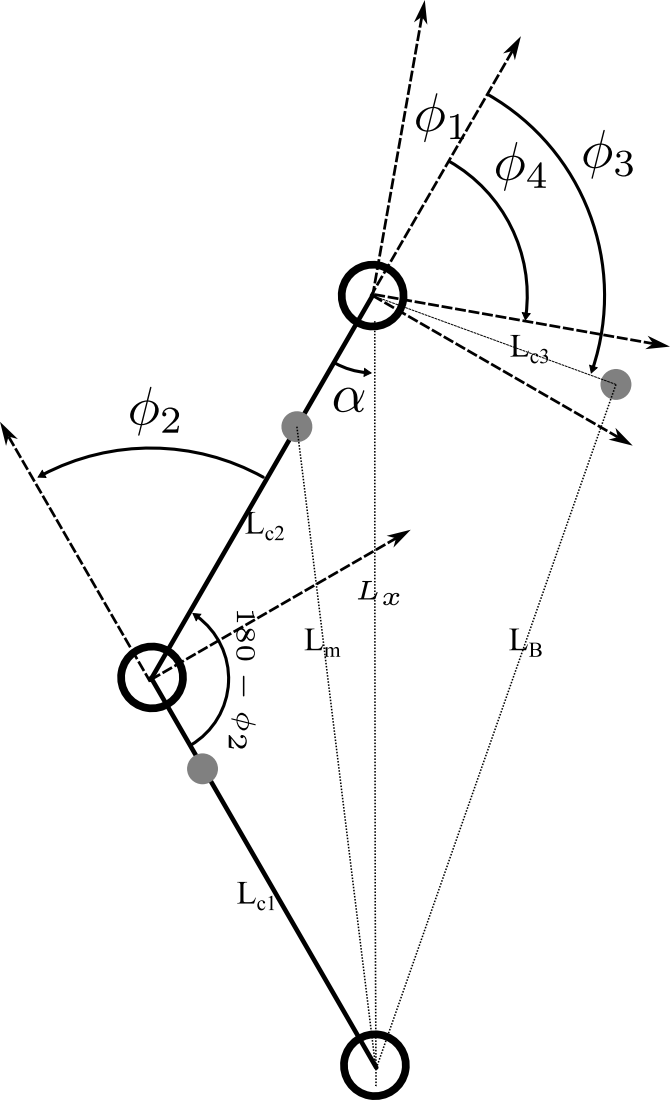
[picture p118: page 1]
