Mo-Barakat/Master-Thesis/Figures/title/hu-logo.pdf

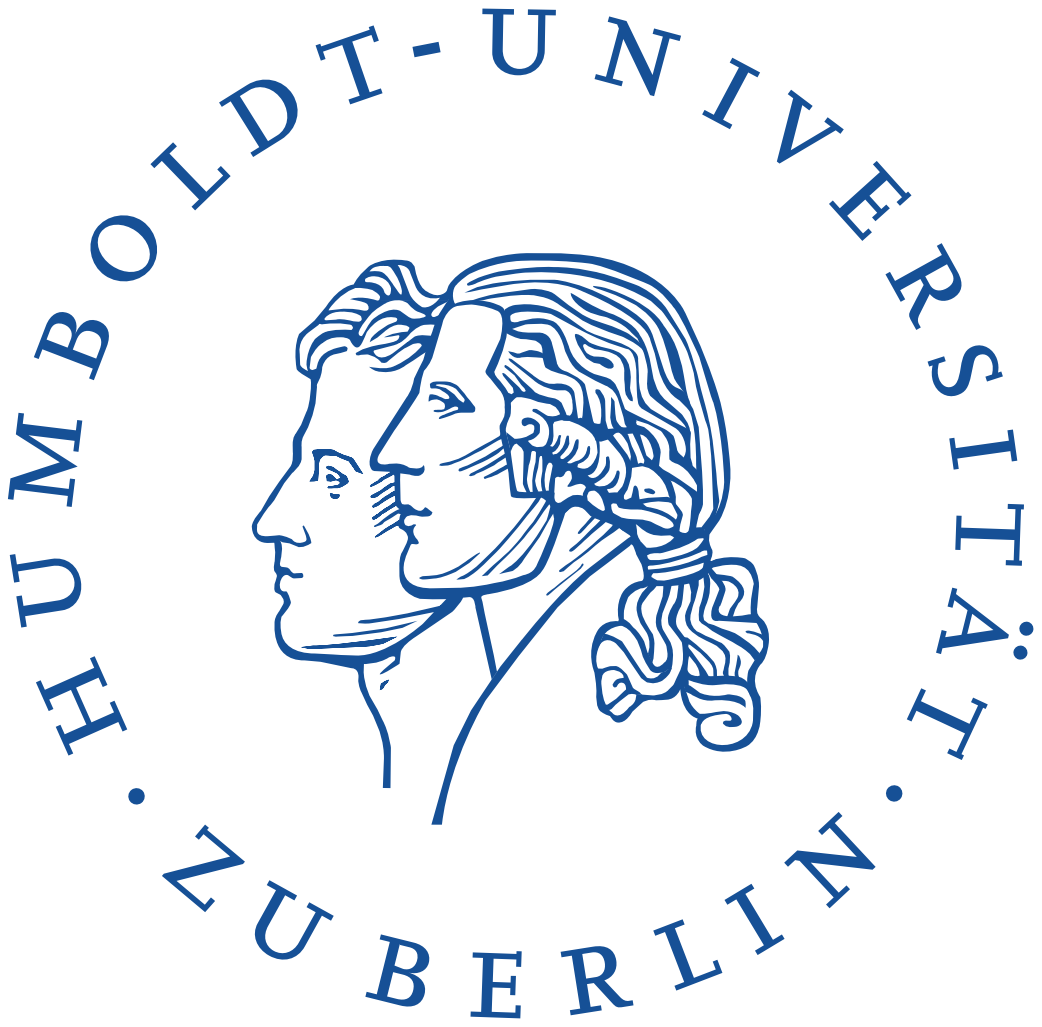
[picture p119: page 1]
