Mo-Barakat/Master-Thesis/Figures/title/scioi-logo.pdf

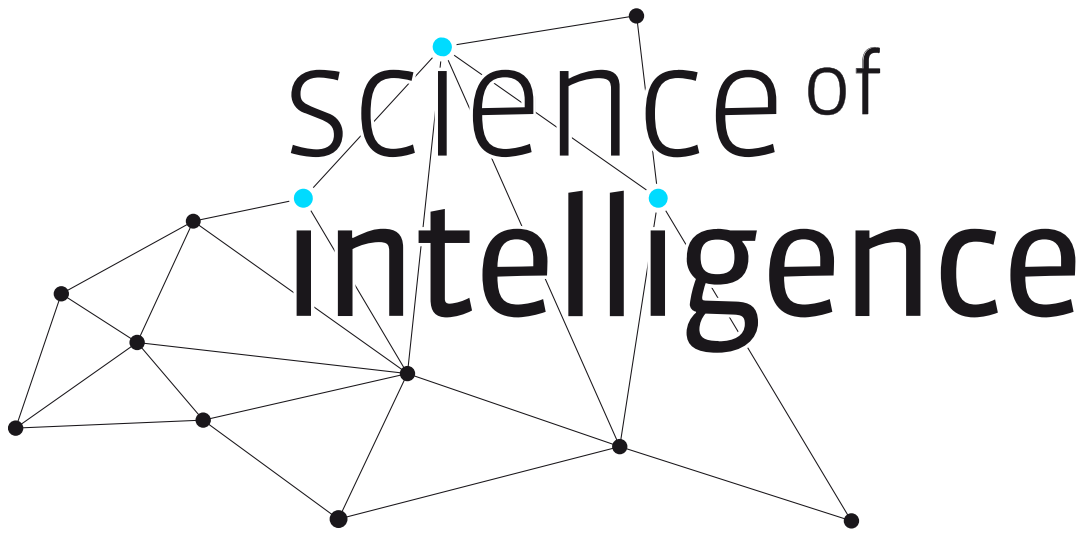
[picture p120: page 1]
