Mo-Barakat/Master-Thesis/Figures/Design/Angles.pdf

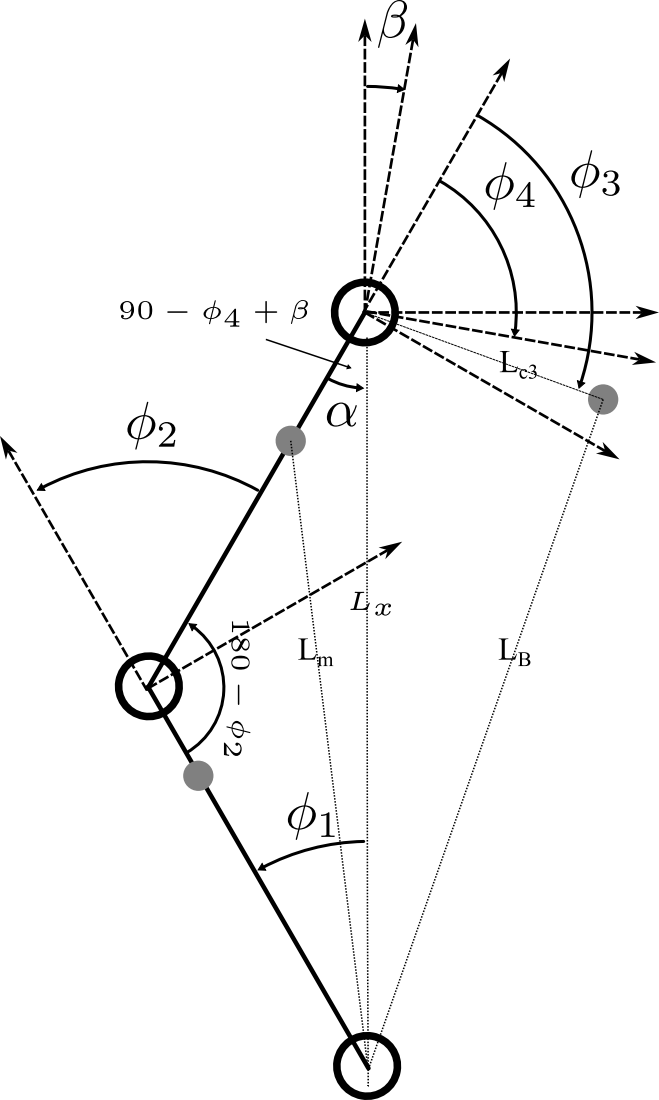
[picture p121: page 1]
