Mo-Barakat/Master-Thesis/Figures/Design/Model.pdf

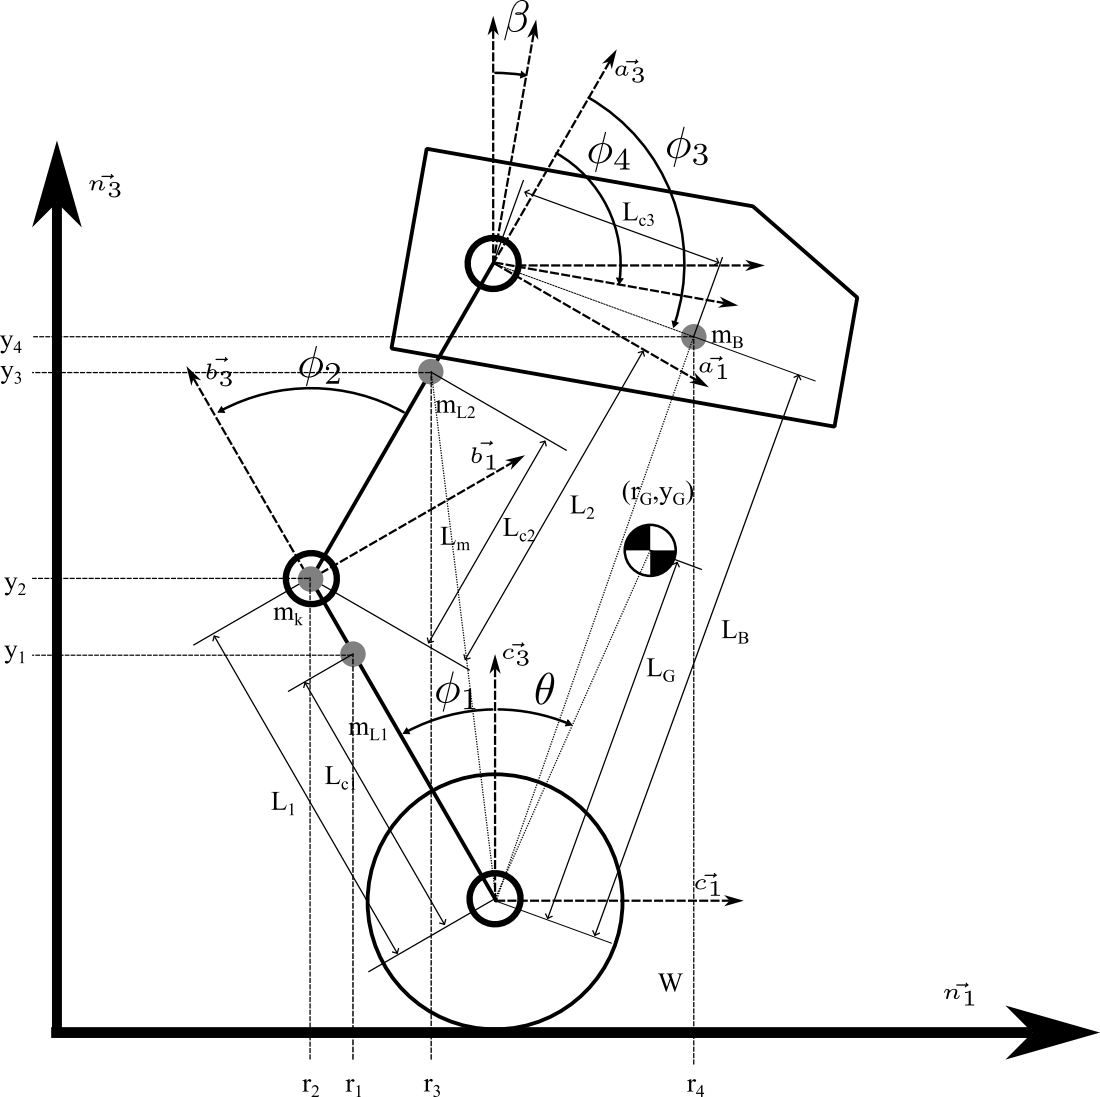
[picture p122: page 1]
