Mo-Barakat/Master-Thesis/Figures/Firmware and Testing/Hardware diagram.pdf

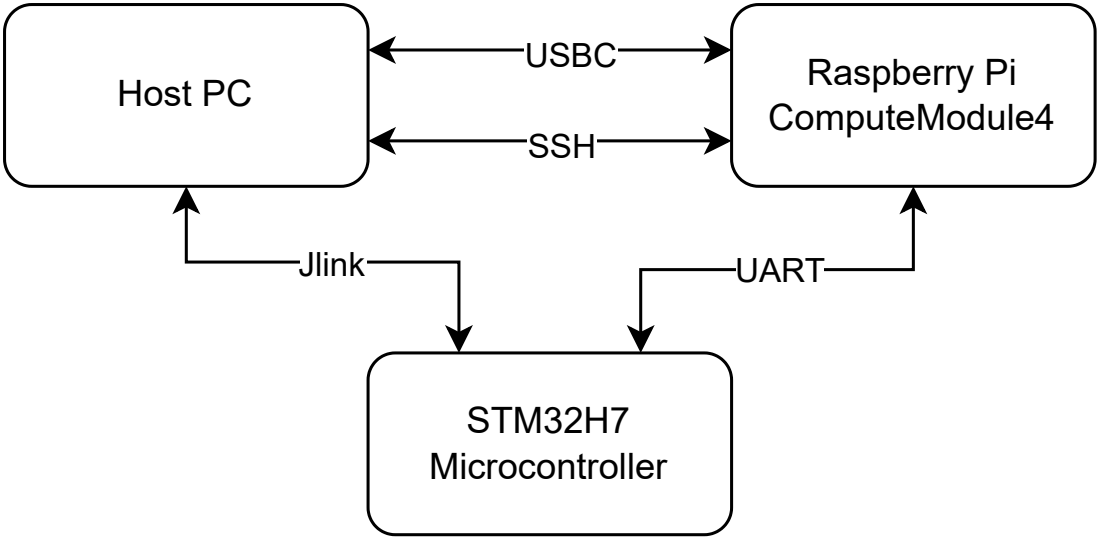
[picture p94: page 1]
STM32H7 Microcontroller; SSH; UART; Raspberry Pi ComputeModule4; USBC; Jlink; Host PC
