Mo-Barakat/Master-Thesis/Figures/Electronic Design/Component_Diagram.pdf

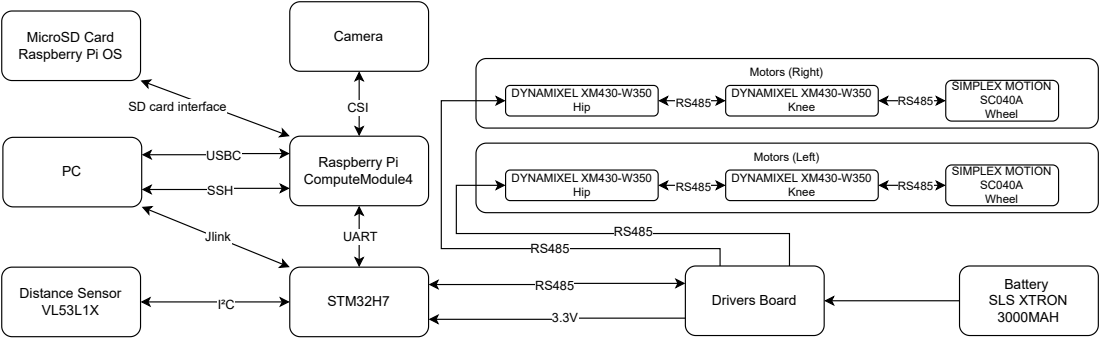
[picture p95: page 1]
I²C; STM32H7; SSH; UART; Raspberry Pi ComputeModule4; CSI; Camera; Drivers Board; Battery SLS XTRON 3000MAH; USBC; Jlink; Distance Sensor VL53L1X; Motors (Right); DYNAMIXEL XM430-W350; Knee; SIMPLEX MOTION SC040A Wheel; Hip; Motors (Left)

MicroSD Card
Raspberry Pi OS

SD card interface
