Mo-Barakat/Master-Thesis/Figures/Mechanical Design/Robot_Assembly_V2_position_1.PDF

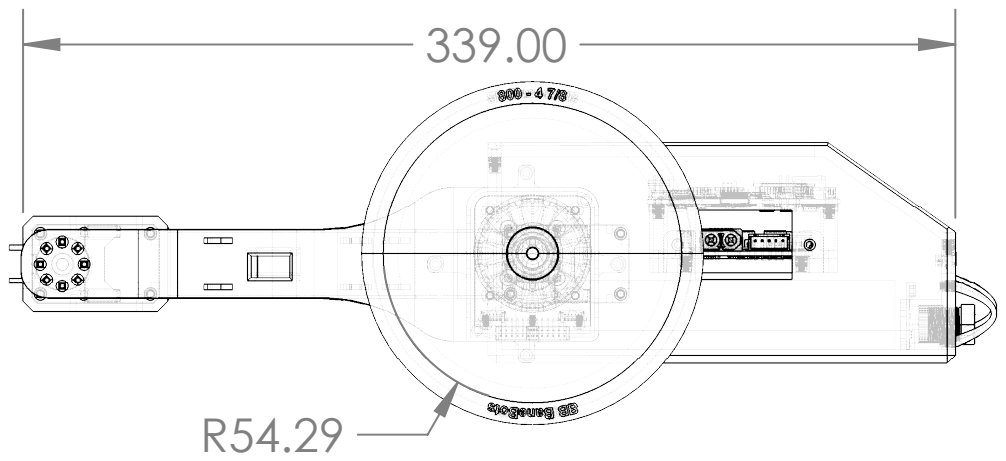
[picture p96: page 1]
