Mo-Barakat/Master-Thesis/Figures/Mechanical Design/Robot_Assembly_V2_position_2.PDF

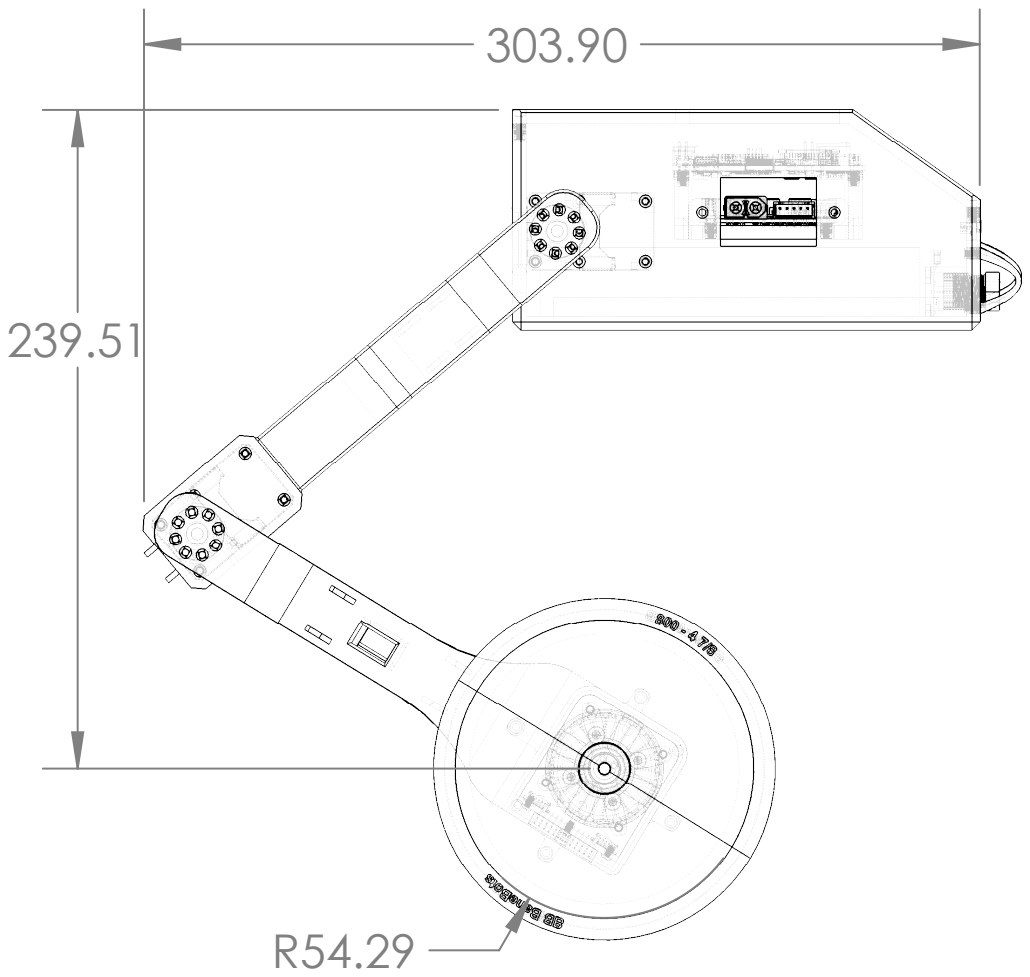
[picture p97: page 1]
