Mo-Barakat/Master-Thesis/Figures/Mechanical Design/Robot_Assembly_V2_position_3.PDF

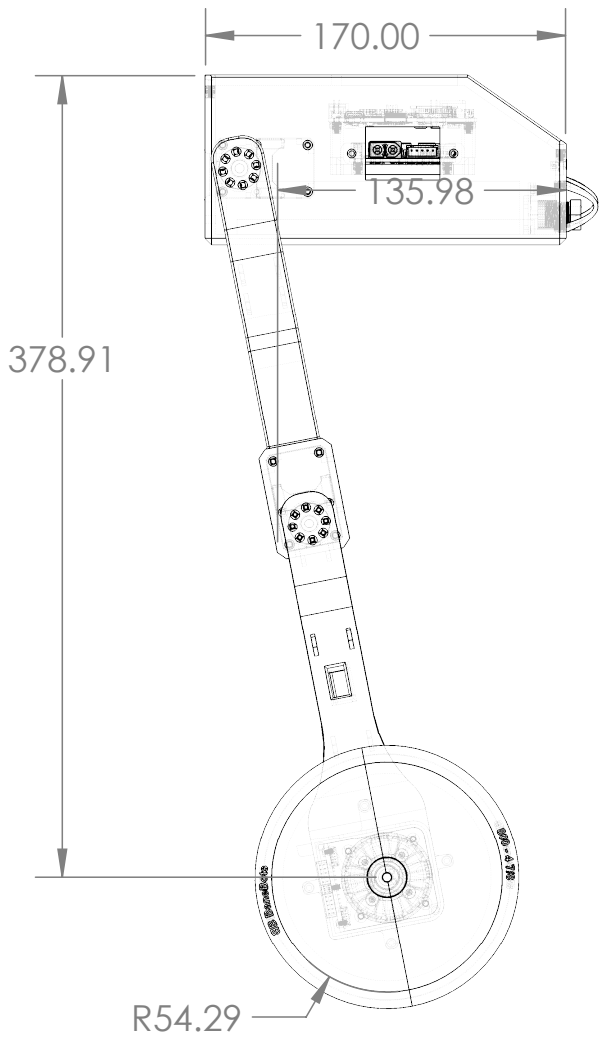
[picture p98: page 1]
