Mo-Barakat/Master-Thesis/Figures/Mechanical Design/Robot_Assembly_V2_Side.PDF

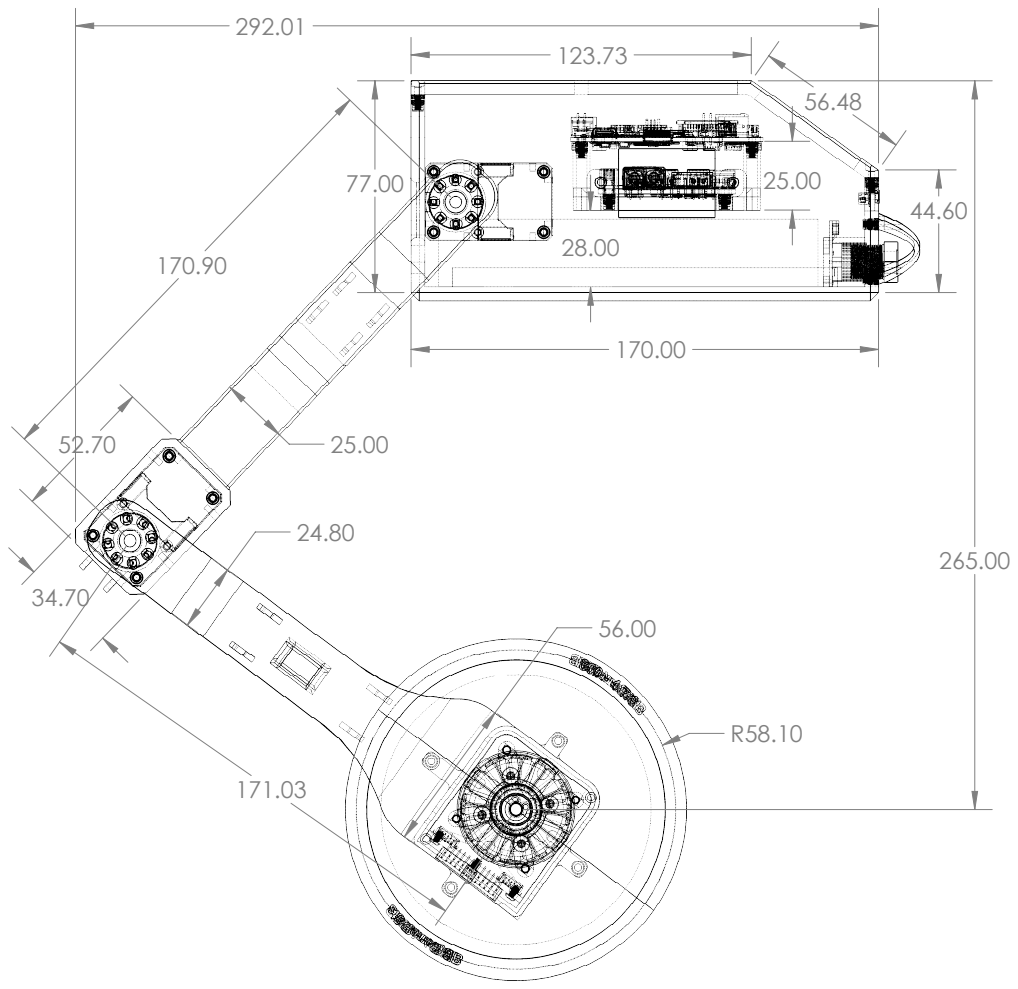
[picture p99: page 1]
