Mo-Barakat/Master-Thesis/Figures/Mechanical Design/Robot_Assembly_V2_Top.PDF

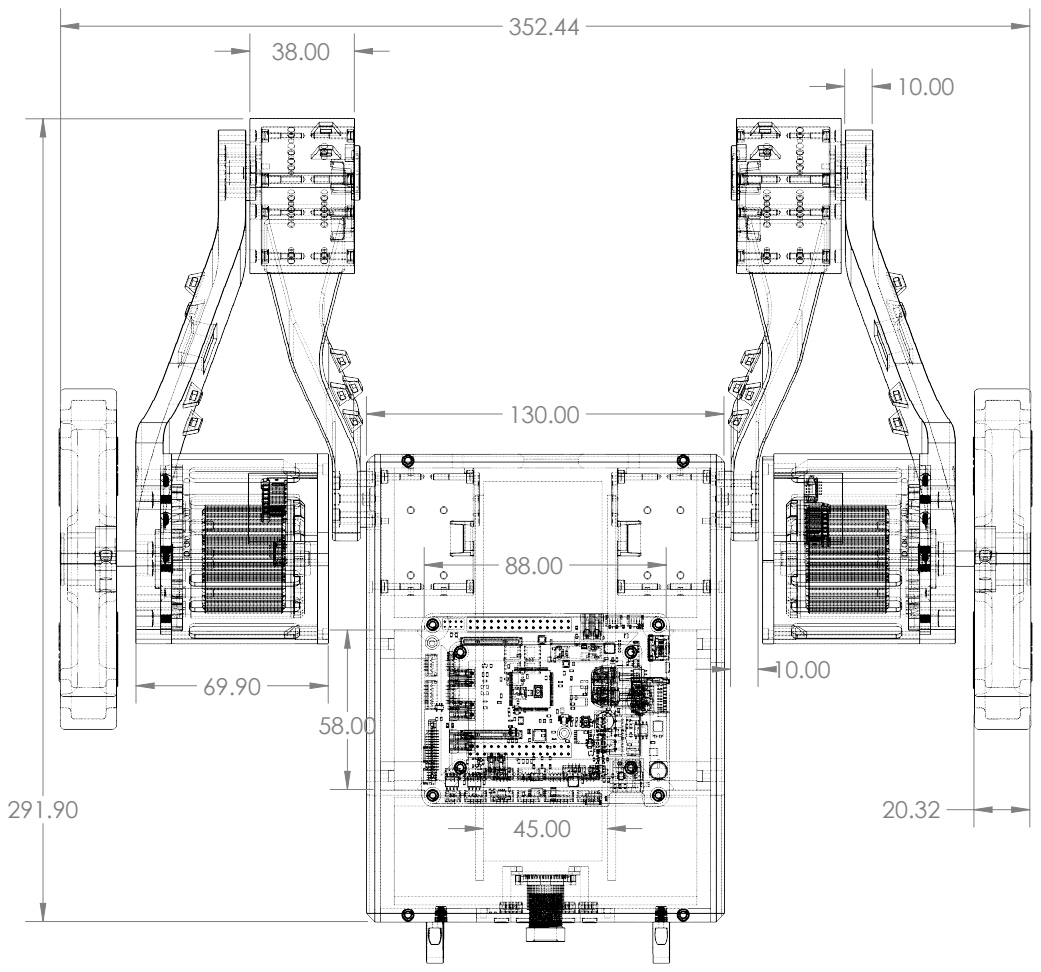
[picture p100: page 1]
