Mo-Barakat/Master-Thesis/Figures/Mechanical Design/schmatic overview of the robot.pdf

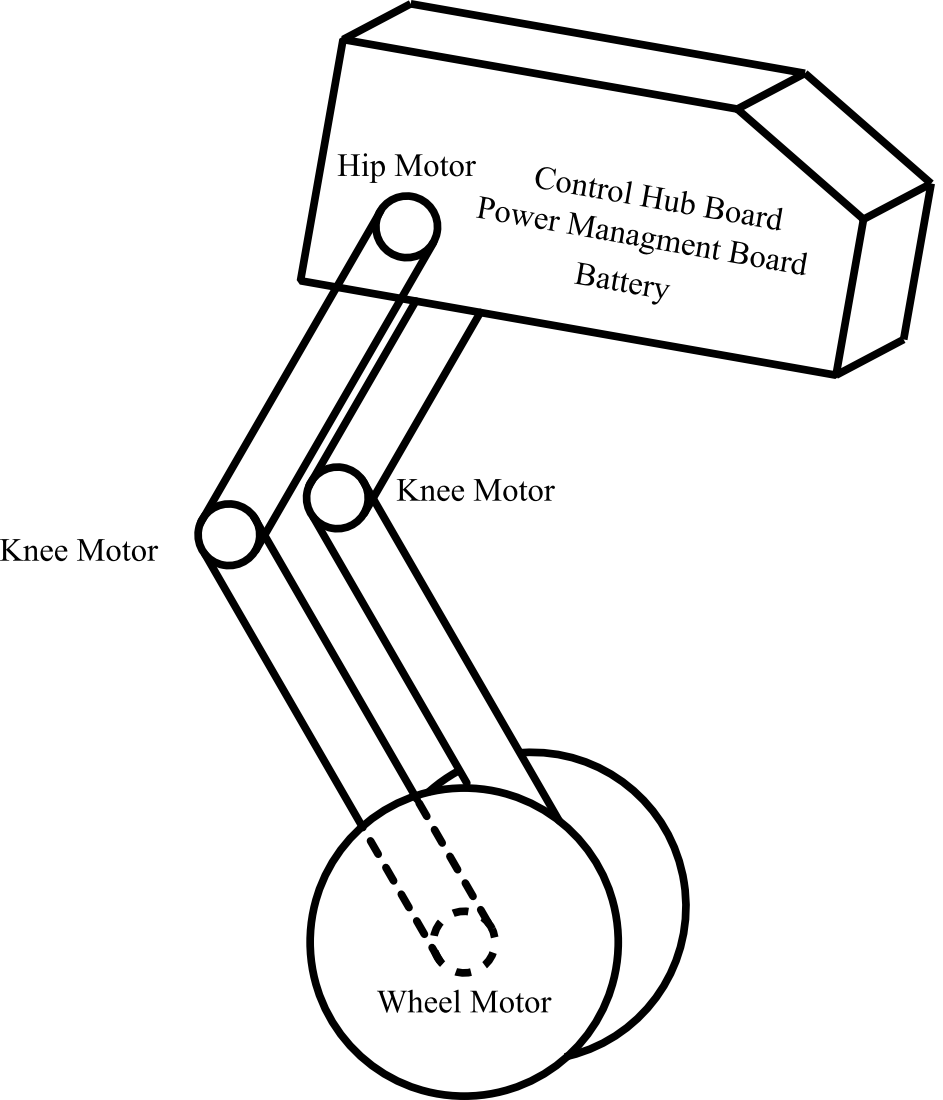
[picture p101: page 1]
