Mo-Barakat/Master-Thesis/Figures/Mechanical Design/Robot_Assembly_V2.pdf

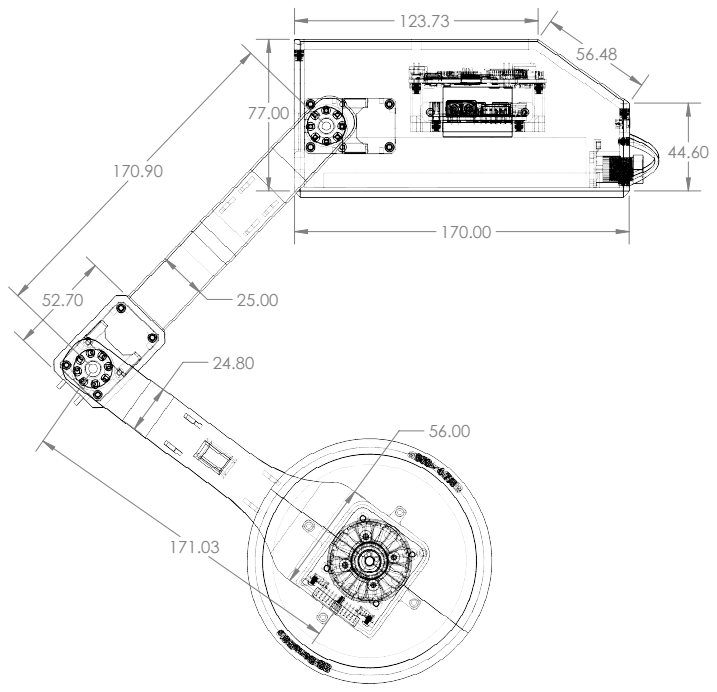
[picture p102: page 1]
