Mo-Barakat/Master-Thesis/Figures/Mechanical Design/Initial Calculations.pdf

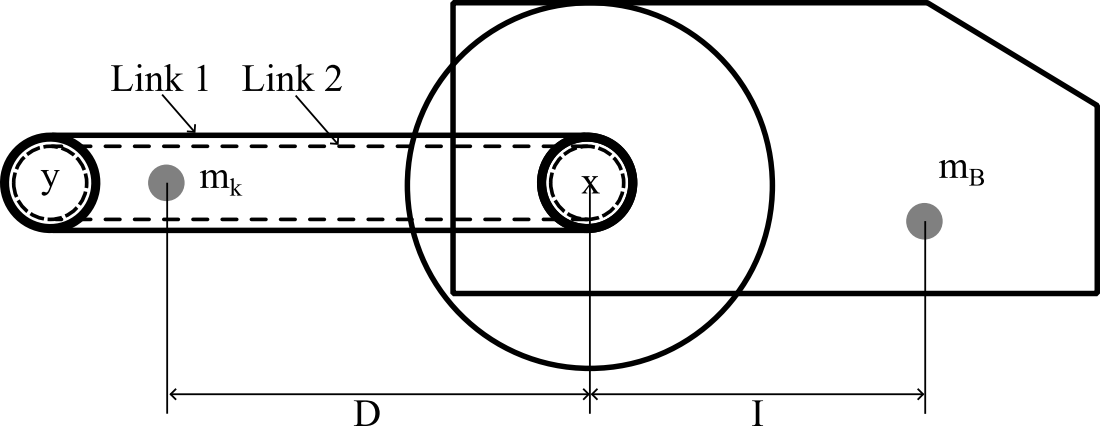
[picture p103: page 1]
