Mo-Barakat/Master-Thesis/Figures/Electronic Design/Legged_TWIPR_Wiring_Tree.pdf

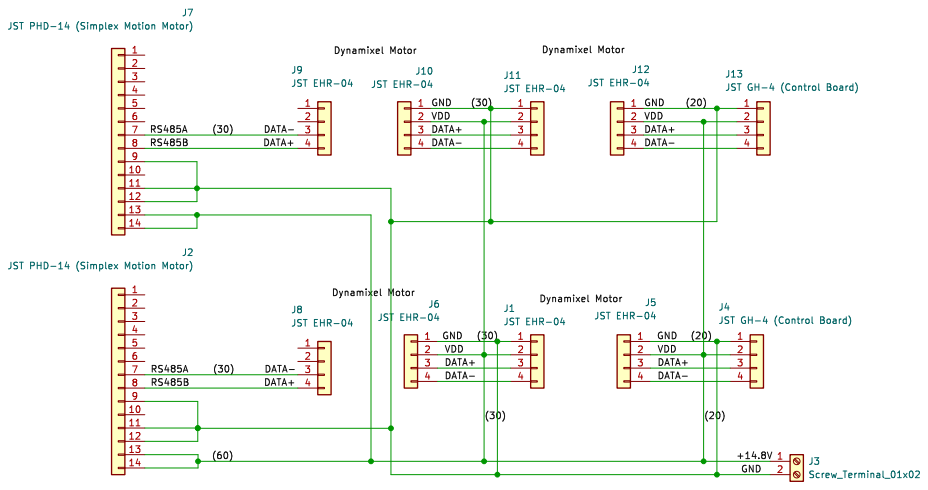
[picture p104: page 1]
