Mo-Barakat/Master-Thesis/Figures/Mechanical Design/Conceptual Design.pdf

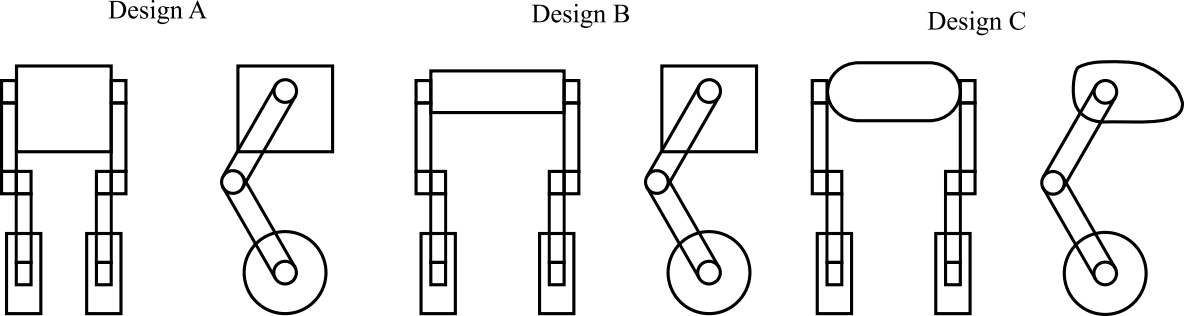
[picture p105: page 1]
