Mo-Barakat/Master-Thesis/Figures/banner.pdf

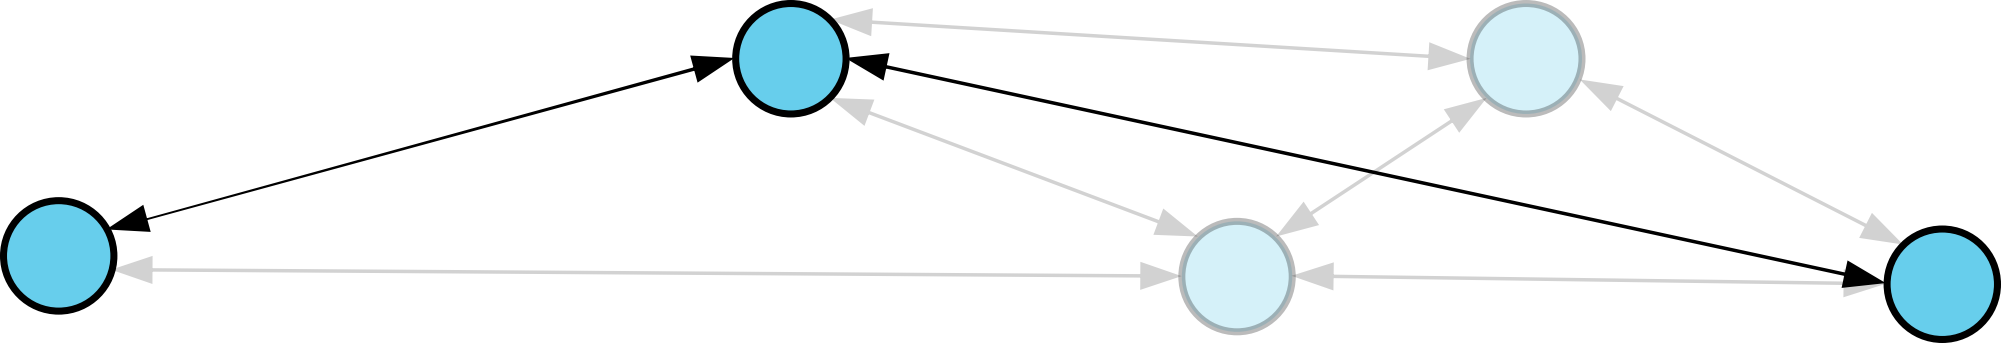
[picture p106: page 1]
