Mo-Barakat/Master-Thesis/Figures/bild.pdf

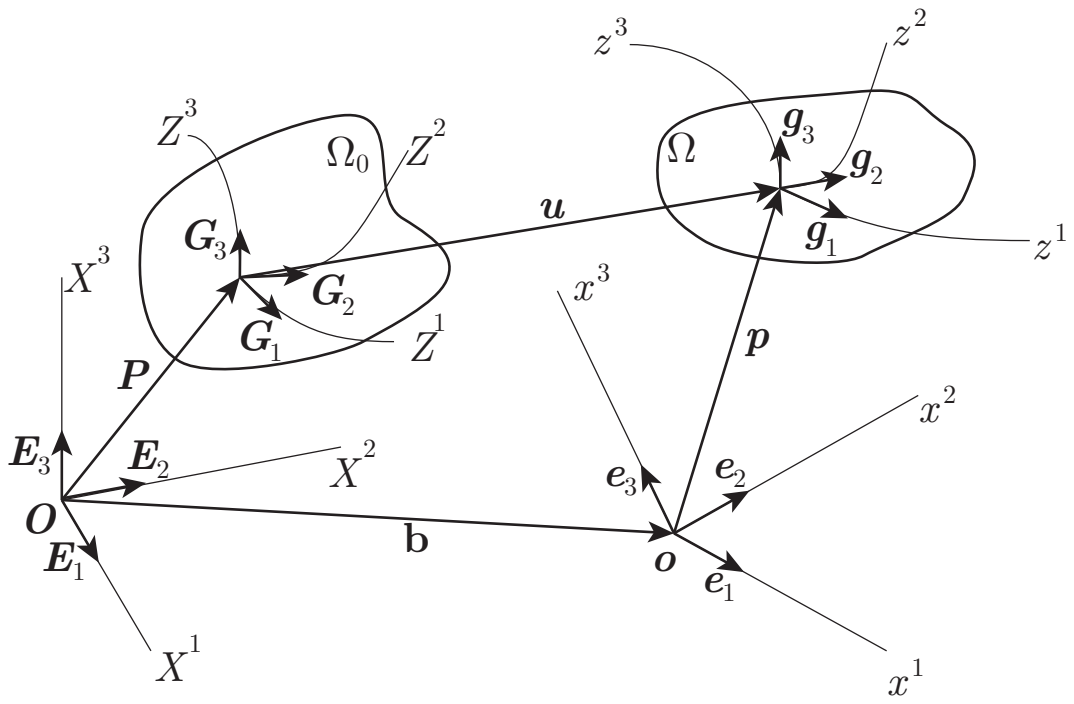
[picture p107: page 1]
