Mo-Barakat/Master-Thesis/Figures/tu-logo-eps-converted-to.pdf

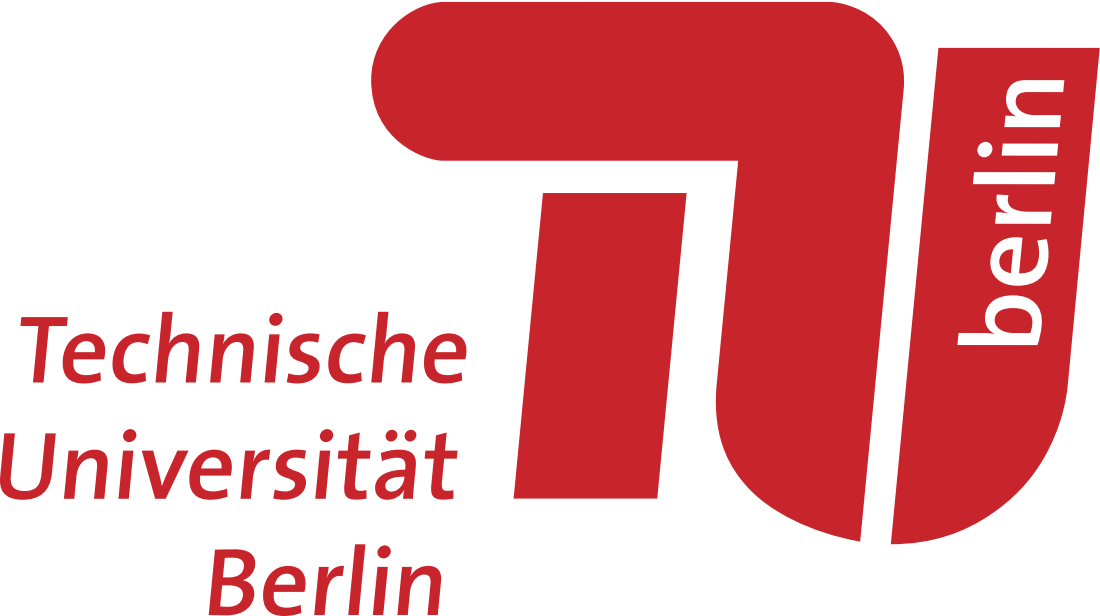
[picture p108: page 1]
