Mo-Barakat/Master-Thesis/Figures/Modelling and Simulation/Block Diagram of State Feedback Controller_simple.pdf

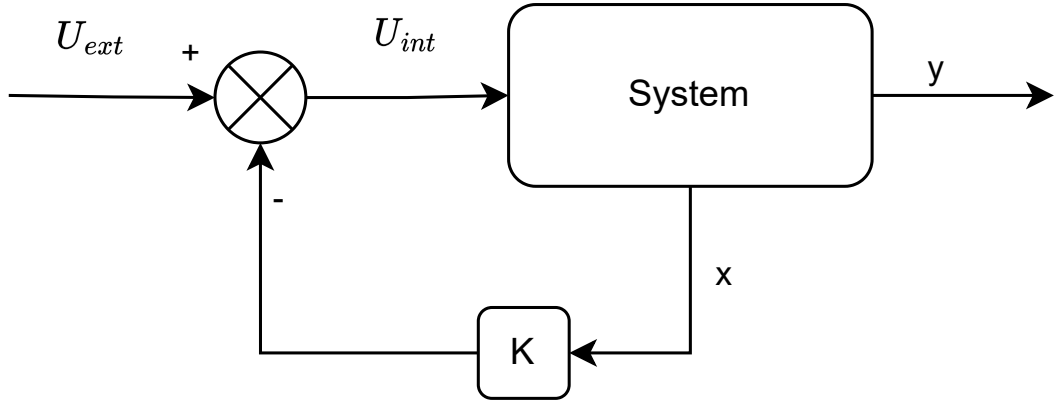
[picture p109: page 1]
System
