Mo-Barakat/Master-Thesis/Figures/Modelling and Simulation/Model.pdf

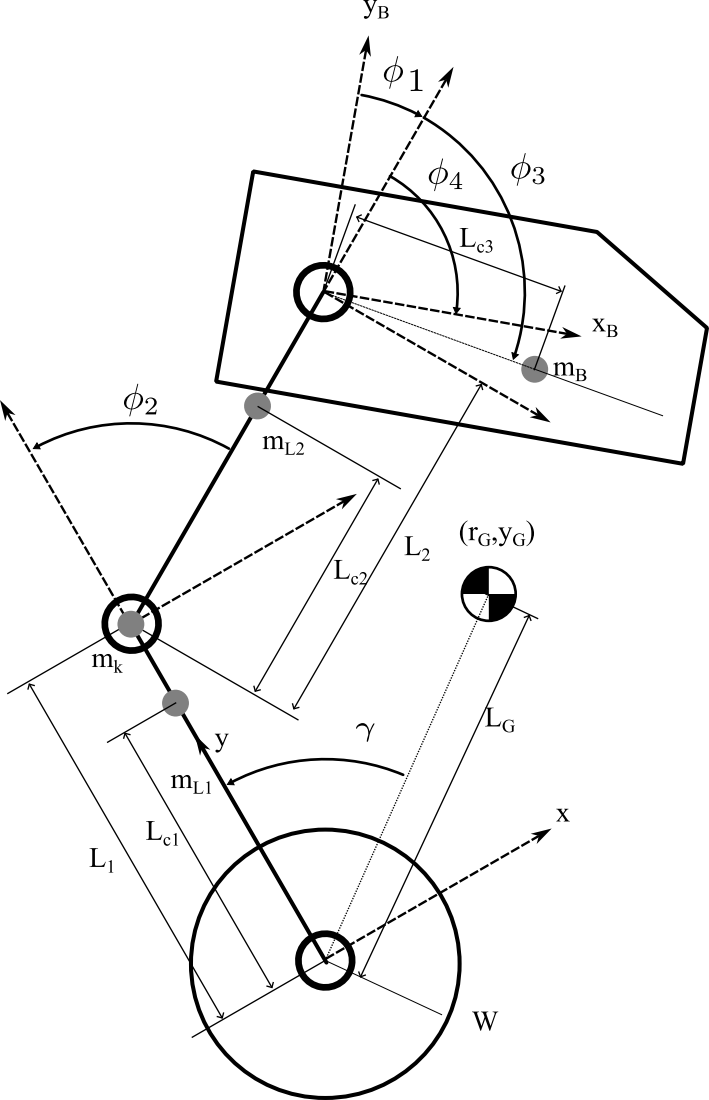
[picture p111: page 1]
