Mo-Barakat/Master-Thesis/Figures/Modelling and Simulation/TWIPR dynamics.pdf

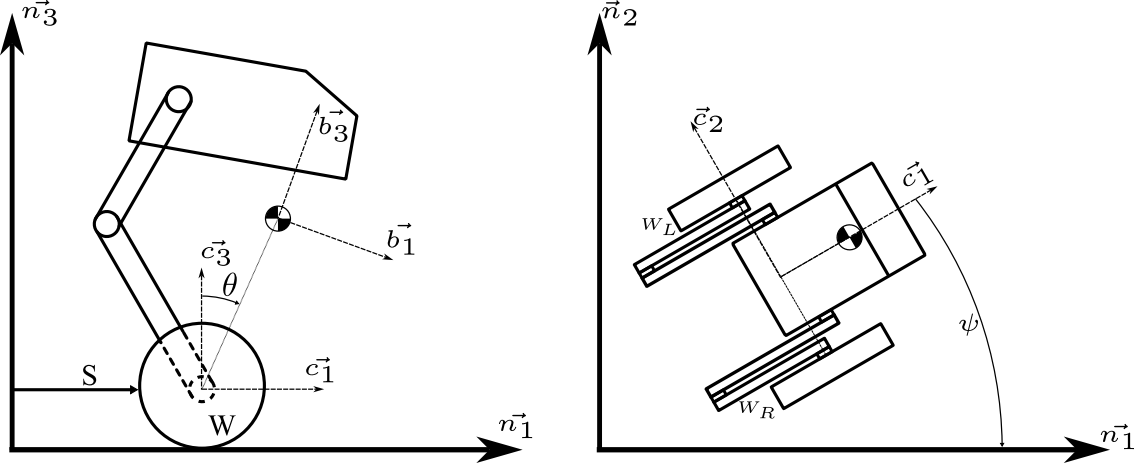
[picture p112: page 1]
