Mo-Barakat/Master-Thesis/Figures/Modelling and Simulation/Comparison between the two external inputs.pdf

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

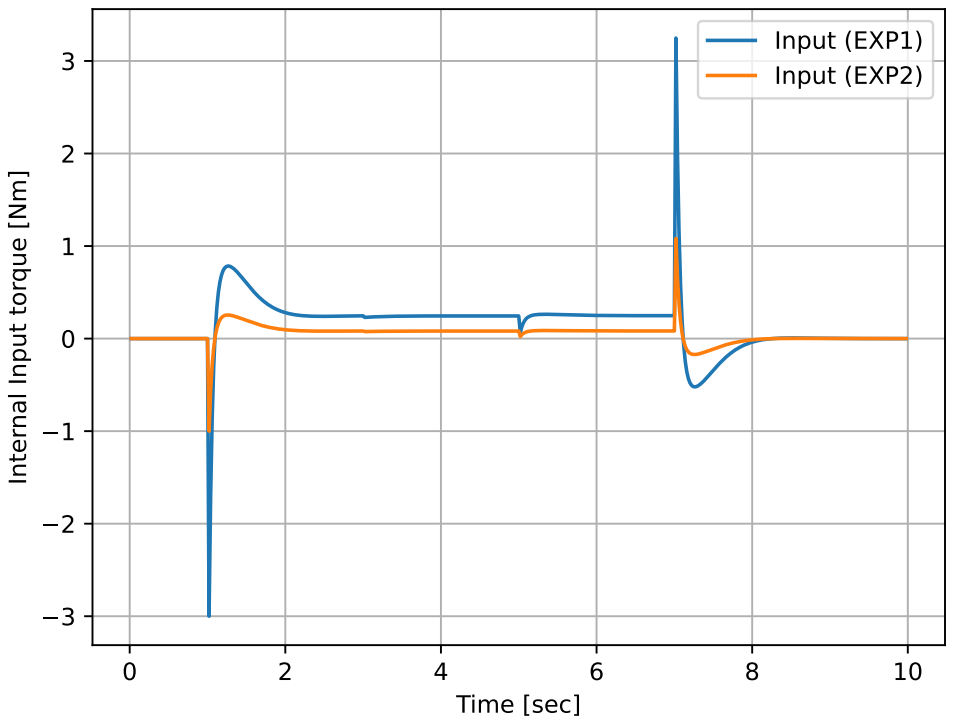
[picture p113: page 1]
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
