Mo-Barakat/Master-Thesis/Figures/Modelling and Simulation/Controller Setting Comparisons.pdf

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

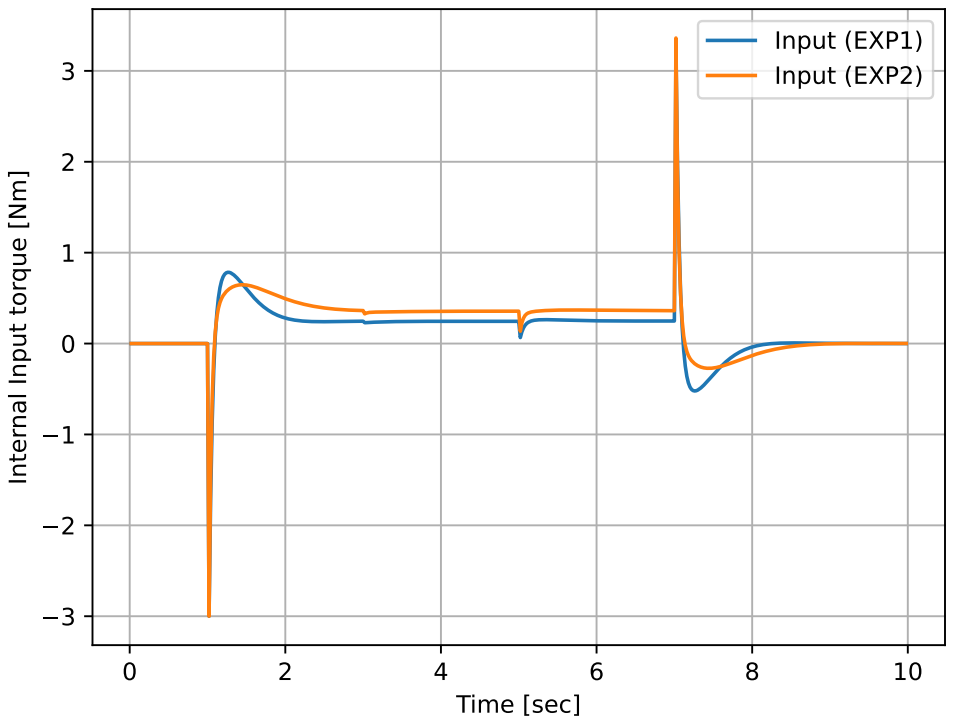
[picture p114: page 1]
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
